omniscientjoker/obd_brz_gauge/docs/VEHICLE_CONFIG.md

# 车型配置开发指南 / Vehicle Configuration Developer Guide

## 概述 / Overview

本项目采用**数据驱动**的车型配置架构。添加新车型**只需编辑 2 个文件**，不需要修改任何解析逻辑代码。

This project uses a **data-driven** vehicle configuration architecture. Adding a new vehicle **only requires editing 2 files** — no parser logic changes needed.

```
默认行为 = OBD2 标准协议 (SAE J1979)
Default  = Standard OBD2 protocol (SAE J1979)

只有在 vehicle_custom_config.h 里声明了的车型，才会使用自定义 CAN 规则或油温公式。
Only vehicles declared in vehicle_custom_config.h use custom CAN rules or oil temp formulas.
```

---

## 文件结构 / File Structure

| 文件 / File | 作用 / Purpose |
|---|---|
| `vehicle_profiles.c` | 车型基础参数 (传动比/档位/轮胎) / Basic params (gear ratios/tire) |
| `vehicle_custom_config.h` | 自定义覆盖 (CAN规则/油温公式/协议) / Custom overrides |
| `vehicle_profiles.h` | 结构体定义 + API / Struct definitions + API |

---

## 添加新车型 / Adding a New Vehicle

### 步骤 1: 基础参数 / Step 1: Basic Parameters

在 `vehicle_profiles.c` 的 `s_profiles[]` 数组末尾添加：

```c
{
    .name = "My Car",                    // 显示名称 / Display name
    .final_drive_ratio = 3.73f,          // 主减速比 / Final drive ratio
    .tire_rolling_radius_m = 0.310f,     // 轮胎滚动半径(m) / Tire rolling radius
    .gear_count = 6,                     // 前进挡数 / Forward gears
    .gear_ratios = {0, 3.63f, 2.38f, 1.56f, 1.18f, 1.00f, 0.81f},
    .gear_tolerance = 0.15f,             // 档位识别容差 / Gear detection tolerance
    // 以下字段可省略，默认值 = 纯 OBD2 标准
    // Fields below are optional, defaults = pure OBD2 standard
},
```

**如果新车只需要标准 OBD2**，到这里就结束了！不需要步骤 2。

**If the new car only needs standard OBD2**, you're done! Skip to step 2 is not needed.

---

### 步骤 2: 自定义覆盖 (可选) / Step 2: Custom Overrides (Optional)

在 `vehicle_custom_config.h` 中添加 CAN 规则和/或油温公式，然后在 `s_vehicle_overrides[]` 表中注册。

#### 2a. CAN 广播解码规则 / CAN Broadcast Decode Rules

如果车型支持通过 CAN 总线广播帧读取数据 (比 OBD2 PID 更快)：

```c
// 定义规则表 / Define rule table
static const can_rule_t can_rules_mycar[] = {
    // CAN_ID  位偏移  位长  乘数        偏移    通道
    { 0x140,   16,    14,   1.0f,       0.0f,  CH_RPM },
    { 0x140,   48,     8,   100.0f/255, 0.0f,  CH_TPS },
    { 0x360,   16,     8,   1.0f,     -40.0f,  CH_OIL_TEMP },
    { 0x360,   24,     8,   1.0f,     -40.0f,  CH_COOLANT },
};
```

**位域说明 / Bit field explanation:**
- `bit_off`: 从 LSB 开始的位偏移。Byte0 bit0 = 0, Byte0 bit7 = 7, Byte1 bit0 = 8, ...
- `bit_len`: 位长度。14 位 = 最大 16383
- `scale/offset`: 最终值 = raw × scale + offset

**可用通道 / Available channels:**
`CH_RPM`, `CH_SPEED`, `CH_OIL_TEMP`, `CH_COOLANT`, `CH_TPS`, `CH_LOAD`, `CH_INTAKE`, `CH_BOOST`,
`CH_TPMS_FL`, `CH_TPMS_FR`, `CH_TPMS_RL`, `CH_TPMS_RR`

### 四轮胎压 CAN 规则 / TPMS CAN rules

TPMS 规则的最终值单位必须是 `bar`。四个轮位可以来自同一帧或不同帧；解码器会保留已收到的轮位，直到它们超时失效。

```c
// 以下 CAN ID、字节位置与公式仅是结构示例，不能直接用于任何福特车辆。
static const can_rule_t can_rules_ford_tpms[] = {
    { 0x000, 0, 8, 0.01f, 0.0f, CH_TPMS_FL },
    { 0x000, 8, 8, 0.01f, 0.0f, CH_TPMS_FR },
    { 0x000, 16, 8, 0.01f, 0.0f, CH_TPMS_RL },
    { 0x000, 24, 8, 0.01f, 0.0f, CH_TPMS_RR },
};
```

在把 Ford 规则加入车型表前，必须通过实车 CAN 日志确认 CAN ID、轮位和换算公式。不要用猜测的 ID 启用 CAN 监听。

#### 2b. 油温公式 / Oil Temperature Formula

```c
// 标准 PID 01 5C / Standard PID
static const oil_formula_t oil_std = {
    OIL_STD_PID, {0x5C}, 1, 0, 1, 1.0f, -40.0f, 0
};

// UDS Mode 22 (单字节) / UDS single byte
static const oil_formula_t oil_uds_1byte = {
    OIL_UDS_22, {0x11,0x1F}, 2, 0, 1, 1.0f, -50.0f, 0
};

// UDS Mode 22 (双字节大端) / UDS double byte big-endian
static const oil_formula_t oil_uds_2byte = {
    OIL_UDS_22, {0x13,0x10}, 2, 0, 2, 0.01f, -40.0f, 0
};
```

**公式类型 / Formula types:**

| 类型 / Type | 说明 / Description | 命令格式 / Command |
|---|---|---|
| `OIL_STD_PID` | 标准 Mode 01 | `01 XX\r` |
| `OIL_UDS_22` | UDS Mode 22 | `22 XX XX\r` |
| `OIL_SPECIAL` | 特殊解析 (需额外代码) | 自定义 / Custom |

#### 2c. Ford BCM Mode 22 胎压候选 / Ford BCM Mode 22 TPMS candidate

当前工程的 `Mondeo 2.0T TPMS (candidate)` 配置先采用公开 Fusion Hybrid 资料作为待验证方案：请求头为 `ATSH726`，每次发送一个 `22 DID`，压力原始值为响应中的两个大端字节，公式为：

```text
pressure_bar = raw_u16 × 0.05 × 0.0689475729
```

轮位与 DID 映射为：`FL=2813`、`FR=2814`、`RL=2816`、`RR=2815`。例如 `62 28 13 02 80` 中 `raw=0x0280=640`，结果约为 `2.21 bar`。该映射和公式来自北美/欧洲 Fusion 资料，尚未证明适用于中国版 2014 Mondeo；实车验证时应记录 FORScan BCMii 的 DID、响应字节和机械表压力，再替换 `tpms_fusion_candidate[]`。

#### 2d. 注册覆盖 / Register Override

在 `s_vehicle_overrides[]` 数组中添加：

```c
{
    .match_name      = "My Car",              // 必须与 vehicle_profiles.c 中的 name 完全匹配
    .can_rules       = can_rules_mycar,       // CAN 规则 (NULL = 不用 CAN)
    .can_rule_count  = 4,
    .oil_primary     = &oil_uds_1byte,        // 油温主公式 (NULL = 标准 01 5C)
    .oil_secondary   = &oil_std,              // 备用公式 (主公式连续失败后回退)
    .forced_protocol = 6,                     // ELM327 协议 (0 = 自动探测)
    .functional_addr = false,                 // true = ATSH7DF (BMW 等)
    .obd_timeout     = 0x0F,                  // ATST 超时 (0 = 默认 0x19)
    .has_boost       = false,                 // 涡轮车 = true
    .poll_gap_ms     = 1,                     // 轮询间隔 ms (0 = 默认 30ms)
},
```

---

## 完整示例 / Complete Example

添加一辆 Mazda MX-5 ND (已有配置，作为参考)：

```c
// vehicle_profiles.c — 基础参数
{
    .name = "MX-5 ND",
    .final_drive_ratio = 2.866f,
    .tire_rolling_radius_m = 0.300f,
    .gear_count = 6,
    .gear_ratios = {0, 5.087f, 2.991f, 2.035f, 1.594f, 1.286f, 1.000f},
    .gear_tolerance = 0.15f,
},

// vehicle_custom_config.h — 自定义覆盖
static const oil_formula_t oil_mazda_1310 = {
    OIL_UDS_22, {0x13,0x10}, 2, 0, 2, 0.01f, -40.0f, 0
};
static const oil_formula_t oil_mazda_111f = {
    OIL_UDS_22, {0x11,0x1F}, 2, 0, 1, 1.0f, -50.0f, 0
};

// 在 s_vehicle_overrides[] 中:
{
    .match_name  = "MX-5 ND",
    .oil_primary = &oil_mazda_1310,
    .oil_secondary = &oil_mazda_111f,
    .obd_timeout = 0x0A,
    .poll_gap_ms = 1,
},
```

---

## 运行时查找逻辑 / Runtime Lookup

```
vehicle_profile_get_override()
    ├── 找到 override → 使用自定义 CAN 规则 / 油温公式
    └── 返回 NULL    → 纯 OBD2 标准协议 (01 0C/0D/05/5C/0F/04/11/42)
```

---

## CAN 规则解析器 API / CAN Rule Parser API

```c
// 通用位域提取 / Generic bit extraction
bool can_extract_bits_le(const uint8_t data[8],
                         uint8_t bit_off, uint8_t bit_len,
                         uint32_t *out);

// 遍历规则表, 匹配 CAN ID, 写入 channels[] / Apply rules to channels
void can_apply_rules(const can_rule_t *rules, uint8_t count,
                     uint16_t can_id, const uint8_t data[8],
                     float channels[CH_COUNT]);

// 构建油温查询命令 / Build oil temp query command
const char *oil_formula_build_cmd(const oil_formula_t *f,
                                  char *buf, size_t buflen);

// 解析油温响应 / Parse oil temp response
int16_t oil_formula_parse_resp(const oil_formula_t *f,
                               const uint32_t *resp_data,
                               uint8_t resp_len);
```

---

## 注意事项 / Notes

1. **name 必须完全匹配** — `vehicle_profiles.c` 和 `vehicle_custom_config.h` 中的 `match_name` 必须字符串完全一致。
2. **OIL_SPECIAL 类型** — 目前用于 Toyota Mode 21 及其他少量遗留特殊解析，这类逻辑较复杂，仍需 `elm327_ble_client.c` 中的专用代码处理。未来可逐步迁移。
3. **CAN 规则中的位偏移** — 采用 SAE J1939 风格的位编号：Byte0 的 LSB = bit 0，Byte1 的 LSB = bit 8。
4. **双字节公式** — `resp_bytes=2` 时按大端序组合：`value = data[byte] * 256 + data[byte+1]`。
5. **回退机制** — `oil_primary` 连续失败 5 次后自动切换到 `oil_secondary`。

---

## 迁移状态 / Migration Status

当前 `vehicle_custom_config.h` 已包含所有车型的覆盖配置数据表。`elm327_ble_client.c` 中的旧 switch/case 代码仍在运行，后续将逐步迁移到通用解析器。新旧代码通过 `vehicle_profile_get_override()` 桥接。

The `vehicle_custom_config.h` already contains override data for all vehicles. The legacy switch/case in `elm327_ble_client.c` is still active and will be migrated to the generic parsers incrementally. The bridge is `vehicle_profile_get_override()`.
