omniscientjoker/obd_brz_gauge/hardware/electronics/power_pd_3x5v_r3/huaqiu/01_PCB/VIPPO_HOLES.csv

Via_ID | Gerber_X_mm | Gerber_Y_mm | CPL_X_mm | CPL_Y_mm | Drill_mm | Net | Pads_to_review
0e456552-56f2-44fa-b054-f9a385a9bfb4 | 99.200000 | -110.920000 | 40.200000 | 16.580000 | 0.3 | /GND | UPD.11; UPD.paste
114b2d22-c867-4a10-897a-41550a063cea | 120.720000 | -106.100000 | 61.720000 | 21.400000 | 0.3 | /GND | U4.9; U4.paste
163f1c95-62bf-4fa8-81e0-24cd7ac145cc | 76.620000 | -105.400000 | 17.620000 | 22.100000 | 0.3 | /GND | U2.9; U2.paste
1710671c-4a24-4615-903f-2607074c7a94 | 76.620000 | -106.100000 | 17.620000 | 21.400000 | 0.3 | /GND | U2.9; U2.paste
1b0cda9b-186d-41db-aa2c-3c16d014d6e4 | 99.100000 | -112.820000 | 40.100000 | 14.680000 | 0.3 | /GND | UPD.11; UPD.paste
2441409e-41e9-4236-9071-cb9c7f7919b5 | 109.455000 | -85.720000 | 50.455000 | 41.780000 | 0.3 | /PRE_CENTRE | COUT3A.1
2ded97ac-5890-47ff-a0bc-a73e4bc1ce08 | 123.100000 | -119.410000 | 64.100000 | 8.090000 | 0.3 | /UV_IN | RUVINL.1
3136d08a-dee5-408d-994e-a182a233d700 | 120.220000 | -103.900000 | 61.220000 | 23.600000 | 0.3 | /GND | U4.9; U4.paste
337a6ea5-dd0f-4ca0-b42b-aeff975e14ff | 97.450000 | -105.500000 | 38.450000 | 22.000000 | 0.3 | /GND | U3.9; U3.paste
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
