omniscientjoker/obd_brz_gauge/hardware/electronics/power_pd_3x5v_r4/huaqiu/01_PCB/VIPPO_HOLES.csv

# No VIPPO required for R4: SMD pad/via intersections = 0.
Via_ID | Gerber_X_mm | Gerber_Y_mm | CPL_X_mm | CPL_Y_mm | Drill_mm | Net | Pads_to_review
