omniscientjoker/obd_brz_gauge/hardware/3dModel/base_detail.png

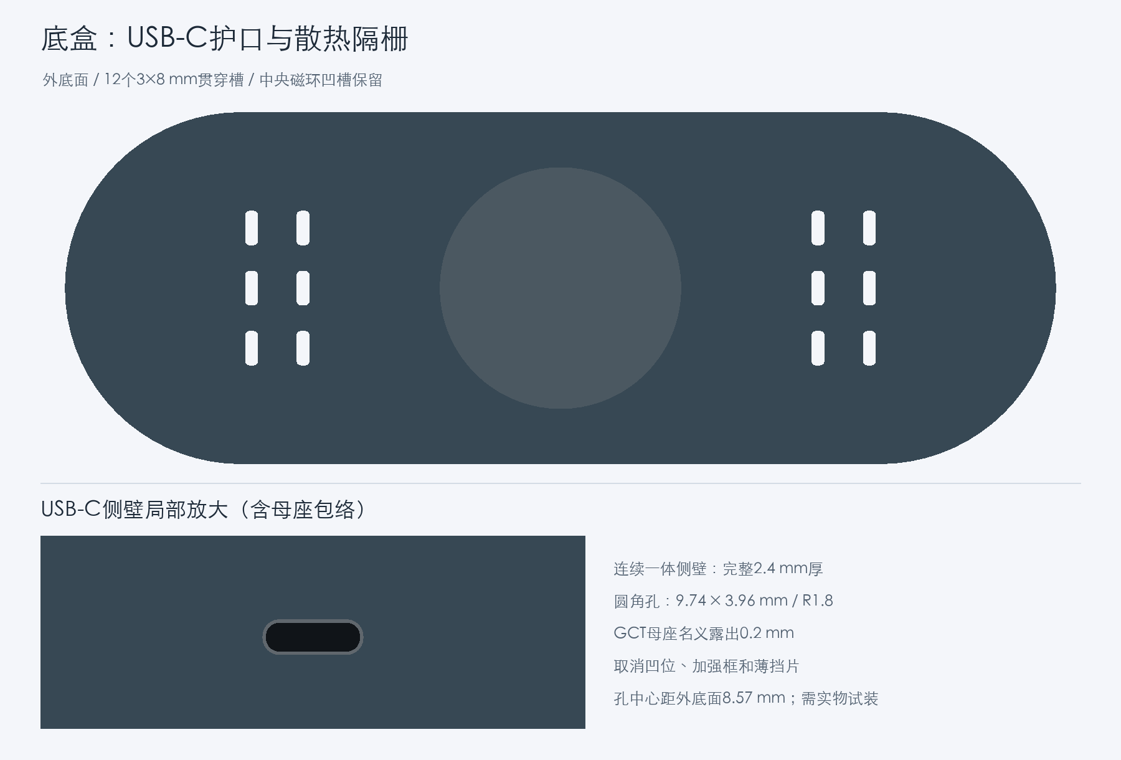
hardware/3dModel/base_detail.png
