omniscientjoker/obd_brz_gauge/hardware/3dModel/carrier_detail.png

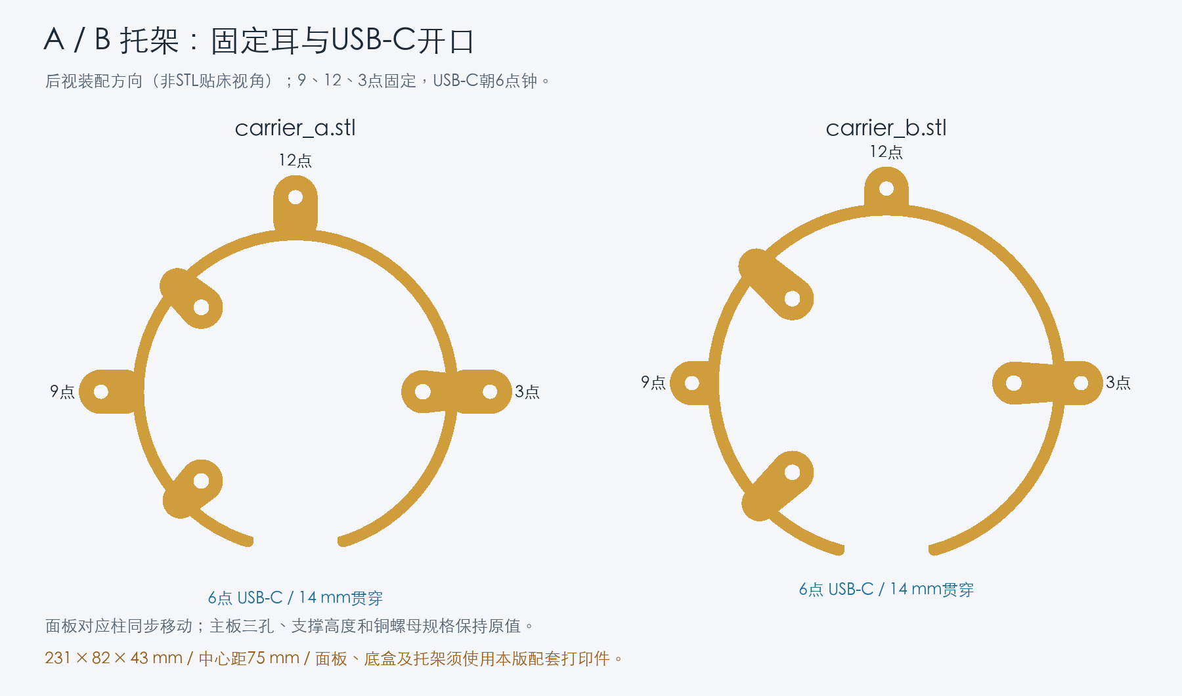
hardware/3dModel/carrier_detail.png
