omniscientjoker/obd_brz_gauge/hardware/3dModel/preview.png

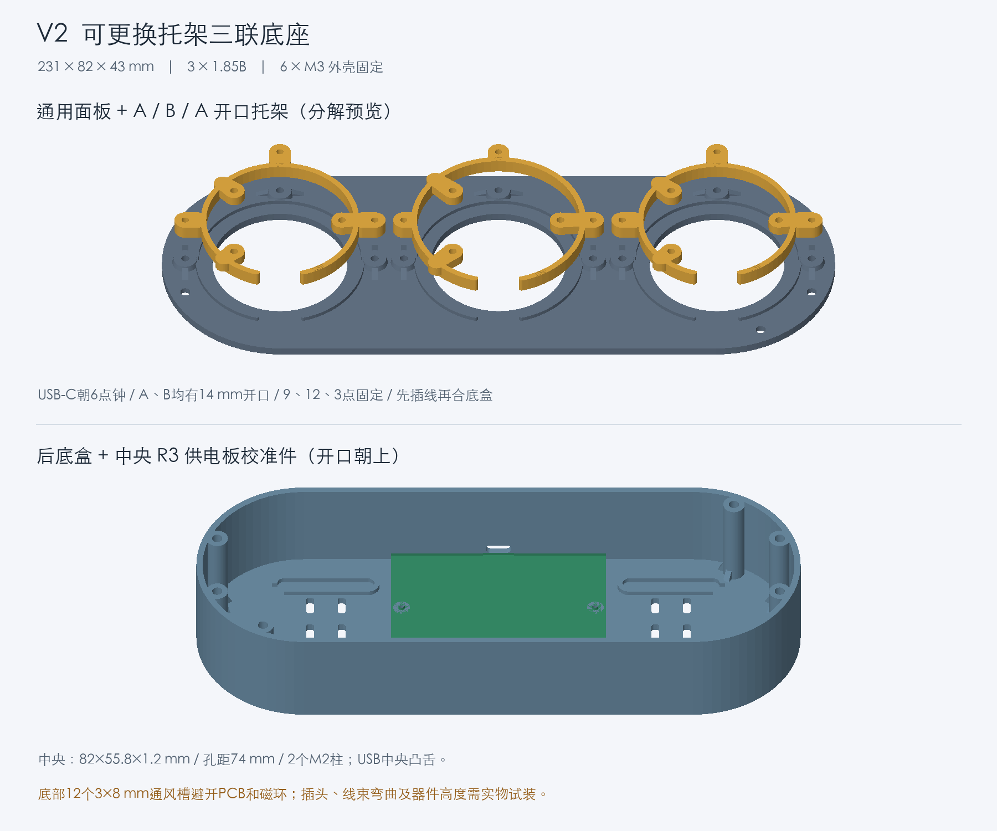
hardware/3dModel/preview.png
