omniscientjoker/obd_brz_gauge/hardware/electronics/placement.png

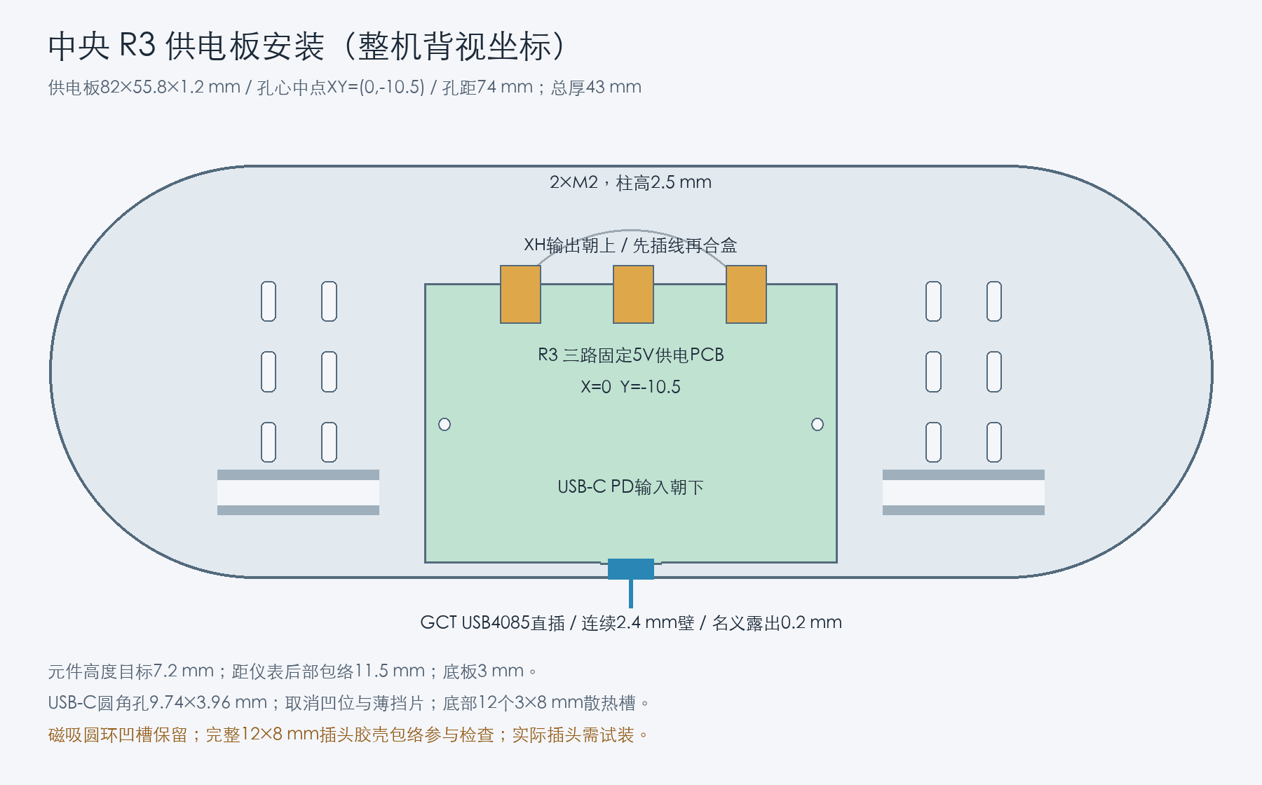
hardware/electronics/placement.png
