omniscientjoker/obd_brz_gauge/hardware/electronics/power_pd_3x5v_r4/huaqiu/HUAQIU_ORDER_REMARKS.txt

项目：三联仪表三路5V电源板，交付R4-HUAQIU-20261026-R1，电气R4-ERC-20261026。
PCB：4层FR-4，建议Tg≥150°C，82×55.8mm，成品厚1.2mm，内外层目标35µm/1oz，沉金，绿油双面白字。
盘中孔：R4无SMD焊盘内过孔，不需要VIPPO树脂塞孔；`01_PCB/VIPPO_HOLES.csv`为空表。请按Gerber/CAM确认普通过孔、阻焊桥和钢网开口。
装配：每板双面SMT82件（Top31/Bottom51），另有4件THT后焊，总86件、31种制造商MPN。J1=GCT USB4085-GF-A；J2/J3/J4=JST S2B-XH-A(LF)(SN)。
输入：固定15V PD；三路约5V，每路1.5A设计负载。先做首板带载、纹波、保护和封闭底盒温升验收。
