omniscientjoker/obd_brz_gauge/outputs/huaqiu_pcba_20261026_r1/huaqiu_official_bom_template.xls

序号 | 产品分类 | 品牌 | 型号* | 规格参数描述* | 封装* | 位号* | 单机用量* | 备注
1 | 贴片电容 | FH | 0402B103K250NT | 25V 10nF | 402 | C3,C4,C5,C6 | 4
2 | 贴片电容 | Samsung | CL05B104K05NNNC | 16V 100nF | 402 | C1,C2, | 2
3 | 肖特基二极管 | MDD | 1N5819 |  | SOD-323 | D1,D2 | 2
4 | IC | ROHM | BR24L08FV-WE2 |  |  | U3 | 1
5 | IC | ROHM | BR34E02FVT-3E2 |  |  | U2, U3 | 2
6 | 贴片电阻 | UniOhm | 0402WGF330JTCE | 33Ω | 402 | R4 | 1
7 | 贴片电阻 | Uniohm | 0402WGF1001TCE | 1KΩ | 402 | R1,R2,R3,R4 | 4
8 | 贴片电阻 | UniOhm | 0603WAJ0105T5E | 1MΩ | 603 | R5 | 1
9 | 贴片电阻 | Walsin | WR06X225JTL | 2.2MΩ | 603 | R37 | 1
10 | 贴片电阻 | RALEC | RTT03102JTP | 1KΩ | 603 | R46 | 1
11 | 二极管 | MCC | 1N4148W-TP |  | SOD123 | D3 | 1
