omniscientjoker/obd_brz_gauge/outputs/r4-bom-format-20261027/BOM_HUAQIU_SMT.xlsx

序号 | 产品分类 | 品牌 | 型号* | 规格参数描述* | 封装* | 位号* | 单机用量* | 备注
1 | 保险丝 | Bourns | SF-1206F300-2 | 3.00A, 63Vdc, 50A interruption at63V, fast-acting; cold R typ0.02325ohm; I2t0.501A2s | 1206 fast-acting SMD fuse | F1 | 1 | SMT; TOP=1; Exact recommended land pattern already present as GaugePower:SF_1206F_Recommended; do not use generic 1206 resistor land.
2 | TVS | Vishay General Semiconductor | SMAJ16A-E3/61 | Unidirectional TVS, 16V VRWM, 17.8..19.7V VBR, 26V clamp at15.4A, 400W 10/1000us | DO-214AC (SMA) | DTVS | 1 | SMT; TOP=1; Cathode band must connect VRAW (pad1), anode GND(pad2); polarity controlled by assembly drawing. Source datasheet retried independently.
3 | 电阻 | Vishay | TNPW0402100KBEED | 100kohm ±0.1%, ±25ppm/K thin-film, 75V operating rating | 0402 (1005 metric) | RUVINH | 1 | SMT; BOTTOM=1; 1.00±0.05 x0.50±0.05 x0.35±0.05mm; ED paper tape10k reel; manufacturer catalog range ends100k for0402.
4 | 电阻 | Vishay | TNPW040210K0BEED | 10kohm ±0.1%, ±25ppm/K thin-film | 0402 (1005 metric) | ROVINL,RUVINL | 2 | SMT; BOTTOM=2; 1.00±0.05 x0.50±0.05 x0.35±0.05mm; ED paper tape10k reel.
5 | 电阻 | Bourns | CRT0402-BY-1333GLF | 133kohm ±0.1%, ±25ppm/C thin-film precision; E96 standard value | 0402 (1005 metric) | ROVINH | 1 | SMT; BOTTOM=1; Catalog0402 B/Y range10..255k, 25V working, 1/16W. G=10k paper tape. Replaces135k in source board after electrical review: input OVP approximately17.16V. 1.00±0.10 x0.50±0.05 x0.30±0.05mm.
6 | 电阻 | Vishay | TNPW060356K0FEEA | 56kohm ±1%, ±25ppm/K thin-film | 0603 (1608 metric) | RSET | 1 | SMT; TOP=1; E24;1.55±0.05 x0.85±0.10 x0.45±0.10mm; EA5k reel.
7 | 电阻 | Vishay | TNPW06038K25FEEA | 8.25kohm ±1%, ±25ppm/K thin-film; exact E96 value | 0603 (1608 metric) | RILIMIN | 1 | SMT; BOTTOM=1; Do not substitute8.2k without electrical approval.
8 | 电阻 | Vishay | TNPW0603100KBEEA | 100kohm ±0.1%, ±25ppm/K thin-film | 0603 (1608 metric) | RPGH | 1 | SMT; BOTTOM=1; EA5k reel; precision divider value.
9 | 电阻 | Vishay | TNPW0603100KFEEA | 100kohm ±1%, ±25ppm/K thin-film pull-up | 0603 (1608 metric) | RPGPU | 1 | SMT; BOTTOM=1; Source board value has no tolerance; selected1% grade.
10 | 电阻 | Vishay | TNPW060310K0BEEA | 10kohm ±0.1%, ±25ppm/K thin-film precision divider | 0603 (1608 metric) | RFL2,RFL3,RFL4,ROVL2,ROVL3,ROVL4,RPGL,RUVL2,RUVL3,RUVL4 | 10 | SMT; BOTTOM=10; EA5k reel.
11 | 电阻 | Vishay | TNPW060352K3BEEA | 52.3kohm ±0.1%, ±25ppm/K thin-film; E96 value | 0603 (1608 metric) | RFH2,RFH3,RFH4 | 3 | SMT; BOTTOM=3; Buck feedback upper divider, exact value required.
12 | 电阻 | Vishay | TNPW060384K5FEEA | 84.5kohm ±1%, ±25ppm/K thin-film; E96 value | 0603 (1608 metric) | RLIM2,RLIM3,RLIM4 | 3 | SMT; BOTTOM=3; Electrical-reviewed replacement for57.6k, paired withXAL5050-682MEC. Do not revert to old43k BOM.
13 | 电阻 | Vishay | TNPW060324K0FEEA | 24kohm ±1%, ±25ppm/K thin-film compensation resistor | 0603 (1608 metric) | RC2,RC3,RC4 | 3 | SMT; BOTTOM=3; Source value has no tolerance; chosen1% exceeds former5% note.
14 | 电阻 | Vishay | TNPW060328K0BEEA | 28kohm ±0.1%, ±25ppm/K thin-film; E96 value | 0603 (1608 metric) | RUVH2,RUVH3,RUVH4 | 3 | SMT; BOTTOM=3; Output eFuse UVLO upper divider.
15 | 电阻 | Vishay | TNPW060334K0BEEA | 34kohm ±0.1%, ±25ppm/K thin-film; E96 value | 0603 (1608 metric) | ROVH2,ROVH3,ROVH4 | 3 | SMT; BOTTOM=3; Output eFuse OVP upper divider.
16 | 电阻 | Vishay | TNPW06031K65FEEA | 1.65kohm ±1%, ±25ppm/K thin-film; E96 value | 0603 (1608 metric) | RILM2,RILM3,RILM4 | 3 | SMT; BOTTOM=3; Exact output eFuse current-limit value; do not use old conflictingLCSC code.
17 | 电容 | Murata | GRM188R61H105KAALD | 1uF±10%,50Vdc,X5R,-55..85C,1.6±0.1x0.8±0.1x0.8±0.1mm | 0603 (1608 metric) | CPD,CSYS | 2 | SMT; TOP=2; OfficialPIM confirms exact packagedMPN. X5R is85C max; DC bias reduces effective capacitance; qualification is prototype-only pending15V bias/load/temperature verification.
18 | 电容 | Murata | GRM188R61H105KAALD | 1uF±10%,50Vdc,X5R,-55..85C,1.6±0.1x0.8±0.1x0.8±0.1mm | 0603 (1608 metric) | CUSB2,CUSB3,CUSB4 | 3 | SMT; BOTTOM=3; Upgrades old25V1uF to50V common procurement item without reducing rating. X5R85Cmax; validate5V effective capacitance.
19 | 电容 | Murata | GRM188R71H104KA93D | 100nF±10%,50Vdc,X7R,-55..125C,1.6±0.1x0.8±0.1x0.8±0.1mm | 0603 (1608 metric) | CB2,CB3,CB4,CDIN | 4 | SMT; TOP=3, BOTTOM=1; Exact packagedMPN and dimensions independently obtained from officialPIM; current PIM record has no direct PDF asset link, retain rawAPI evidence.
20 | 电容 | Murata | GRM31CR61H106KA12L | 10uF±10%,50Vdc,X5R,-55..85C,3.2±0.2x1.6±0.2x1.6±0.2mm | 1206 (3216 metric) | CIN2A,CIN2B,CIN3A,CIN3B,CIN4A,CIN4B | 6 | SMT; TOP=6; Replaces unspecified/unverified1206X7R entry with realmanufacturer model.85Cmax; DC bias at15V must be checked;82uF35Vpolymer retained on input. Do not substitute imaginaryGRM31CR71H106KA12L.
21 | 电容 | Murata | GRM31CR61E226KE15L | 22uF±10%,25Vdc,X5R,-55..85C,3.2±0.2x1.6±0.2x1.6±0.2mm | 1206 (3216 metric) | COUT2A,COUT2B,COUT3A,COUT3B,COUT4A,COUT4B | 6 | SMT; BOTTOM=6; OfficialPIM confirms exact real25V1206model. Replaces non-existentGRM31CR7YA226KE15L.25V survives input-OVP tolerance;85Cmax. Back side1.8mmmax invalidates former1mmclearance. Effective5V capacitance and transient stability require firstboard test. CurrentPIMrecord has no directPDFasset link; retainAPIevidence.
22 | 电容 | Murata | GRM1885C1H272JA01D | 2.7nF±5%,50Vdc,C0G,-55..125C,1.6±0.1x0.8±0.1x0.8±0.1mm | 0603 (1608 metric) | CC2,CC3,CC4 | 3 | SMT; BOTTOM=3; Compensation capacitor;C0Gselected for voltage/temperature stability. Real packagedMPN verified byPIM.
23 | 电容 | Murata | GRM1885C1H822JA01D | 8.2nF±5%,50Vdc,C0G,-55..125C,1.6±0.1x0.8±0.1x0.8±0.1mm | 0603 (1608 metric) | CD2,CD3,CD4 | 3 | SMT; BOTTOM=3; OutputeFuse dV/dt capacitor; real packagedMPN verified byPIM.
24 | 聚合物电容 | Panasonic | 35SVPK82M | 82uF±20%,35Vpolymer,ESR25mohm,allowable ripple3.06A at100kHz up to105C | SMD OS-CON E7, diameter8.0mm, height6.9mm | CBULK1,CBULK2,CBULK3 | 3 | SMT; TOP=3; Panasonic manufacturer (notNichicon). E7dimensionsD8.0±0.5,L6.9+0.1/-0.4,W/H8.3±0.2,C9.0±0.2,P3.2ref. Cathode band mustmatchnegativepad2; compatibleCP_Elec_8x6.9. Maxcomponentheight7.0mm.
25 | 聚合物电容 | Panasonic | 25SVPF100M | 100uF±20%,25Vpolymer,ESR24mohm,allowable ripple3.2A at100kHz up to105C | SMD OS-CON E7, diameter8.0mm, height6.9mm | CE2,CE3,CE4 | 3 | SMT; TOP=3; Panasonic manufacturer (notNichicon). E7D8.0±0.5,L6.9+0.1/-0.4,W/H8.3±0.2,C9.0±0.2,P3.2ref. Negativebandtopad2;compatibleCP_Elec_8x6.9.
26 | 电感 | Coilcraft | XAL5050-682MEC | 6.8uH±20%;Isat6A at30%Ldrop;Irms4.7A@20Crise/6.4A@40Crise;DCR26.75mohmtyp/29.45max | XAL5050,5.28x5.48mm,H5.1mmmax | L2,L3,L4 | 3 | SMT; TOP=3; Useofficial1.18x4.70mmpads atX±1.655mm,centers3.31mm. Body5.28±0.2x5.48±0.2. Shortleadbar shouldfaceSW(highdv/dt)side;non-polar. Mechanicalsource:https://www.coilcraft.com/getattachment/6feccfd5-e7e4-46e3-aa0b-2222b11f7450/xal5000d.gif?lang=en-US. Keepnew84.5kRLIMpairing.
27 | 集成电路 | WCH | CH224A | USB PD sink voltage request controller; 56k configuration requests fixed 15V | ESSOP-10-EP, pitch 1.00mm | UPD | 1 | SMT; TOP=1; Official EP0 maps to local PCB pad11, GND; use ESSOP10, not QFN CH224K. EP local land2.1x3.3mm; supplier package/CAM confirmation required.
28 | 集成电路 | Texas Instruments | TPS26630RGER | 4.5..60V input eFuse, adjustable overvoltage and current protection | RGE VQFN-24 4x4mm, EP2.7x2.7mm | UIN | 1 | SMT; TOP=1; Retain exact TPS26630; MODE open latch-off. NC19..24 intentionally open; EP25 GND.
29 | 集成电路 | Richtek | RT7272BGSP | 36V 3A synchronous buck; fixed feedback network approx4.984V; RLIM84.5k | SOP-8 exposed pad, GSP Option2 EP2.4x3.4mm | U2,U3,U4 | 3 | SMT; TOP=3; Use B GSP PSOP8 option2; EP9 GND. No pin-compatible substitution assumed.
30 | 集成电路 | Texas Instruments | TPS259470LRPWR | 2.7..23V output eFuse with reverse-current blocking; typ2.028A limit at1.65k | RPW0010A WQFN-10, 2x2mm pitch0.4mm | UP2,UP3,UP4 | 3 | SMT; TOP=3; L variant latches after thermal fault; do not replace with A auto-retry. AUXOFF3 and ITIMER10 intentionally open.
