omniscientjoker/obd_brz_gauge/outputs/three_gauge_v2_parts_20261026/三联仪表V2_完整配件采购表.xlsx

Sheet: 配件采购
三联仪表配件采购表
数量基准：一套三联表，1主表＋2从表，6点合盒。底座R3-SHELL-POST-20261026，电源板R3-ERC-20261026。
主板固定的9颗M2螺丝及主板侧螺母需先确认实物；其余螺丝长度按不加垫片计算。
采购选择、已备数量和采购状态可修改。已备默认0不代表已核对库存；建议备货含备件。可选、内含及自制线束用料默认不采购。
铜螺母：螺纹×长度×外径；螺丝：螺纹×杆长。尺寸单位mm。内部5V只接主板USB-C，不能接3.7V电池口。
编号 | 类别 | 配件名称 | 规格／型号 | 单套用量 | 单位 | 建议备货 | 采购选择 | 已备数量 | 待购数量 | 采购状态 | 用途／确认事项
F01 | 紧固件 | M2热熔铜螺母 | M2 × 长3 × 外径Ø3 mm | 11 | 颗 | 15 | 采购 | 0 | 15 | 未下单 | 面板9颗＋电源板2颗。打印底孔Ø2.7、深3.3；先用相同打印材料试配。
F02 | 紧固件 | M3热熔铜螺母 | M3 × 长6 × 外径Ø4.2 mm | 6 | 颗 | 8 | 采购 | 0 | 8 | 未下单 | 底盒6根合盒柱。底孔Ø3.9、深7；柱径Ø8.2。螺母与柱顶齐平。
F03 | 紧固件 | 托架固定螺丝 | M2×8 mm，机牙，盘头或圆柱头 | 9 | 颗 | 12 | 采购 | 0 | 12 | 未下单 | 每个托架3颗。穿过5 mm厚安装耳后旋入面板铜螺母约3 mm；按不加垫片计算。
F04 | 紧固件 | 电源板固定螺丝 | M2×4 mm，机牙，盘头 | 2 | 颗 | 4 | 采购 | 0 | 4 | 未下单 | PCB厚1.2 mm，名义旋入2.8 mm。按不加垫片计算；锁紧时确认不顶底。
F05 | 紧固件 | 合盒固定螺丝 | M3×6 mm，低圆头，头径≤6 mm | 6 | 颗 | 8 | 采购 | 0 | 8 | 未下单 | 面板头槽Ø6.2、深0.8。选非锥形沉头；螺钉头不保证完全齐平。
F06 | 待确认 | 主板固定螺丝 | M2机牙；长度待确认 | 9 | 颗 |  | 待确认 | 0 | 待确认 | 待确认 | 托架支撑厚3.6 mm、孔Ø2.6。先核对主板螺纹柱及有效深度，再定杆长；不能直接认定M2×6或M2×8。
F07 | 条件配件 | 主板侧普通螺母 | M2，厚度及安装空间待确认 | 9 | 颗 |  | 待确认 | 0 | 待确认 | 待确认 | 仅主板为普通通孔且采用穿板螺丝时考虑。已有螺纹柱则不用；装入空间未验证。
E01 | 主件 | 屏幕主板组合模组 | ESP32-S3＋1.85寸屏幕，A/B对应版本 | 3 | 套 | 3 | 采购 | 0 | 3 | 未下单 | 一主两从，按现有模组数量填写已备。外径Ø48.08对应A托架；Ø55对应B托架。
E02 | 主件 | 中央三路5V电源板成品 | R3-ERC-20261026，82×55.8×1.2 mm | 1 | 块 | 1 | 采购 | 0 | 1 | 未下单 | 要求完成双面SMT及4个通孔连接器后焊。包含CH224A、三路RT7272B、保护和滤波元件，详见电源板物料。
W01 | 连接线 | 内部供电成品线束 | JST XH 2.50 mm 2P → 低矮弯头USB-C公头 | 3 | 条 | 3 | 采购 | 0 | 3 | 未下单 | 真铜24AWG，单条含线尾目标≤150 mm，先试长。XH 1脚＋5V、2脚GND；USB-C应有正确源端CC，Rp 22kΩ声明1.5A。
W02 | 连接线 | 外部供电线 | USB-C ↔ USB-C，额定≥3A | 1 | 条 | 1 | 采购 | 0 | 1 | 未下单 | 保留CC及D+/D−。长度按车内走线选择；已校核胶壳宽≤12、高≤8 mm，外部直插路径25 mm。
E03 | 电源 | PD车充／电源适配器 | 明确支持USB PD固定15V⎓3A PDO | 1 | 个 | 1 | 待确认 | 0 | 待确认 | 待确认 | 现有Anker 35W/40W车充需核对该端口铭牌档位。板上已带PD诱骗，无需外接诱骗模块。
D01 | 线束自制 | XH线壳 | JST XHP-2，2P、2.50 mm | 3 | 个 | 5 | 不采购 | 0 | 0 | 不适用 | 仅自制W01时采购，和成品线二选一。不要以PH2.0或2.54 mm仿品替代。
D02 | 线束自制 | XH压接端子 | JST SXH-001T-P0.6 | 6 | 个 | 10 | 不采购 | 0 | 0 | 不适用 | 每条红黑线各1个。适配AWG28～22；压接必须匹配线径和绝缘外径。
D03 | 线束自制 | 红色正极电线 | 24AWG，多股真铜 | 0.45 | 米 | 1.00 | 不采购 | 0.00 | 0.00 | 不适用 | 3条线单根导体累计最多约0.45 m，不含损耗。原厂XH目录3A条件为22AWG，不能套用到任意24AWG成品线。
D04 | 线束自制 | 黑色地线 | 24AWG，多股真铜 | 0.45 | 米 | 1.00 | 不采购 | 0.00 | 0.00 | 不适用 | 长度同红线。避免铜包铝；使用22AWG时需同步确认端子、线槽和弯曲空间。
D05 | 线束自制 | USB-C公头线尾 | 低矮弯头，固定5V源端，正确CC配置 | 3 | 个 | 3 | 不采购 | 0 | 0 | 不适用 | 仅自制W01时采购。核对两种插入方向均可供电；不能仅凭两根红黑线判定兼容。
P01 | PCBA内含 | 输入USB-C母座 | GCT USB4085-GF-A | 1 | 个 | 1 | 不采购 | 0 | 0 | 随PCBA | E02成品板必须含此通孔件。16个接点＋4个壳体焊脚全部后焊；不另买面板式母座或延长模块。
P02 | PCBA内含 | 三路输出板端插座 | JST S2B-XH-A(LF)(SN)，卧式2P、2.50 mm | 3 | 个 | 3 | 不采购 | 0 | 0 | 随PCBA | J2/J3/J4，包含在E02制造订单内。线端配XHP-2；与D01线壳是不同零件。
A01 | 装配辅料 | 屏幕缓冲软垫 | 硅胶／软泡棉，厚0.5 mm | 3 | 组 | 4 | 采购 | 0 | 4 | 未下单 | 按A/B玻璃边缘裁切，避开Ø46.4 mm显示孔。可采购约150×150×0.5 mm片材1片，裁切数量按实物排版。
A02 | 可选辅料 | 磁吸定位环／引磁环 | 外径Ø56 mm，厚0.4 mm | 1 | 个 | 1 | 不采购 | 0 | 0 | 不适用 | 对应底盒Ø56.3、深0.45 mm凹槽。内径和吸附能力按所购圆环及车载支架确认。
A03 | 可选辅料 | 磁环固定背胶 | 薄耐温背胶，与圆环配套裁切 | 1 | 份 | 1 | 不采购 | 0 | 0 | 不适用 | 与A02同时选。0.4 mm圆环在0.45 mm槽内仅余0.05 mm；需齐平时胶厚不能超过剩余尺寸。
A04 | 建议辅料 | 线束小扎带 | 建议宽≤2 mm、长约80 mm | 6 | 根 | 10 | 不采购 | 0 | 0 | 不适用 | 数量为装配建议，非模型固定用量。不能勒压FPC、玻璃或PCB器件。
A05 | 建议辅料 | 耐温绝缘胶带 | 聚酰亚胺等绝缘胶带，建议宽10 mm | 1 | 卷 | 1 | 不采购 | 0 | 0 | 不适用 | 用于线束及局部绝缘，已有可复用；不能遮住通风槽。
A06 | 建议辅料 | 绝缘热缩管 | 建议内径2～3 mm，按实际接头选择 | 0.30 | 米 | 1.00 | 不采购 | 0.00 | 0.00 | 不适用 | 仅有焊接线接头时需要；数量为备料建议。成品绝缘线束可不购买。
O01 | 可选功能 | MicroSD卡 | 建议16～32GB，格式与固件要求一致 | 1 | 张 | 1 | 不采购 | 0 | 0 | 不适用 | 用于主表启动动画及告警媒体；已有卡可复用。此容量为采购建议，不是模型尺寸要求。
O02 | 可选功能 | 主表喇叭及配套线 | 8Ω、2W、2030规格，主板原厂配套插头 | 1 | 套 | 1 | 不采购 | 0 | 0 | 不适用 | 优先复用随板喇叭。具体线端型号需核对主板；当前底盒未设计独立喇叭安装座。
O03 | 数据连接 | OBD蓝牙适配器 | Vgate vLinker FD+ | 1 | 个 | 1 | 不采购 | 1 | 0 | 已有 | 复用现有适配器，接车辆OBD口；不安装在底盒内。
O04 | 可选安装 | 车载磁吸支架 | 与Ø56 mm圆环兼容，承重及耐温待核对 | 1 | 个 | 1 | 不采购 | 0 | 0 | 不适用 | 车型和安装位置尚未确定。三联表重量、振动和安装面的粘接需实物验证。
T01 | 装配工具 | 热熔螺母安装工具 | 温控电烙铁＋适配M2/M3的热熔头 | 1 | 套 | 1 | 不采购 | 0 | 0 | 不适用 | 装配工具，非装入件。已有工具可复用；M2/M3铜螺母先用试块试装。
T02 | 装配工具 | 螺丝批套装 | 与实际所购M2/M3螺丝头型匹配 | 1 | 套 | 1 | 不采购 | 0 | 0 | 不适用 | 内六角或十字由螺丝头型决定，不混用批头；已有可复用。
T03 | 装配工具 | 游标卡尺 | 建议分辨率0.01 mm | 1 | 把 | 1 | 不采购 | 0 | 0 | 不适用 | 检查打印孔、模组高度、插头和主板侧螺纹柱；已有可复用。
T04 | 装配工具 | 万用表 | 直流电压、通断测量 | 1 | 台 | 1 | 不采购 | 0 | 0 | 不适用 | 通电接主板前核对三路输出5V及线束极性；已有可复用。
T05 | 自制工具 | 端子压接钳 | 适配SXH-001T-P0.6及所选线径 | 1 | 把 | 1 | 不采购 | 0 | 0 | 不适用 | 仅自制线束时需要。通用杜邦端子钳不一定适配此端子。
T06 | 后焊工具 | 焊接耗材 | 电子焊锡、助焊剂等 | 1 | 套 | 1 | 不采购 | 0 | 0 | 不适用 | 仅自行后焊连接器或线束时需要；购买完整PCBA和成品线时可省。
T07 | 可选工具 | USB PD测试仪 | 支持读取15V PDO并测量≥3A | 1 | 台 | 1 | 不采购 | 0 | 0 | 不适用 | 用于确认车充档位及协商结果；已有可复用，不能替代完整电子负载测试。

Sheet: 电源板物料
电源板制造物料（单板）
R3-ERC-20261026，31种MPN、86件：82件SMT＋4件通孔连接器。另需4层82×55.8×1.2 mm裸PCB一块；相同MPN已合并。
本页是E02成品电源板的组成明细。采购成品PCBA时由工厂配料，不与配件采购表重复购买。
按厂家完整MPN和当前封装采购；3路连续1.5A为设计目标，PD协商、带载、纹波、保护及温升仍需首板验证。
部分X5R电容最高85°C；外壳、线束和器件高度仍需实物试装。原始制造用量不含工厂上机损耗。
序号 | 物料类别 | 制造商 | 完整MPN | 电气规格 | 封装／外形 | 位号 | 单板用量 | 焊接方式 | 安装面及数量 | 关键装配要求 | 厂家数据手册
1 | 保险丝 | Bourns | SF-1206F300-2 | 3.00A, 63Vdc, 50A interruption at63V, fast-acting; cold R typ0.02325ohm; I2t0.501A2s | 1206 fast-acting SMD fuse | F1 | 1 | SMT | 正面1 / 背面0 | 快断3A，采用专用推荐焊盘，不能以普通1206电阻焊盘替代。 | https://www.bourns.com/docs/product-datasheets/sf1206f.pdf
2 | TVS | Vishay General Semiconductor | SMAJ16A-E3/61 | Unidirectional TVS, 16V VRWM, 17.8..19.7V VBR, 26V clamp at15.4A, 400W 10/1000us | DO-214AC (SMA) | DTVS | 1 | SMT | 正面1 / 背面0 | 单向TVS；阴极色带接VRAW的1脚，阳极接GND的2脚。 | https://www.vishay.com/docs/88390/smaj50a.pdf
3 | 电阻 | Vishay | TNPW0402100KBEED | 100kohm +/-0.1%, +/-25ppm/K thin-film, 75V operating rating | 0402 (1005 metric) | RUVINH | 1 | SMT | 正面0 / 背面1 | 按完整MPN采购，保持阻值和精度；0.1%不可降为1%。 | https://www.vishay.com/docs/28758/tnpw_e3.pdf
4 | 电阻 | Vishay | TNPW040210K0BEED | 10kohm +/-0.1%, +/-25ppm/K thin-film | 0402 (1005 metric) | ROVINL、RUVINL | 2 | SMT | 正面0 / 背面2 | 按完整MPN采购，保持阻值和精度；0.1%不可降为1%。 | https://www.vishay.com/docs/28758/tnpw_e3.pdf
5 | 电阻 | Bourns | CRT0402-BY-1333GLF | 133kohm +/-0.1%, +/-25ppm/C thin-film precision; E96 standard value | 0402 (1005 metric) | ROVINH | 1 | SMT | 正面0 / 背面1 | 133kΩ、0.1%，输入过压分压；不得回退旧135kΩ。 | https://www.bourns.com/docs/product-datasheets/crt.pdf
6 | 电阻 | Vishay | TNPW060356K0FEEA | 56kohm +/-1%, +/-25ppm/K thin-film | 0603 (1608 metric) | RSET | 1 | SMT | 正面1 / 背面0 | 按完整MPN采购，保持阻值和精度；0.1%不可降为1%。 | https://www.vishay.com/docs/28758/tnpw_e3.pdf
7 | 电阻 | Vishay | TNPW06038K25FEEA | 8.25kohm +/-1%, +/-25ppm/K thin-film; exact E96 value | 0603 (1608 metric) | RILIMIN | 1 | SMT | 正面0 / 背面1 | 8.25kΩ、1%；不要直接替换为8.2kΩ。 | https://www.vishay.com/docs/28758/tnpw_e3.pdf
8 | 电阻 | Vishay | TNPW0603100KBEEA | 100kohm +/-0.1%, +/-25ppm/K thin-film | 0603 (1608 metric) | RPGH | 1 | SMT | 正面0 / 背面1 | 按完整MPN采购，保持阻值和精度；0.1%不可降为1%。 | https://www.vishay.com/docs/28758/tnpw_e3.pdf
9 | 电阻 | Vishay | TNPW0603100KFEEA | 100kohm +/-1%, +/-25ppm/K thin-film pull-up | 0603 (1608 metric) | RPGPU | 1 | SMT | 正面0 / 背面1 | 按完整MPN采购，保持阻值和精度；0.1%不可降为1%。 | https://www.vishay.com/docs/28758/tnpw_e3.pdf
10 | 电阻 | Vishay | TNPW060310K0BEEA | 10kohm +/-0.1%, +/-25ppm/K thin-film precision divider | 0603 (1608 metric) | RFL2、RFL3、RFL4、ROVL2、ROVL3、ROVL4、RPGL、RUVL2、RUVL3、RUVL4 | 10 | SMT | 正面0 / 背面10 | 按完整MPN采购，保持阻值和精度；0.1%不可降为1%。 | https://www.vishay.com/docs/28758/tnpw_e3.pdf
11 | 电阻 | Vishay | TNPW060352K3BEEA | 52.3kohm +/-0.1%, +/-25ppm/K thin-film; E96 value | 0603 (1608 metric) | RFH2、RFH3、RFH4 | 3 | SMT | 正面0 / 背面3 | 按完整MPN采购，保持阻值和精度；0.1%不可降为1%。 | https://www.vishay.com/docs/28758/tnpw_e3.pdf
12 | 电阻 | Vishay | TNPW060384K5FEEA | 84.5kohm +/-1%, +/-25ppm/K thin-film; E96 value | 0603 (1608 metric) | RLIM2、RLIM3、RLIM4 | 3 | SMT | 正面0 / 背面3 | 84.5kΩ、1%，与当前6.8µH电感配套，勿用旧限流值。 | https://www.vishay.com/docs/28758/tnpw_e3.pdf
13 | 电阻 | Vishay | TNPW060324K0FEEA | 24kohm +/-1%, +/-25ppm/K thin-film compensation resistor | 0603 (1608 metric) | RC2、RC3、RC4 | 3 | SMT | 正面0 / 背面3 | 按完整MPN采购，保持阻值和精度；0.1%不可降为1%。 | https://www.vishay.com/docs/28758/tnpw_e3.pdf
14 | 电阻 | Vishay | TNPW060328K0BEEA | 28kohm +/-0.1%, +/-25ppm/K thin-film; E96 value | 0603 (1608 metric) | RUVH2、RUVH3、RUVH4 | 3 | SMT | 正面0 / 背面3 | 按完整MPN采购，保持阻值和精度；0.1%不可降为1%。 | https://www.vishay.com/docs/28758/tnpw_e3.pdf
15 | 电阻 | Vishay | TNPW060334K0BEEA | 34kohm +/-0.1%, +/-25ppm/K thin-film; E96 value | 0603 (1608 metric) | ROVH2、ROVH3、ROVH4 | 3 | SMT | 正面0 / 背面3 | 按完整MPN采购，保持阻值和精度；0.1%不可降为1%。 | https://www.vishay.com/docs/28758/tnpw_e3.pdf
16 | 电阻 | Vishay | TNPW06031K65FEEA | 1.65kohm +/-1%, +/-25ppm/K thin-film; E96 value | 0603 (1608 metric) | RILM2、RILM3、RILM4 | 3 | SMT | 正面0 / 背面3 | 1.65kΩ、1%；决定输出eFuse限流。 | https://www.vishay.com/docs/28758/tnpw_e3.pdf
17 | 电容 | Murata | GRM188R61H105KAALD | 1uF+/-10%,50Vdc,X5R,-55..85C,1.6+/-0.1x0.8+/-0.1x0.8+/-0.1mm | 0603 (1608 metric) | CPD、CSYS、CUSB2、CUSB3、CUSB4 | 5 | SMT | 正面2 / 背面3 | X5R最高85°C；同一MPN合并正反面共5颗，确认带偏压有效容量。 | https://pim.murata.com/asset/pim4/ceramicCapacitorSMD/GRM188R61H105KAAL-01-EN_PDF_CERAMICCAPACITORSMD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
18 | 电容 | Murata | GRM188R71H104KA93D | 100nF+/-10%,50Vdc,X7R,-55..125C,1.6+/-0.1x0.8+/-0.1x0.8+/-0.1mm | 0603 (1608 metric) | CB2、CB3、CB4、CDIN | 4 | SMT | 正面3 / 背面1 | 按完整MPN、介质和封装采购，位置及面别按装配资料。 | https://pim.murata.com/en-global/pim/details/?partNum=GRM188R71H104KA93%23
19 | 电容 | Murata | GRM31CR61H106KA12L | 10uF+/-10%,50Vdc,X5R,-55..85C,3.2+/-0.2x1.6+/-0.2x1.6+/-0.2mm | 1206 (3216 metric) | CIN2A、CIN2B、CIN3A、CIN3B、CIN4A、CIN4B | 6 | SMT | 正面6 / 背面0 | X5R最高85°C；15V偏压下有效容量须首板验证，不替换为未核实的X7R料号。 | https://pim.murata.com/asset/pim4/ceramicCapacitorSMD/GRM31CR61H106KA12-01-EN_PDF_CERAMICCAPACITORSMD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
20 | 电容 | Murata | GRM31CR61E226KE15L | 22uF+/-10%,25Vdc,X5R,-55..85C,3.2+/-0.2x1.6+/-0.2x1.6+/-0.2mm | 1206 (3216 metric) | COUT2A、COUT2B、COUT3A、COUT3B、COUT4A、COUT4B | 6 | SMT | 正面0 / 背面6 | X5R最高85°C；背面器件最大高约1.8 mm，确认5V有效容量与阶跃响应。 | https://pim.murata.com/en-global/pim/details/?partNum=GRM31CR61E226KE15%23
21 | 电容 | Murata | GRM1885C1H272JA01D | 2.7nF+/-5%,50Vdc,C0G,-55..125C,1.6+/-0.1x0.8+/-0.1x0.8+/-0.1mm | 0603 (1608 metric) | CC2、CC3、CC4 | 3 | SMT | 正面0 / 背面3 | 按完整MPN、介质和封装采购，位置及面别按装配资料。 | https://pim.murata.com/asset/pim4/ceramicCapacitorSMD/GRM1885C1H272JA01-01A-EN_PDF_CERAMICCAPACITORSMD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
22 | 电容 | Murata | GRM1885C1H822JA01D | 8.2nF+/-5%,50Vdc,C0G,-55..125C,1.6+/-0.1x0.8+/-0.1x0.8+/-0.1mm | 0603 (1608 metric) | CD2、CD3、CD4 | 3 | SMT | 正面0 / 背面3 | 按完整MPN、介质和封装采购，位置及面别按装配资料。 | https://pim.murata.com/asset/pim4/ceramicCapacitorSMD/GRM1885C1H822JA01-01A-EN_PDF_CERAMICCAPACITORSMD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
23 | 聚合物电容 | Panasonic | 35SVPK82M | 82uF+/-20%,35Vpolymer,ESR25mohm,allowable ripple3.06A at100kHz up to105C | SMD OS-CON E7, diameter8.0mm, height6.9mm | CBULK1、CBULK2、CBULK3 | 3 | SMT | 正面3 / 背面0 | 输入聚合物电容；Ø8、标称高6.9 mm，最大约7.0 mm。负极色带接2脚。 | https://industrial.panasonic.com/cdbs/www-data/pdf/AAB8000/AAB8000C226.pdf
24 | 聚合物电容 | Panasonic | 25SVPF100M | 100uF+/-20%,25Vpolymer,ESR24mohm,allowable ripple3.2A at100kHz up to105C | SMD OS-CON E7, diameter8.0mm, height6.9mm | CE2、CE3、CE4 | 3 | SMT | 正面3 / 背面0 | 输出聚合物电容；Ø8、标称高6.9 mm。负极色带接2脚。 | https://industrial.panasonic.com/cdbs/www-data/pdf/AAB8000/AAB8000C177.pdf
25 | 电感 | Coilcraft | XAL5050-682MEC | 6.8uH+/-20%;Isat6A at30%Ldrop;Irms4.7A@20Crise/6.4A@40Crise;DCR26.75mohmtyp/29.45max | XAL5050,5.28x5.48mm,H5.1mmmax | L2、L3、L4 | 3 | SMT | 正面3 / 背面0 | 6.8µH，最大高5.1 mm，须用当前专用焊盘；与84.5kΩ限流电阻配套。 | https://www.coilcraft.com/getmedia/49bc46c8-4b2c-45b9-9b6c-2eaa235ea698/xal50xx.pdf
26 | 集成电路 | WCH | CH224A | USB PD sink voltage request controller; 56k configuration requests fixed 15V | ESSOP-10-EP, pitch 1.00mm | UPD | 1 | SMT | 正面1 / 背面0 | ESSOP10带裸露焊盘，固定请求15V；不是QFN封装的CH224K。 | https://www.wch-ic.com/download/file?id=302
27 | 集成电路 | Texas Instruments | TPS26630RGER | 4.5..60V input eFuse, adjustable overvoltage and current protection | RGE VQFN-24 4x4mm, EP2.7x2.7mm | UIN | 1 | SMT | 正面1 / 背面0 | 输入eFuse，MODE悬空采用锁断；保留准确后缀与封装。 | https://www.ti.com/lit/ds/symlink/tps2663.pdf
28 | 集成电路 | Richtek | RT7272BGSP | 36V 3A synchronous buck; fixed feedback network approx4.984V; RLIM84.5k | SOP-8 exposed pad, GSP Option2 EP2.4x3.4mm | U2、U3、U4 | 3 | SMT | 正面3 / 背面0 | 三路独立降压；GSP Option2裸露焊盘，输出约4.984V。 | https://www.richtek.com/assets/product_file/RT7272B/RT7272B_DS-11.pdf
29 | 集成电路 | Texas Instruments | TPS259470LRPWR | 2.7..23V output eFuse with reverse-current blocking; typ2.028A limit at1.65k | RPW0010A WQFN-10, 2x2mm pitch0.4mm | UP2、UP3、UP4 | 3 | SMT | 正面3 / 背面0 | L锁断版本，带反向阻断；不可直接换A自动重试版本。 | https://www.ti.com/lit/ds/symlink/tps25947.pdf
30 | 连接器 | GCT | USB4085-GF-A | USB 2.0 Type-C receptacle; 5A collective VBUS / 48V; design uses 15V/3A; THT contacts and four shell anchors | USB-C 16-contact, all THT, PCB top mount | J1 | 1 | THT | 正面1 / 背面0 | 通孔后焊：16接点＋4壳体脚全部焊接；与底盒USB圆角孔配套。 | https://gct.co/files/drawings/usb4085.pdf
31 | 连接器 | JST | S2B-XH-A(LF)(SN) | 2-position side-entry XH header; 3A with specified AWG22 contact/cable system | JST XH 2P horizontal, pitch 2.50mm, THT | J2、J3、J4 | 3 | THT | 正面3 / 背面0 | 3个卧式XH 2P，双面回流后焊接；配XHP-2。目录3A要求匹配22AWG线束。 | https://www.jst.com/wp-content/uploads/2021/01/eXH-new.pdf
