omniscientjoker/obd_brz_gauge/hardware/electronics/power_pd_3x5v_r3/huaqiu/03_THT/BOM_HUAQIU_THT.csv

序号 | 产品分类 | 品牌 | 型号* | 规格参数描述* | 封装* | 位号* | 单机用量* | 备注
1 | 连接器 | GCT | USB4085-GF-A | USB 2.0 Type-C receptacle; 5A collective VBUS / 48V; design uses 15V/3A; THT contacts and four shell anchors | USB-C 16-contact, all THT, PCB top mount | J1 | 1 | THT; TOP=1; GCT drawing revision B 28/02/23. Post-solder all contacts and four SH anchors after both SMT reflows. Inspect 0.85 mm pitch contacts; do not substitute shorter-body HRO footprint.
2 | 连接器 | JST | S2B-XH-A(LF)(SN) | 2-position side-entry XH header; 3A with specified AWG22 contact/cable system | JST XH 2P horizontal, pitch 2.50mm, THT | J2,J3,J4 | 3 | THT; TOP=3; Factory hand/selective solder after SMT. Mating XHP-2 housing, SXH-001T-P0.6 contacts; use manufacturer-approved crimped 22AWG harness. Do not substitute PH2.0 or 2.54mm clone.
