omniscientjoker/obd_brz_gauge/hardware/electronics/power_pd_3x5v_r4/production/reference/power_pd_3x5v_r3.xh-bom.csv

Refs | Value | Footprint | Qty | DNP
CB2 | 100nF 50V | Capacitor_SMD:C_0603_1608Metric | 1
CB3 | 100nF 50V | Capacitor_SMD:C_0603_1608Metric | 1
CB4 | 100nF 50V | Capacitor_SMD:C_0603_1608Metric | 1
CBULK1 | 82uF 35V POLYMER | Capacitor_SMD:CP_Elec_8x6.9 | 1
CBULK2 | 82uF 35V POLYMER | Capacitor_SMD:CP_Elec_8x6.9 | 1
CBULK3 | 82uF 35V POLYMER | Capacitor_SMD:CP_Elec_8x6.9 | 1
CC2 | 2.7nF C0G 50V | Capacitor_SMD:C_0603_1608Metric | 1
CC3 | 2.7nF C0G 50V | Capacitor_SMD:C_0603_1608Metric | 1
CC4 | 2.7nF C0G 50V | Capacitor_SMD:C_0603_1608Metric | 1
CD2 | 8.2nF C0G 50V | Capacitor_SMD:C_0603_1608Metric | 1
CD3 | 8.2nF C0G 50V | Capacitor_SMD:C_0603_1608Metric | 1
CD4 | 8.2nF C0G 50V | Capacitor_SMD:C_0603_1608Metric | 1
CDIN? | 100nF 50V | Capacitor_SMD:C_0603_1608Metric | 1
CE2 | 100uF 25V POLYMER | Capacitor_SMD:CP_Elec_8x6.9 | 1
CE3 | 100uF 25V POLYMER | Capacitor_SMD:CP_Elec_8x6.9 | 1
CE4 | 100uF 25V POLYMER | Capacitor_SMD:CP_Elec_8x6.9 | 1
CIN2A? | 10uF 50V X5R | Capacitor_SMD:C_1206_3216Metric | 1
CIN2B? | 10uF 50V X5R | Capacitor_SMD:C_1206_3216Metric | 1
CIN3A? | 10uF 50V X5R | Capacitor_SMD:C_1206_3216Metric | 1
CIN3B? | 10uF 50V X5R | Capacitor_SMD:C_1206_3216Metric | 1
CIN4A? | 10uF 50V X5R | Capacitor_SMD:C_1206_3216Metric | 1
CIN4B? | 10uF 50V X5R | Capacitor_SMD:C_1206_3216Metric | 1
COUT2A? | 22uF 25V X5R | Capacitor_SMD:C_1206_3216Metric | 1
COUT2B? | 22uF 25V X5R | Capacitor_SMD:C_1206_3216Metric | 1
COUT3A? | 22uF 25V X5R | Capacitor_SMD:C_1206_3216Metric | 1
COUT3B? | 22uF 25V X5R | Capacitor_SMD:C_1206_3216Metric | 1
COUT4A? | 22uF 25V X5R | Capacitor_SMD:C_1206_3216Metric | 1
COUT4B? | 22uF 25V X5R | Capacitor_SMD:C_1206_3216Metric | 1
CPD? | 1uF 50V X5R | Capacitor_SMD:C_0603_1608Metric | 1
CSYS? | 1uF 50V X5R | Capacitor_SMD:C_0603_1608Metric | 1
CUSB2 | 1uF 50V X5R | Capacitor_SMD:C_0603_1608Metric | 1
CUSB3 | 1uF 50V X5R | Capacitor_SMD:C_0603_1608Metric | 1
CUSB4 | 1uF 50V X5R | Capacitor_SMD:C_0603_1608Metric | 1
DTVS? | SMAJ16A | Diode_SMD:D_SMA | 1
F1 | 3A 63VDC FAST | GaugePower:SF_1206F_Recommended | 1
J1 | USB-C PD 15V/3A | Connector_USB:USB_C_Receptacle_GCT_USB4085 | 1
J2 | XH2.50-2P 5V OUTPUT | GaugePower:JST_XH_S2B-XH-A_1x02_P2.50mm_Horizontal_Assembly | 1
J3 | XH2.50-2P 5V OUTPUT | GaugePower:JST_XH_S2B-XH-A_1x02_P2.50mm_Horizontal_Assembly | 1
J4 | XH2.50-2P 5V OUTPUT | GaugePower:JST_XH_S2B-XH-A_1x02_P2.50mm_Horizontal_Assembly | 1
L2 | 6.8uH / 6A Isat | Inductor_SMD:L_Coilcraft_XAL5050-XXX | 1
L3 | 6.8uH / 6A Isat | Inductor_SMD:L_Coilcraft_XAL5050-XXX | 1
L4 | 6.8uH / 6A Isat | Inductor_SMD:L_Coilcraft_XAL5050-XXX | 1
RC2 | 24k | Resistor_SMD:R_0603_1608Metric | 1
RC3 | 24k | Resistor_SMD:R_0603_1608Metric | 1
RC4 | 24k | Resistor_SMD:R_0603_1608Metric | 1
RFH2 | 52.3k 0.1% | Resistor_SMD:R_0603_1608Metric | 1
RFH3 | 52.3k 0.1% | Resistor_SMD:R_0603_1608Metric | 1
RFH4 | 52.3k 0.1% | Resistor_SMD:R_0603_1608Metric | 1
RFL2 | 10k 0.1% | Resistor_SMD:R_0603_1608Metric | 1
RFL3 | 10k 0.1% | Resistor_SMD:R_0603_1608Metric | 1
RFL4 | 10k 0.1% | Resistor_SMD:R_0603_1608Metric | 1
RILIMIN? | 8.25k 1% | Resistor_SMD:R_0603_1608Metric | 1
RILM2 | 1.65k 1% | Resistor_SMD:R_0603_1608Metric | 1
RILM3 | 1.65k 1% | Resistor_SMD:R_0603_1608Metric | 1
RILM4 | 1.65k 1% | Resistor_SMD:R_0603_1608Metric | 1
RLIM2 | 84.5k 1% | Resistor_SMD:R_0603_1608Metric | 1
RLIM3 | 84.5k 1% | Resistor_SMD:R_0603_1608Metric | 1
RLIM4 | 84.5k 1% | Resistor_SMD:R_0603_1608Metric | 1
ROVH2 | 34k 0.1% | Resistor_SMD:R_0603_1608Metric | 1
ROVH3 | 34k 0.1% | Resistor_SMD:R_0603_1608Metric | 1
ROVH4 | 34k 0.1% | Resistor_SMD:R_0603_1608Metric | 1
ROVINH? | 133k 0.1% | Resistor_SMD:R_0402_1005Metric | 1
ROVINL? | 10k 0.1% | Resistor_SMD:R_0402_1005Metric | 1
ROVL2 | 10k 0.1% | Resistor_SMD:R_0603_1608Metric | 1
ROVL3 | 10k 0.1% | Resistor_SMD:R_0603_1608Metric | 1
ROVL4 | 10k 0.1% | Resistor_SMD:R_0603_1608Metric | 1
RPGH? | 100k 0.1% | Resistor_SMD:R_0603_1608Metric | 1
RPGL? | 10k 0.1% | Resistor_SMD:R_0603_1608Metric | 1
RPGPU? | 100k | Resistor_SMD:R_0603_1608Metric | 1
RSET? | 56k 1% | Resistor_SMD:R_0603_1608Metric | 1
RUVH2 | 28k 0.1% | Resistor_SMD:R_0603_1608Metric | 1
RUVH3 | 28k 0.1% | Resistor_SMD:R_0603_1608Metric | 1
RUVH4 | 28k 0.1% | Resistor_SMD:R_0603_1608Metric | 1
RUVINH? | 100k 0.1% | Resistor_SMD:R_0402_1005Metric | 1
RUVINL? | 10k 0.1% | Resistor_SMD:R_0402_1005Metric | 1
RUVL2 | 10k 0.1% | Resistor_SMD:R_0603_1608Metric | 1
RUVL3 | 10k 0.1% | Resistor_SMD:R_0603_1608Metric | 1
RUVL4 | 10k 0.1% | Resistor_SMD:R_0603_1608Metric | 1
U2 | RT7272BGSP | GaugePower:RT7272BGSP_PSOP8_Option2 | 1
U3 | RT7272BGSP | GaugePower:RT7272BGSP_PSOP8_Option2 | 1
U4 | RT7272BGSP | GaugePower:RT7272BGSP_PSOP8_Option2 | 1
UIN? | TPS26630RGER | GaugePower:Texas_RGE0024H_VQFN-24-1EP_4x4mm_P0.5mm_EP2.7x2.7mm_Assembly | 1
UP2 | TPS259470LRPWR | GaugePower:TI_RPW0010A | 1
UP3 | TPS259470LRPWR | GaugePower:TI_RPW0010A | 1
UP4 | TPS259470LRPWR | GaugePower:TI_RPW0010A | 1
UPD? | CH224A | Package_SO:SSOP-10-1EP_3.9x4.9mm_P1mm_EP2.1x3.3mm | 1
