omniscientjoker/obd_brz_gauge/outputs/huaqiu_pcba_20261026_r1/bom_top.png

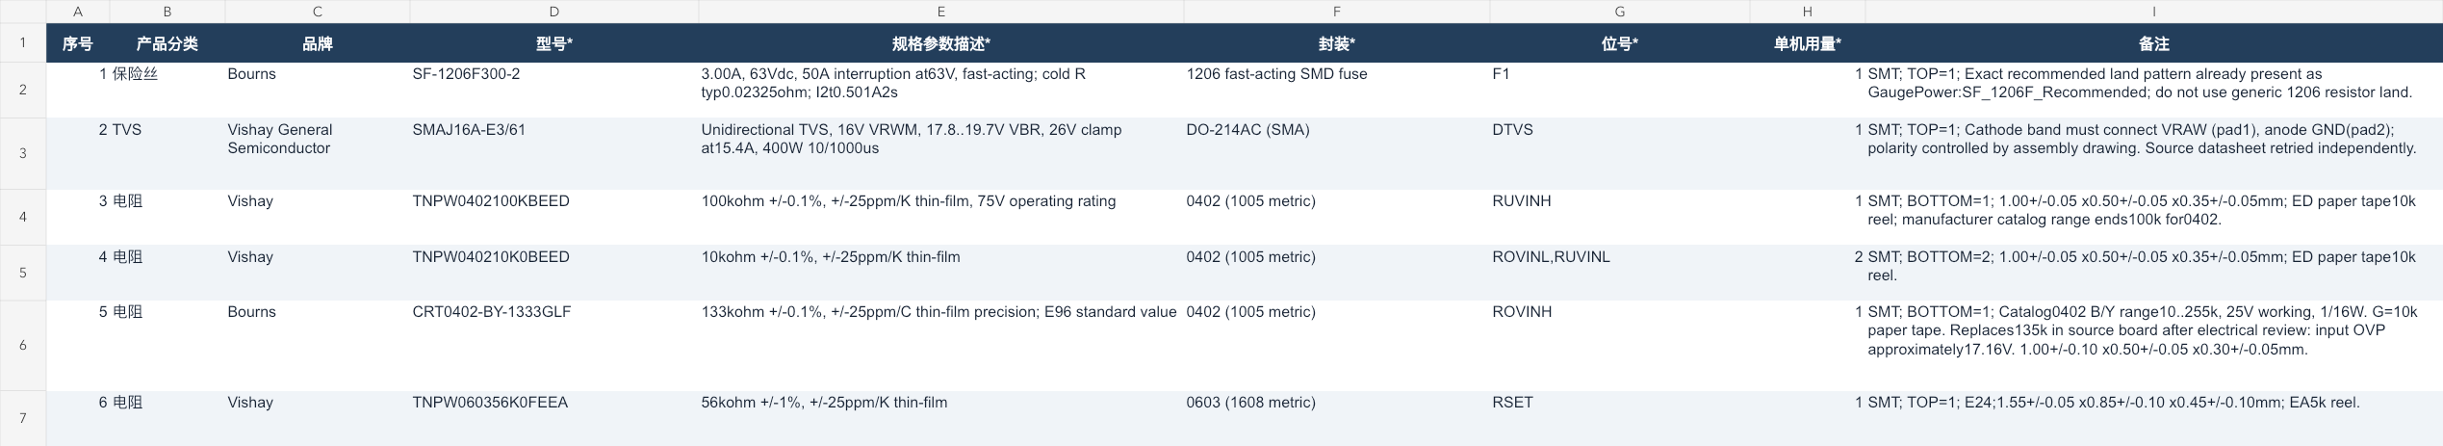
outputs/huaqiu_pcba_20261026_r1/bom_top.png
