omniscientjoker/obd_brz_gauge/hardware/3dModel/stl/power_board_mockup.stl

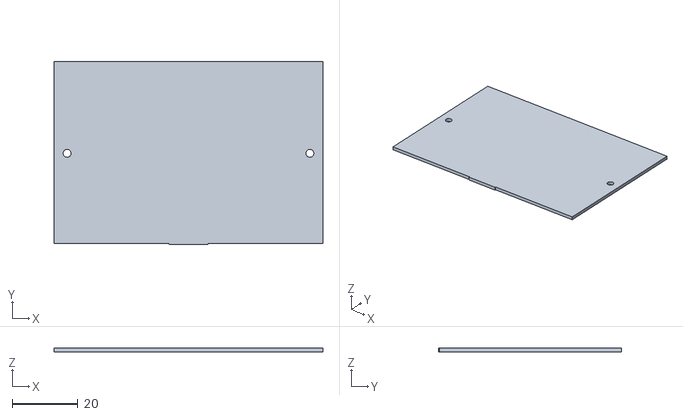
[picture p7: CAD file, 2026-10-30]
hardware/3dModel/stl/power_board_mockup.stl
82.0 x 55.8 x 1.20
