omniscientjoker/obd_brz_gauge/hardware/electronics/power_board_outline.dxf

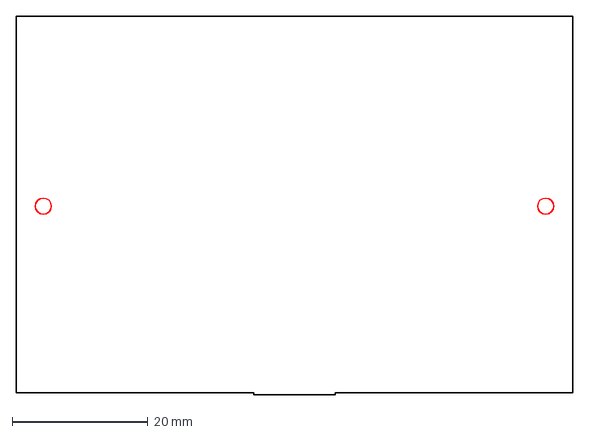
[picture p8: CAD file, 2026-10-30]
hardware/electronics/power_board_outline.dxf
82.0 x 55.8 mm
