omniscientjoker/obd_brz_gauge/hardware/3dModel/stl/base.stl

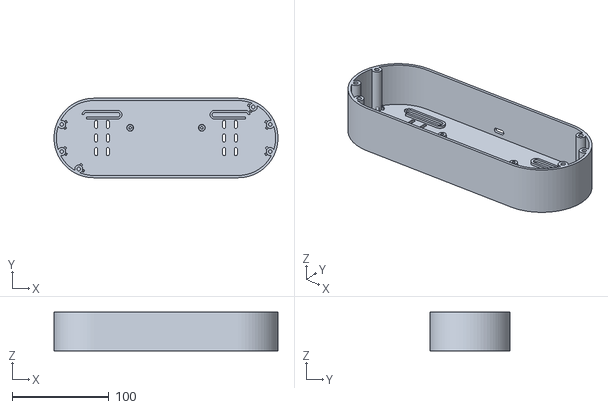
[picture p9: CAD file, 2026-10-30]
hardware/3dModel/stl/base.stl
231.0 x 82.0 x 40.0
