omniscientjoker/obd_brz_gauge/hardware/3dModel/stl/fit_template.stl

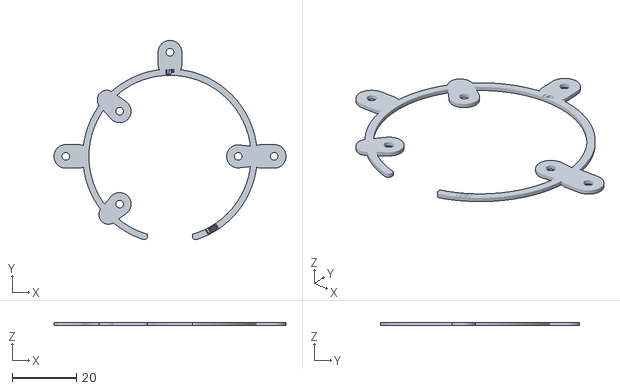
[picture p10: CAD file, 2026-10-30]
hardware/3dModel/stl/fit_template.stl
72.4 x 62.2 x 1.00
