omniscientjoker/obd_brz_gauge/hardware/v2/stl/carrier_right.stl

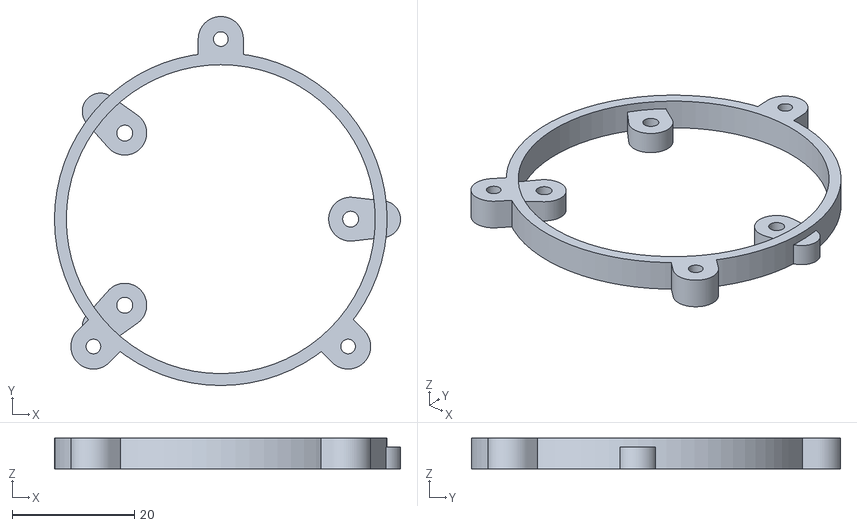
[picture p11: CAD file, 2026-10-18]
hardware/v2/stl/carrier_right.stl
56.7 x 60.5 x 5.00
