omniscientjoker/obd_brz_gauge/hardware/3dModel/stl/carrier_a.stl

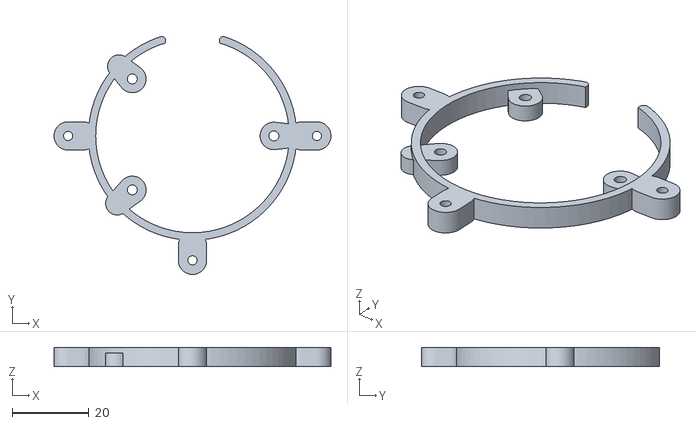
[picture p13: CAD file, 2026-10-30]
hardware/3dModel/stl/carrier_a.stl
72.4 x 62.2 x 5.00
