omniscientjoker/obd_brz_gauge/hardware/3dModel/stl/carrier_b.stl

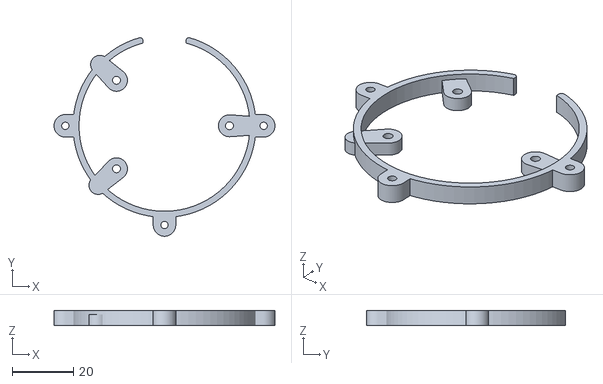
[picture p14: CAD file, 2026-10-30]
hardware/3dModel/stl/carrier_b.stl
72.4 x 65.1 x 5.00
