omniscientjoker/obd_brz_gauge/hardware/3dModel/stl/panel.stl

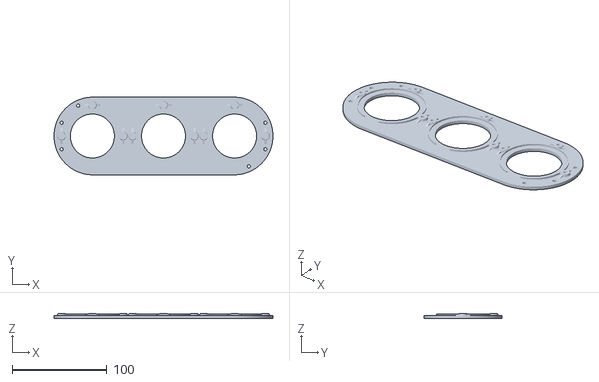
[picture p15: CAD file, 2026-10-30]
hardware/3dModel/stl/panel.stl
231.0 x 82.0 x 5.00
