omniscientjoker/obd_brz_gauge/hardware/v2/stl/fit_template.stl

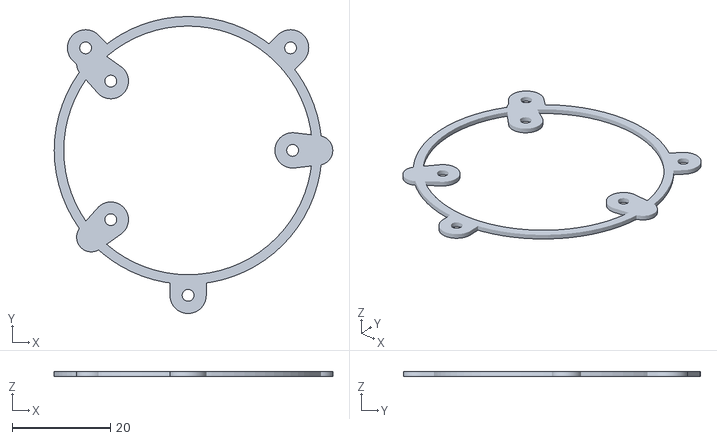
[picture p16: CAD file, 2026-10-18, an earlier design]
hardware/v2/stl/fit_template.stl
56.7 x 60.5 x 1.00
