omniscientjoker/obd_brz_gauge/hardware/v2/three_gauge_v2/stl/panel.stl

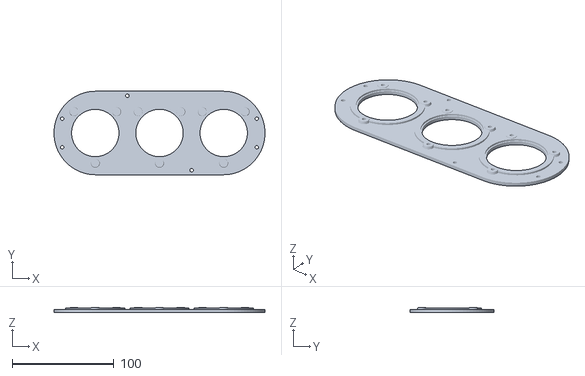
[picture p17: CAD file, 2026-10-18, an earlier design]
hardware/v2/three_gauge_v2/stl/panel.stl
207.0 x 82.0 x 5.00
