omniscientjoker/obd_brz_gauge/hardware/v2/stl/base.stl

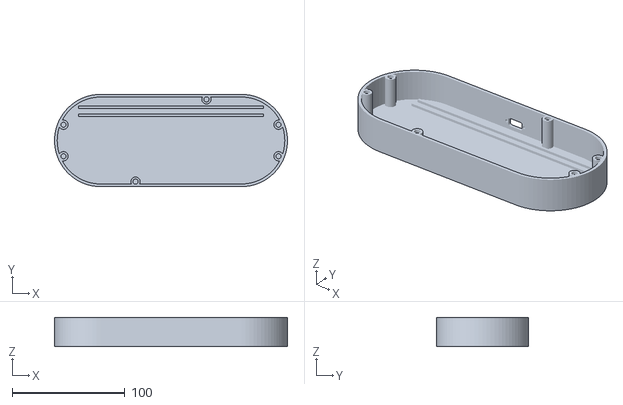
[picture p18: CAD file, 2026-10-18, an earlier design]
hardware/v2/stl/base.stl
207.0 x 82.0 x 26.0
