omniscientjoker/obd_brz_gauge/hardware/3dModel/power_board_mockup.scad

// Print only for checking the rigid PCB outline and screw positions.
// This plastic mockup is not an electronic PCB.
include <parts.scad>
aux_pcb_shape();
