omniscientjoker/obd_brz_gauge/hardware/3dModel/carrier_a.scad

// A-profile carrier. The same part is used at left, centre and right.
include <parts.scad>
carrier_print();
