omniscientjoker/obd_brz_gauge/hardware/3dModel/fit_template_b.scad

// 1 mm B-profile calibration plate. Keep the rear-view orientation.
include <parts.scad>
carrier_shape_b(thickness=1.0, template=true);
