omniscientjoker/obd_brz_gauge/hardware/3dModel/panel.scad

// Print one. Front face lies on Z=0; carrier interface faces upwards.
include <parts.scad>
universal_panel();
