omniscientjoker/obd_brz_gauge/hardware/v2/base.scad

// Print one. Open side faces up. Support the shallow external magnet pocket.
include <parts.scad>
base_print();
