omniscientjoker/obd_brz_gauge/hardware/v2/carrier_left.scad

// Left slave carrier. Configure board_holes_by_module[0] in params.scad.
include <parts.scad>
carrier_print(0);
