omniscientjoker/obd_brz_gauge/hardware/v2/carrier_right.scad

// Right slave carrier. Configure board_holes_by_module[2] in params.scad.
include <parts.scad>
carrier_print(2);
