omniscientjoker/obd_brz_gauge/hardware/v2/three_gauge_v2/carrier_centre.scad

// Centre master carrier. Configure board_holes_by_module[1] in params.scad.
include <parts.scad>
carrier_print(1);
