omniscientjoker/obd_brz_gauge/(list of files, cad)

Other CAD files:
hardware/v2/three_gauge_v2/stl/carrier_left.stl
hardware/v2/three_gauge_v2/stl/base.stl
hardware/v2/stl/panel.stl
hardware/v2/three_gauge_v2/stl/fit_template.stl
hardware/v2/params.scad
hardware/3dModel/assembly_b.scad
hardware/3dModel/carrier_b.scad
hardware/v2/assembly.scad
hardware/v2/parts.scad
hardware/v2/three_gauge_v2/parts.scad
hardware/v2/three_gauge_v2/params.scad
