omniscientjoker/obd_brz_gauge/hardware/electronics/power_pd_3x5v_r3/production/assembly/PIN1_POLARITY.csv

Ref | Side | Pad | Net | X_mm | Y_mm | Meaning
CB2 | Top | 1 | /BOOT2 | 9.145000 | 23.300000 | pin 1
CB3 | Top | 1 | /BOOT3 | 31.545000 | 23.300000 | pin 1
CB4 | Top | 1 | /BOOT4 | 53.945000 | 23.300000 | pin 1
CBULK1 | Top | 1 | /VPROT | 8.800000 | 4.425000 | positive
CBULK2 | Top | 1 | /VPROT | 22.800000 | 4.425000 | positive
CBULK3 | Top | 1 | /VPROT | 73.200000 | 4.425000 | positive
CC2 | Bottom | 1 | /COMP_RC2 | 18.740000 | 22.105000 | pin 1
CC3 | Bottom | 1 | /COMP_RC3 | 41.140000 | 22.105000 | pin 1
CC4 | Bottom | 1 | /COMP_RC4 | 63.540000 | 22.105000 | pin 1
CD2 | Bottom | 1 | /DVDT_LEFT | 25.675000 | 39.680000 | pin 1
CD3 | Bottom | 1 | /DVDT_CENTRE | 48.075000 | 39.680000 | pin 1
CD4 | Bottom | 1 | /DVDT_RIGHT | 70.475000 | 39.680000 | pin 1
CDIN | Bottom | 1 | /DVDT_IN | 57.175000 | 14.480000 | pin 1
CE2 | Top | 1 | /PRE_LEFT | 10.925000 | 38.000000 | positive
CE3 | Top | 1 | /PRE_CENTRE | 33.325000 | 38.000000 | positive
CE4 | Top | 1 | /PRE_RIGHT | 54.325000 | 38.000000 | positive
CIN2A | Top | 1 | /VPROT | 25.805000 | 21.760000 | pin 1
CIN2B | Top | 1 | /VPROT | 25.805000 | 17.280000 | pin 1
CIN3A | Top | 1 | /VPROT | 48.205000 | 21.760000 | pin 1
CIN3B | Top | 1 | /VPROT | 48.205000 | 17.280000 | pin 1
CIN4A | Top | 1 | /VPROT | 70.605000 | 21.760000 | pin 1
CIN4B | Top | 1 | /VPROT | 70.605000 | 17.280000 | pin 1
COUT2A | Bottom | 1 | /PRE_LEFT | 28.055000 | 41.780000 | pin 1
COUT2B | Bottom | 1 | /PRE_LEFT | 28.055000 | 36.740000 | pin 1
COUT3A | Bottom | 1 | /PRE_CENTRE | 50.455000 | 41.780000 | pin 1
COUT3B | Bottom | 1 | /PRE_CENTRE | 50.455000 | 36.740000 | pin 1
COUT4A | Bottom | 1 | /PRE_RIGHT | 72.855000 | 41.780000 | pin 1
COUT4B | Bottom | 1 | /PRE_RIGHT | 72.855000 | 36.740000 | pin 1
CPD | Top | 1 | /VRAW | 33.440000 | 15.525000 | pin 1
CSYS | Top | 1 | /VRAW | 54.080000 | 15.525000 | pin 1
CUSB2 | Bottom | 1 | /USB5V_LEFT | 22.455000 | 46.120000 | pin 1
CUSB3 | Bottom | 1 | /USB5V_CENTRE | 44.855000 | 46.120000 | pin 1
CUSB4 | Bottom | 1 | /USB5V_RIGHT | 67.255000 | 46.120000 | pin 1
DTVS | Top | 1 | /VRAW | 54.960000 | 3.000000 | cathode
F1 | Top | 1 | /VBUS_USB | 51.080000 | 1.275000 | pin 1
J1 | Top | A1 | /GND | 38.025000 | 5.410000 | USB A1/GND
J2 | Top | 1 | /USB5V_LEFT | 20.350000 | 49.900000 | +5V output
J3 | Top | 1 | /USB5V_CENTRE | 42.750000 | 49.900000 | +5V output
J4 | Top | 1 | /USB5V_RIGHT | 65.150000 | 49.900000 | +5V output
L2 | Top | 1 | /SW2 | 25.065000 | 29.040000 | SW/marked lead
L3 | Top | 1 | /SW3 | 47.465000 | 29.040000 | SW/marked lead
L4 | Top | 1 | /SW4 | 69.865000 | 35.900000 | SW/marked lead
RC2 | Bottom | 1 | /COMP2 | 21.820000 | 22.055000 | pin 1
RC3 | Bottom | 1 | /COMP3 | 44.220000 | 22.055000 | pin 1
RC4 | Bottom | 1 | /COMP4 | 66.620000 | 22.055000 | pin 1
RFH2 | Bottom | 1 | /PRE_LEFT | 16.625000 | 17.980000 | pin 1
RFH3 | Bottom | 1 | /PRE_CENTRE | 39.025000 | 17.980000 | pin 1
RFH4 | Bottom | 1 | /PRE_RIGHT | 61.425000 | 17.980000 | pin 1
RFL2 | Bottom | 1 | /FB2 | 12.285000 | 17.980000 | pin 1
RFL3 | Bottom | 1 | /FB3 | 34.685000 | 17.980000 | pin 1
RFL4 | Bottom | 1 | /FB4 | 57.085000 | 17.980000 | pin 1
RILIMIN | Bottom | 1 | /ILIM_IN | 56.400000 | 9.875000 | pin 1
RILM2 | Bottom | 1 | /ILM_LEFT | 32.120000 | 43.055000 | pin 1
RILM3 | Bottom | 1 | /ILM_CENTRE | 54.520000 | 43.055000 | pin 1
RILM4 | Bottom | 1 | /ILM_RIGHT | 76.920000 | 43.055000 | pin 1
RLIM2 | Bottom | 1 | /RLIM2 | 22.100000 | 17.155000 | pin 1
RLIM3 | Bottom | 1 | /RLIM3 | 44.500000 | 17.155000 | pin 1
RLIM4 | Bottom | 1 | /RLIM4 | 66.900000 | 17.155000 | pin 1
ROVH2 | Bottom | 1 | /PRE_LEFT | 17.620000 | 42.495000 | pin 1
ROVH3 | Bottom | 1 | /PRE_CENTRE | 40.020000 | 42.495000 | pin 1
ROVH4 | Bottom | 1 | /PRE_RIGHT | 62.420000 | 42.495000 | pin 1
ROVINH | Bottom | 1 | /VRAW | 67.600000 | 11.590000 | pin 1
ROVINL | Bottom | 1 | /OV_IN | 67.600000 | 8.090000 | pin 1
ROVL2 | Bottom | 1 | /OV_LEFT | 20.840000 | 42.495000 | pin 1
ROVL3 | Bottom | 1 | /OV_CENTRE | 43.240000 | 42.495000 | pin 1
ROVL4 | Bottom | 1 | /OV_RIGHT | 65.640000 | 42.495000 | pin 1
RPGH | Bottom | 1 | /VPROT | 52.900000 | 7.075000 | pin 1
RPGL | Bottom | 1 | /PGTH | 52.900000 | 3.575000 | pin 1
RPGPU | Bottom | 1 | /VPROT | 56.400000 | 5.675000 | pin 1
RSET | Top | 1 | /CFG1 | 45.480000 | 15.475000 | pin 1
RUVH2 | Bottom | 1 | /PRE_LEFT | 11.180000 | 42.495000 | pin 1
RUVH3 | Bottom | 1 | /PRE_CENTRE | 33.580000 | 42.495000 | pin 1
RUVH4 | Bottom | 1 | /PRE_RIGHT | 55.980000 | 42.495000 | pin 1
RUVINH | Bottom | 1 | /VRAW | 64.100000 | 11.590000 | pin 1
RUVINL | Bottom | 1 | /UV_IN | 64.100000 | 8.090000 | pin 1
RUVL2 | Bottom | 1 | /UV_LEFT | 14.400000 | 42.495000 | pin 1
RUVL3 | Bottom | 1 | /UV_CENTRE | 36.800000 | 42.495000 | pin 1
RUVL4 | Bottom | 1 | /UV_RIGHT | 59.200000 | 42.495000 | pin 1
U2 | Top | 1 | /SW2 | 14.170000 | 24.505000 | pin 1
U3 | Top | 1 | /SW3 | 36.570000 | 24.505000 | pin 1
U4 | Top | 1 | /SW4 | 58.970000 | 24.505000 | pin 1
UIN | Top | 1 | /VRAW | 57.517500 | 10.550000 | pin 1
UP2 | Top | 1 | /UV_LEFT | 24.700000 | 44.020000 | pin 1
UP3 | Top | 1 | /UV_CENTRE | 47.100000 | 44.020000 | pin 1
UP4 | Top | 1 | /UV_RIGHT | 69.500000 | 44.020000 | pin 1
UPD | Top | 1 | /VRAW | 36.962500 | 17.880000 | pin 1
