omniscientjoker/obd_brz_gauge/outputs/huaqiu_pcba_20261026_r1/guide-3.png

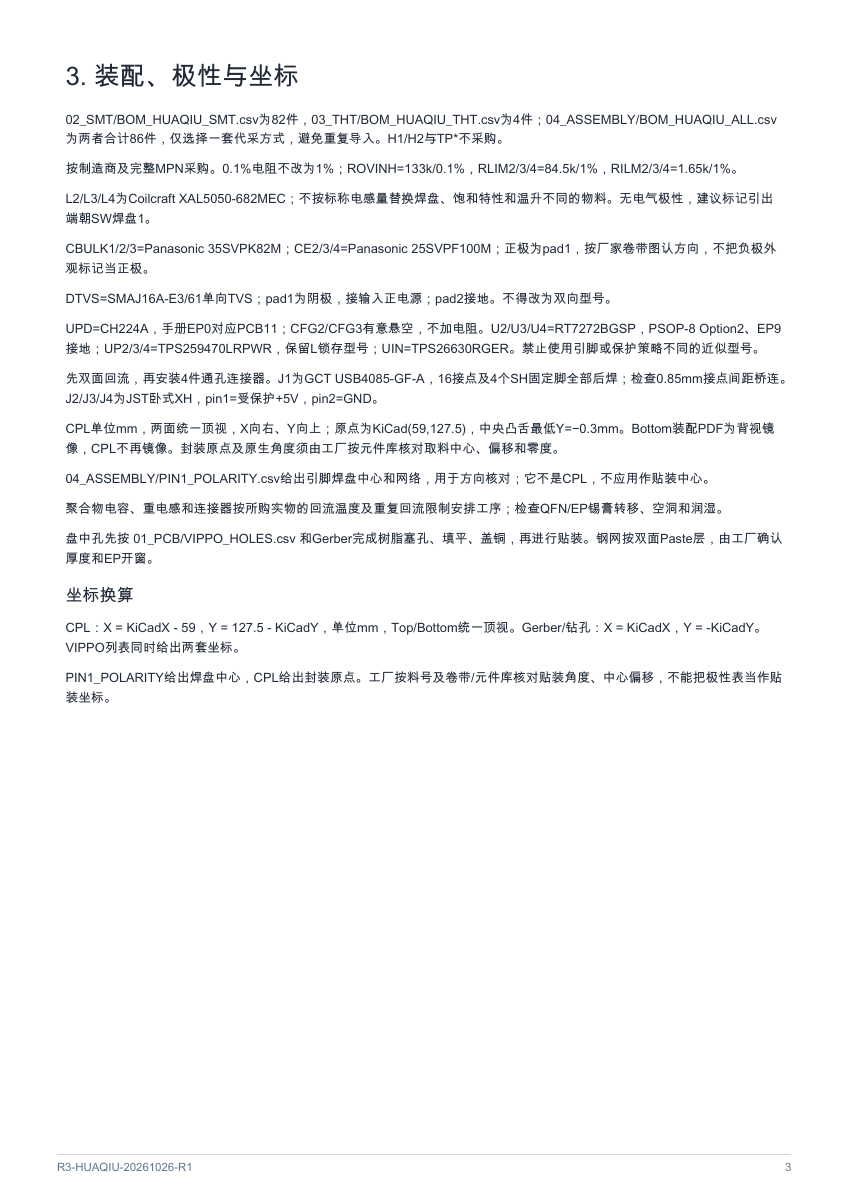
outputs/huaqiu_pcba_20261026_r1/guide-3.png
