omniscientjoker/obd_brz_gauge/outputs/huaqiu_pcba_20261026_r1/guide-4.png

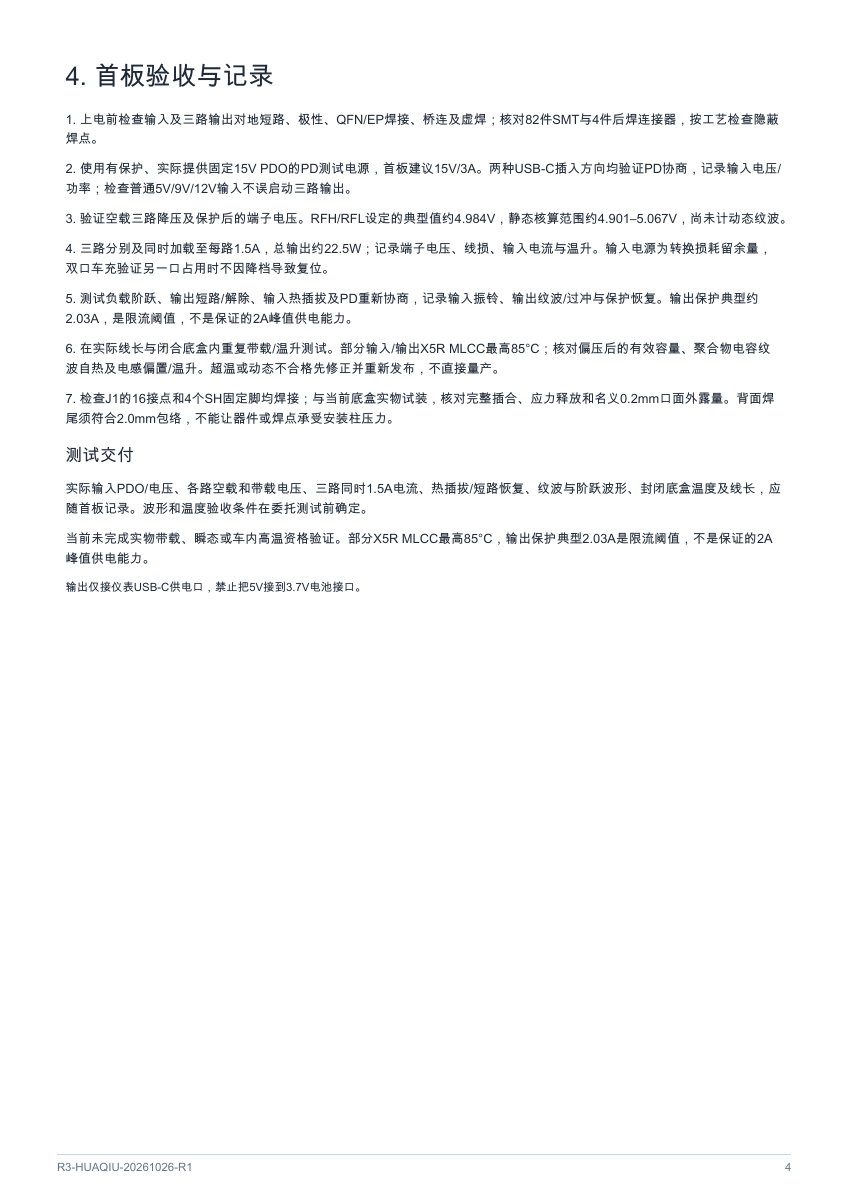
outputs/huaqiu_pcba_20261026_r1/guide-4.png
