omniscientjoker/obd_brz_gauge/hardware/electronics/power_pd_3x5v_r3/huaqiu/04_ASSEMBLY/ASSEMBLY_TOP_BOTTOM.pdf

# PD 3x5V / R3 USB-FLUSH-20261026 / TOP

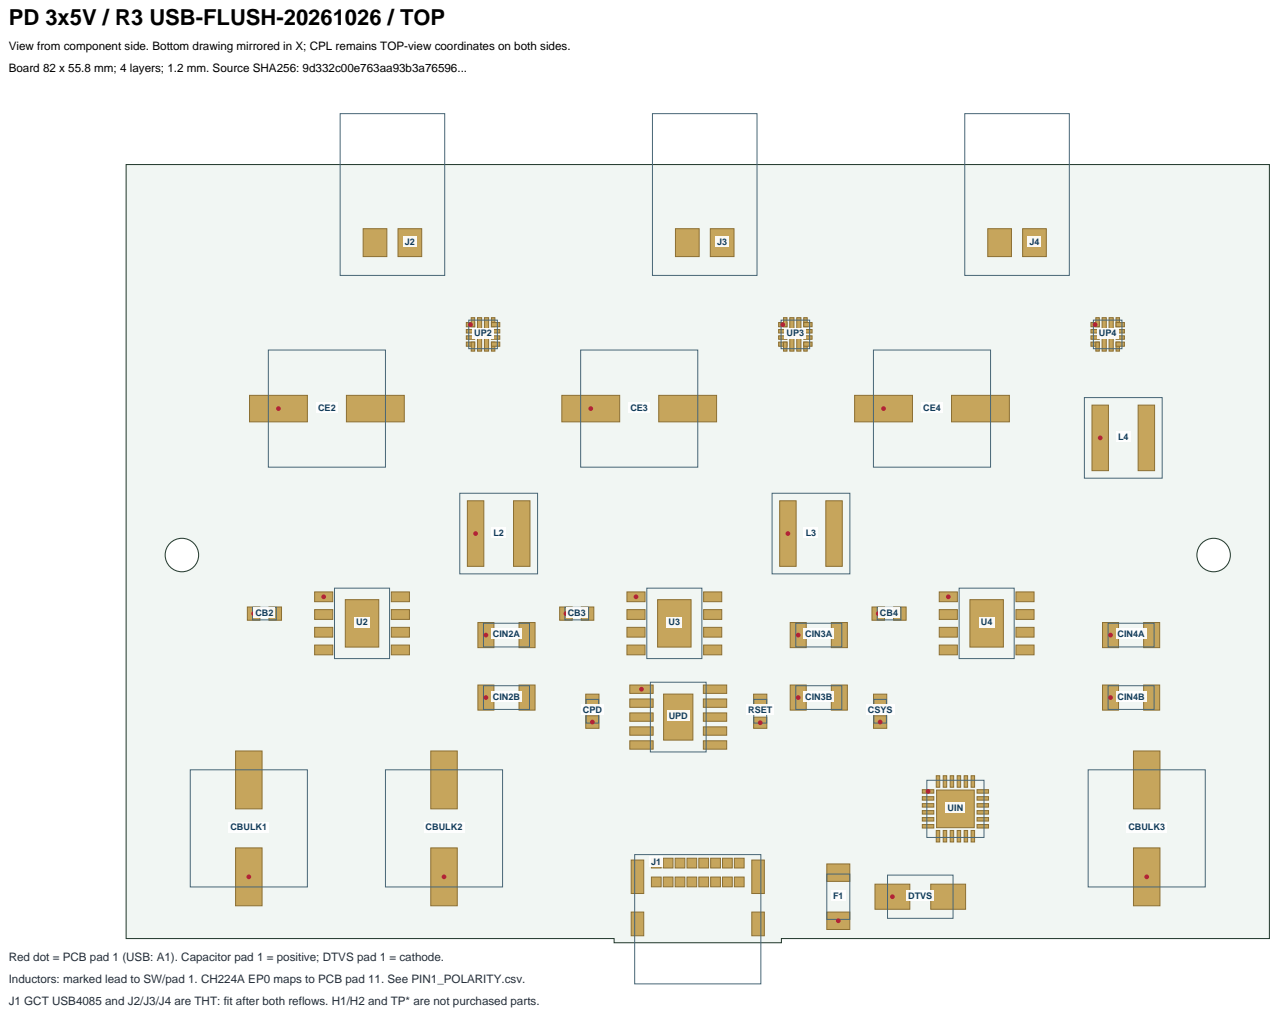
[picture p23: page 1]

View from component side. Bottom drawing mirrored in X; CPL remains TOP-view coordinates on both sides.
Board 82 x 55.8 mm; 4 layers; 1.2 mm. Source SHA256: 9d332c00e763aa93b3a76596...

Red dot = PCB pad 1 (USB: A1). Capacitor pad 1 = positive; DTVS pad 1 = cathode.
Inductors: marked lead to SW/pad 1. CH224A EP0 maps to PCB pad 11. See PIN1_POLARITY.csv.
J1 GCT USB4085 and J2/J3/J4 are THT: fit after both reflows. H1/H2 and TP* are not purchased parts.

# PD 3x5V / R3 USB-FLUSH-20261026 / BOTTOM

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

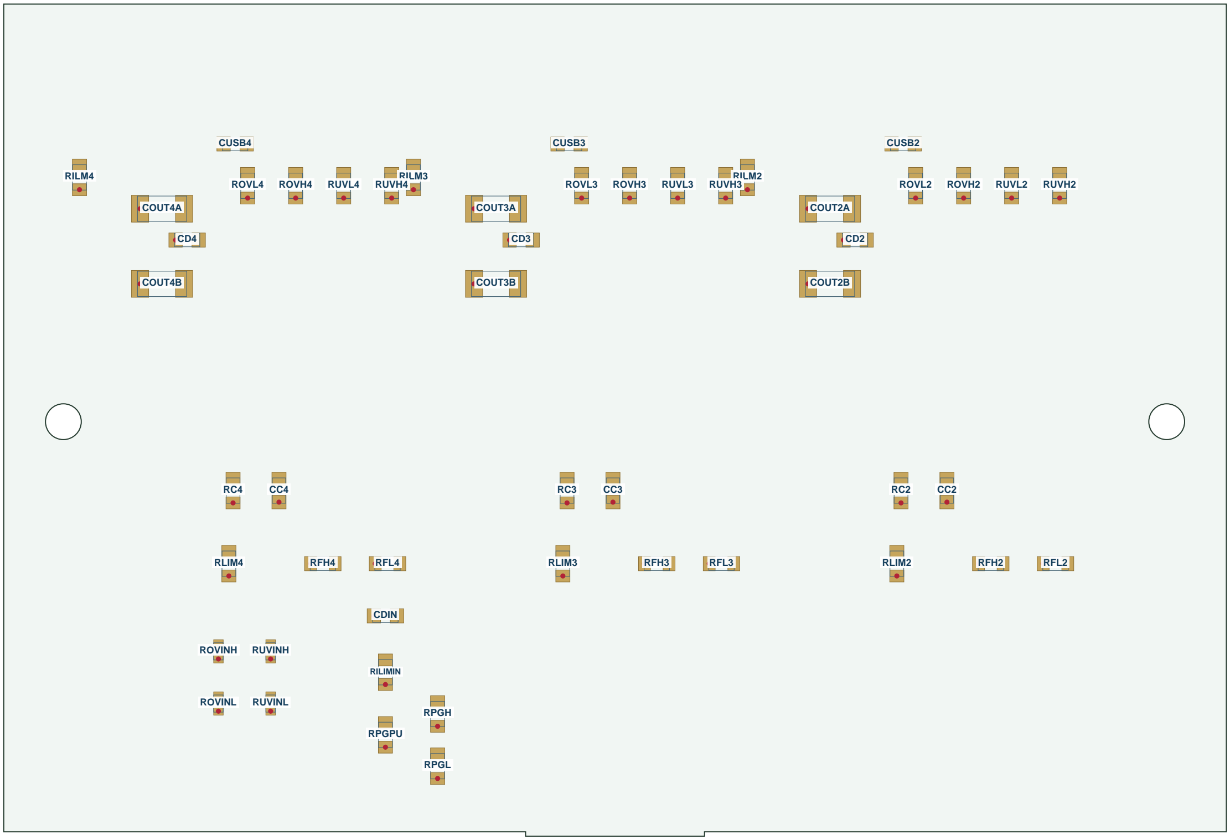
[picture p24: figure]
ROVH4; RUVH2; RFH4; COUT2B; RUVL2; RUVINL; RLIM3; RILM4; RILM2; RPGL; ROVH3; RPGH; RFL3; COUT3A; CUSB3; COUT4A; RUVL3; CUSB4; RFL2; RPGPU; COUT2A; CUSB2; RFH2; RUVINH; RUVL4; COUT3B; RILM3; ROVL3; RUVH3; CDIN; RFL4; RUVH4; ROVL2; RILIMIN; ROVL4; RLIM4; RFH3; COUT4B; ROVINL; ROVINH; ROVH2; RLIM2

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
