omniscientjoker/obd_brz_gauge/hardware/electronics/power_pd_3x5v_r4/huaqiu/04_ASSEMBLY/SCHEMATIC.pdf

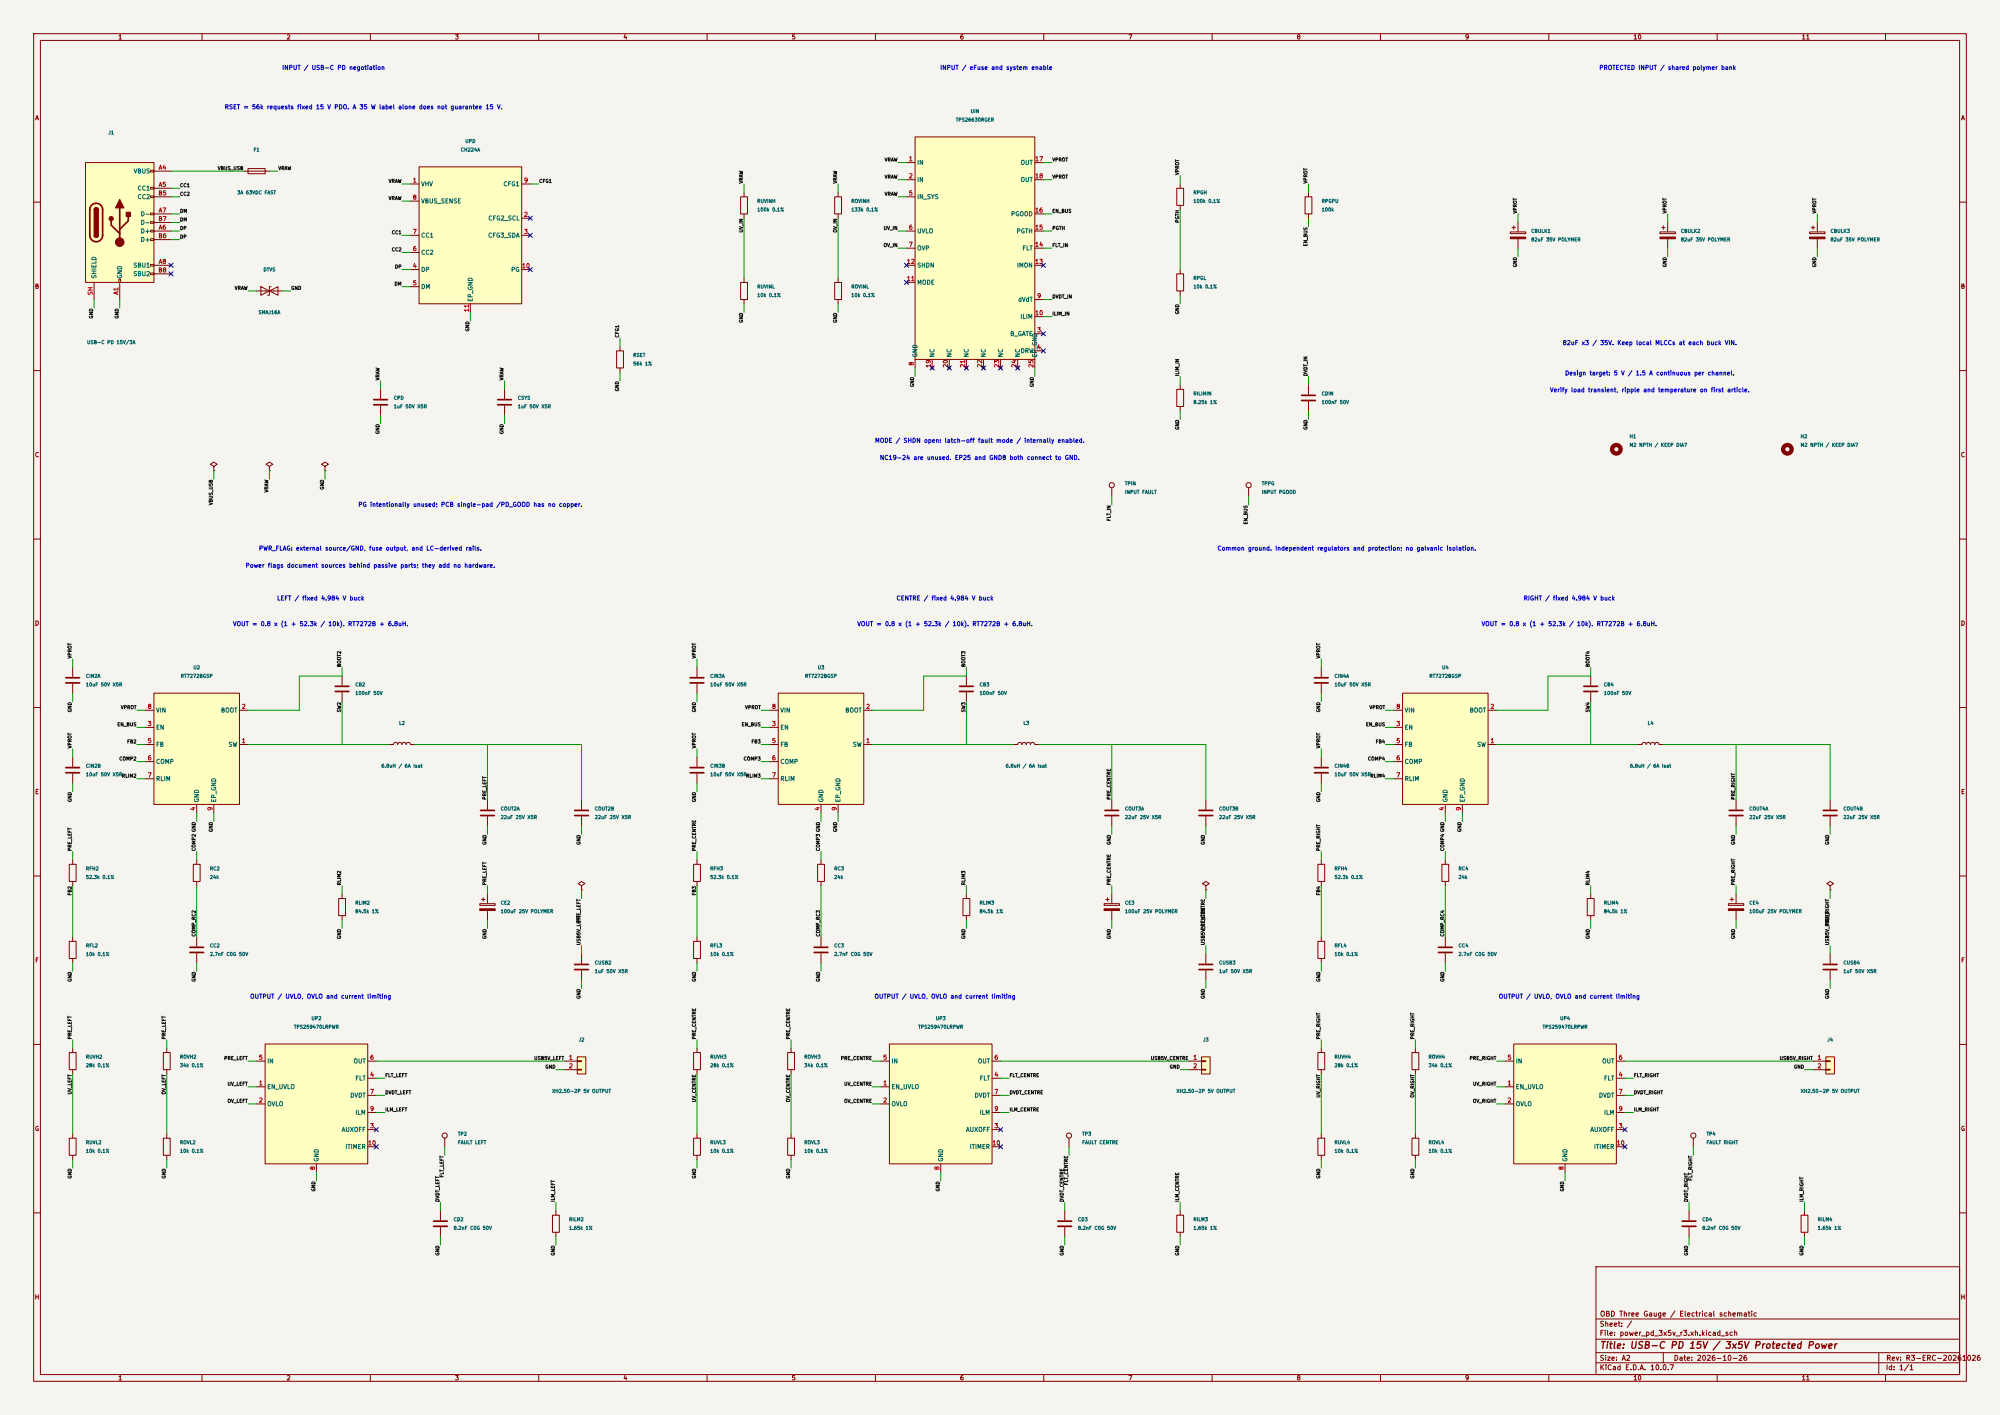
[picture p25: page 1]

INPUT / USB-C PD negotiation

INPUT / eFuse and system enable
VRAW GND

PROTECTED INPUT / shared polymer bank

RSET = 56k requests fixed 15 V PDO. A 35 W label alone does not guarantee 15 V.
J1 USB-C PD 15V/3A

82uF x3 / 35V. Keep local MLCCs at each buck VIN. Design target: 5 V / 1.5 A continuous per channel. Verify load transient, ripple and temperature on first article. VOUT = 0.8 x (1 + 52.3k / 10k). RT7272B + 6.8uH.

Common ground. Independent regulators and protection; no galvanic isolation. NC19-24 are unused. EP25 and GND8 both connect to GND. CENTRE / fixed 4.984 V buck

OUTPUT / UVLO, OVLO and current limiting

OBD Three Gauge / Electrical schematic
Sheet: /
File: power_pd_3x5v_r3.xh.kicad_sch
Title: USB-C PD 15V / 3x5V Protected Power
KiCad E.D.A. 10.0.7
