omniscientjoker/obd_brz_gauge/hardware/electronics/power_pd_3x5v_r4.kicad_pcb

## KiCad design hardware/electronics/power_pd_3x5v_r4.kicad_pcb (2026-10-30)

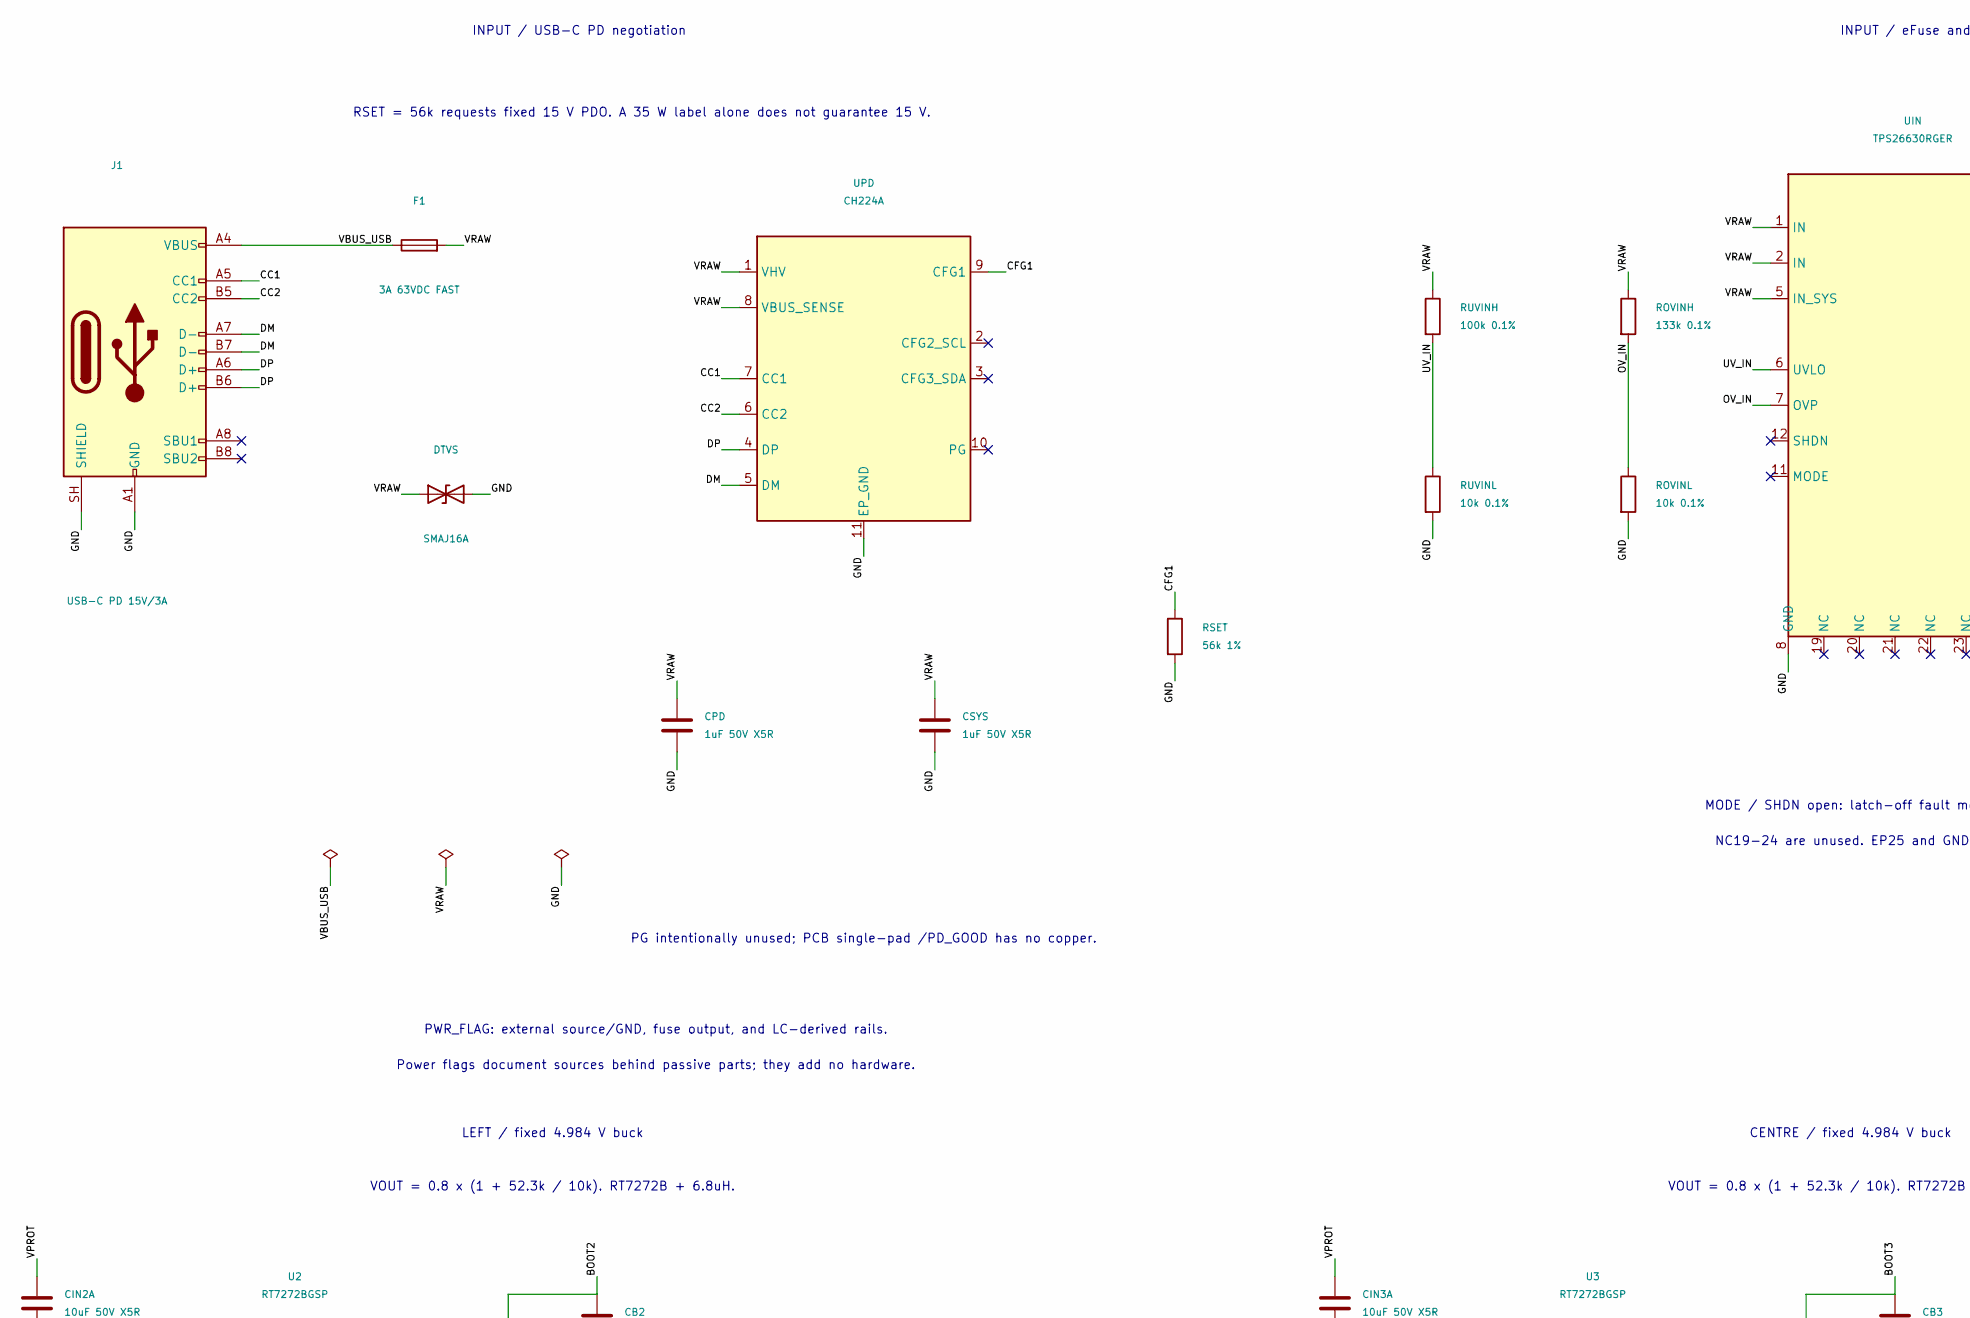
[picture p26: schematic power_pd_3x5v_r3.xh.kicad_sch, USB-C PD 15V / 3x5V Protected Power, part in row 1, column 1]

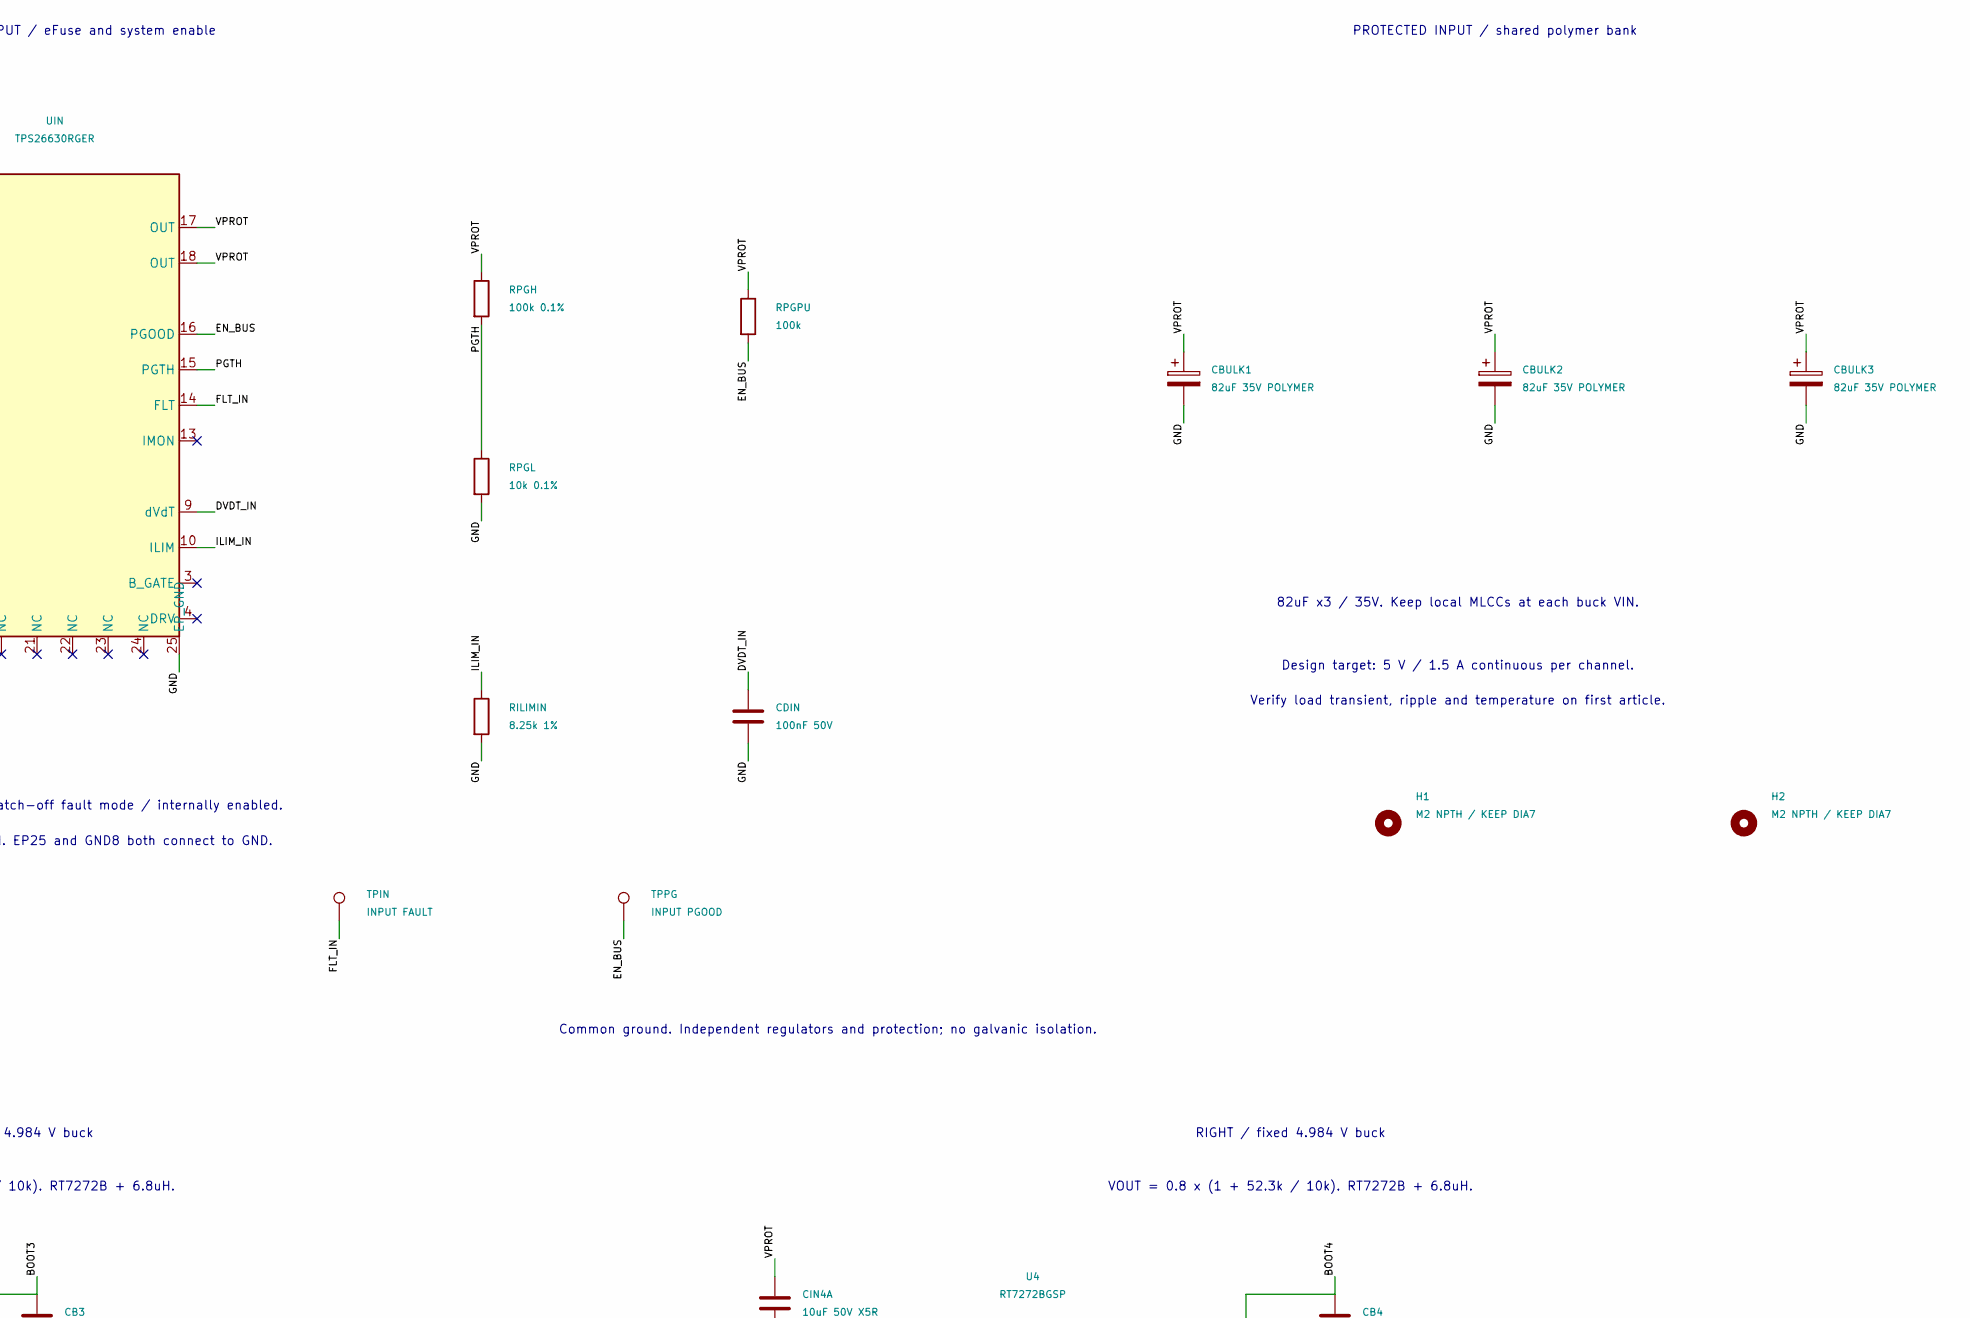
[picture p27: schematic power_pd_3x5v_r3.xh.kicad_sch, USB-C PD 15V / 3x5V Protected Power, part in row 1, column 2]

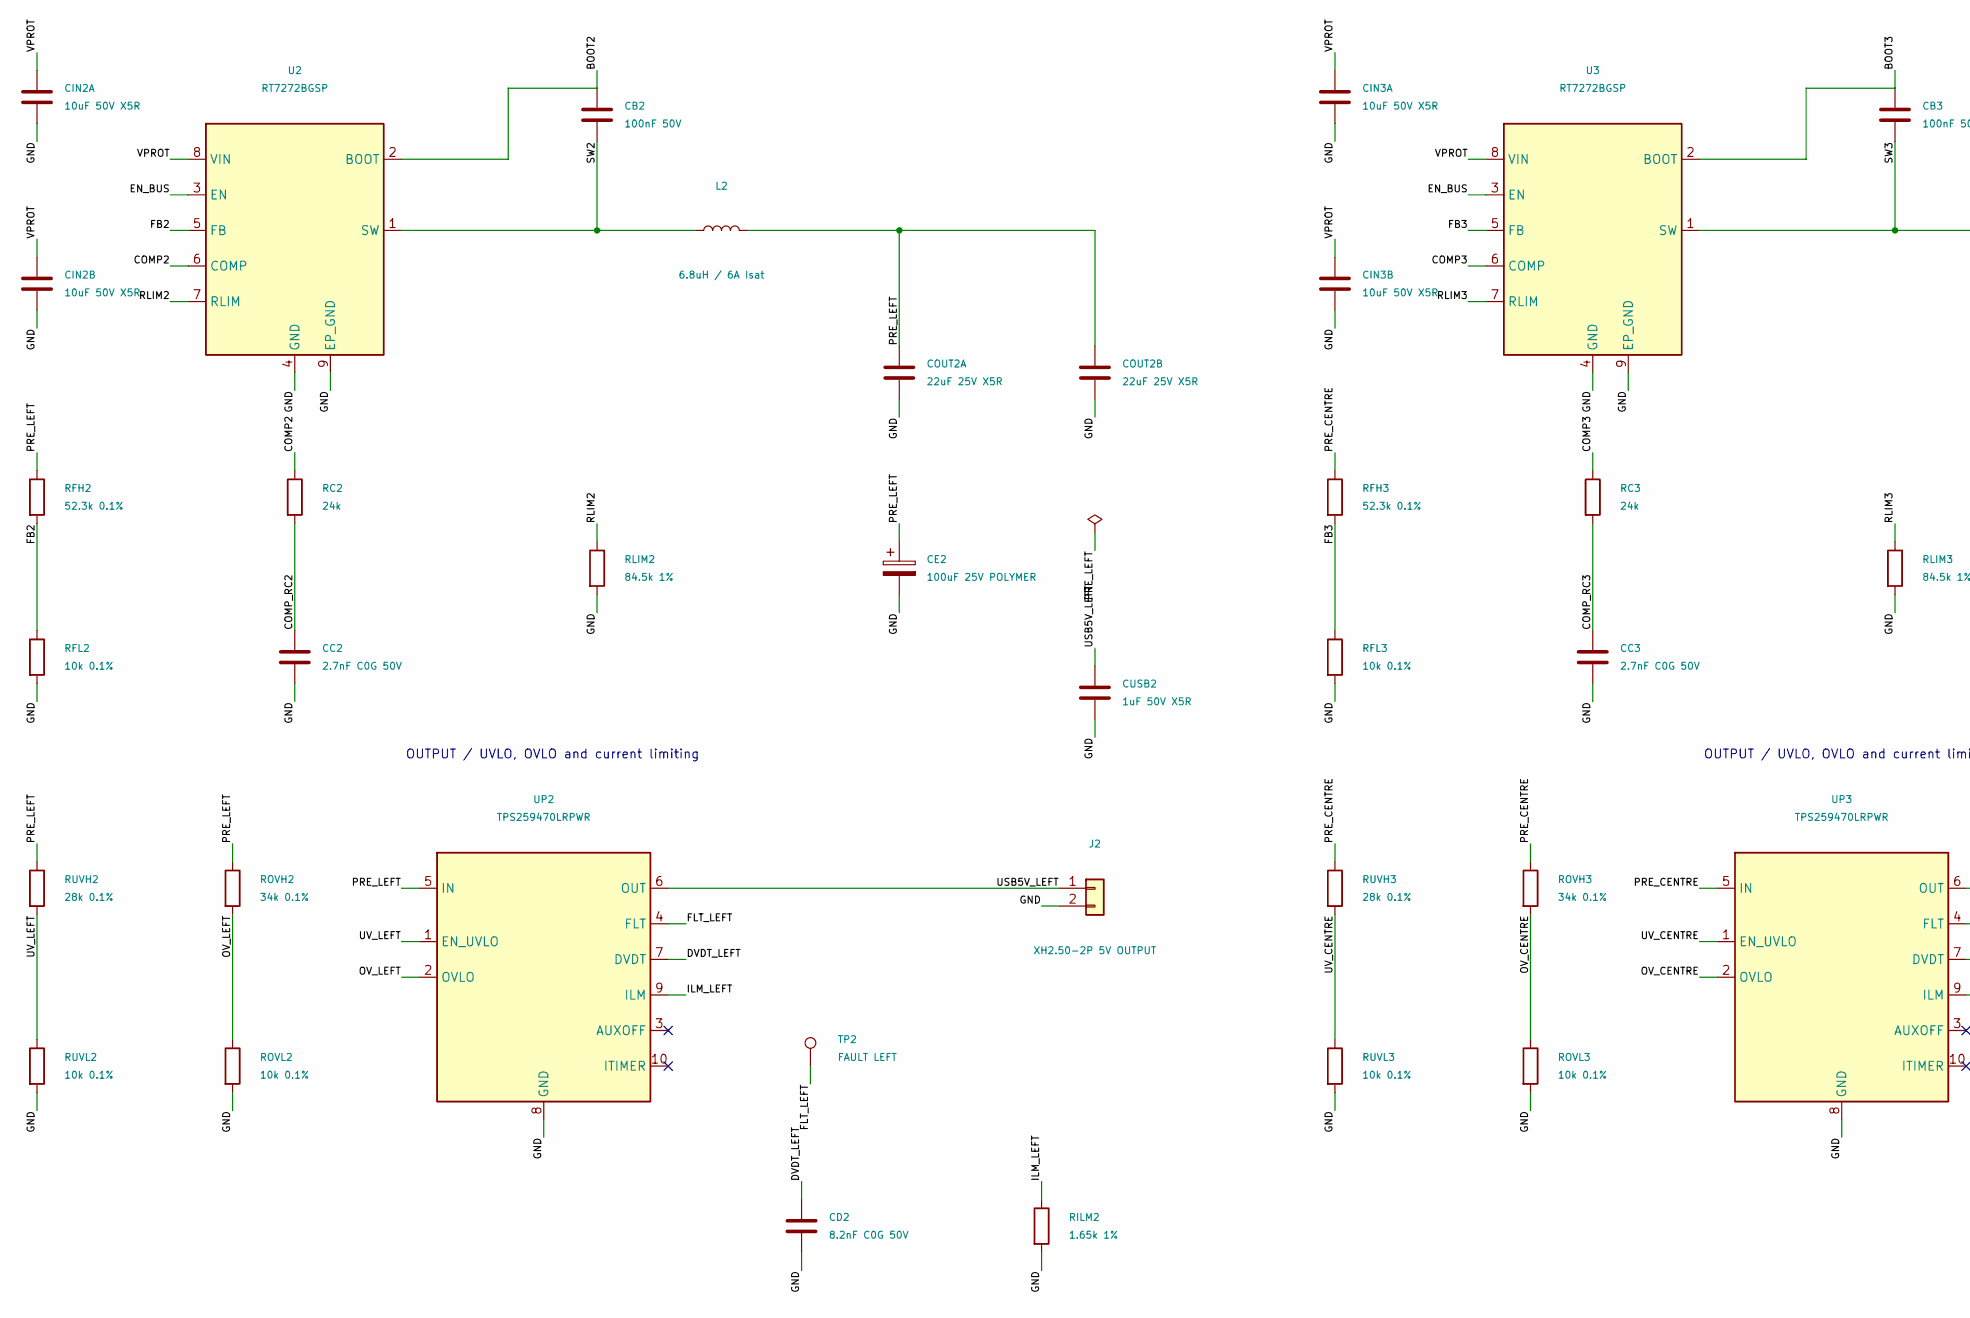
[picture p28: schematic power_pd_3x5v_r3.xh.kicad_sch, USB-C PD 15V / 3x5V Protected Power, part in row 2, column 1]

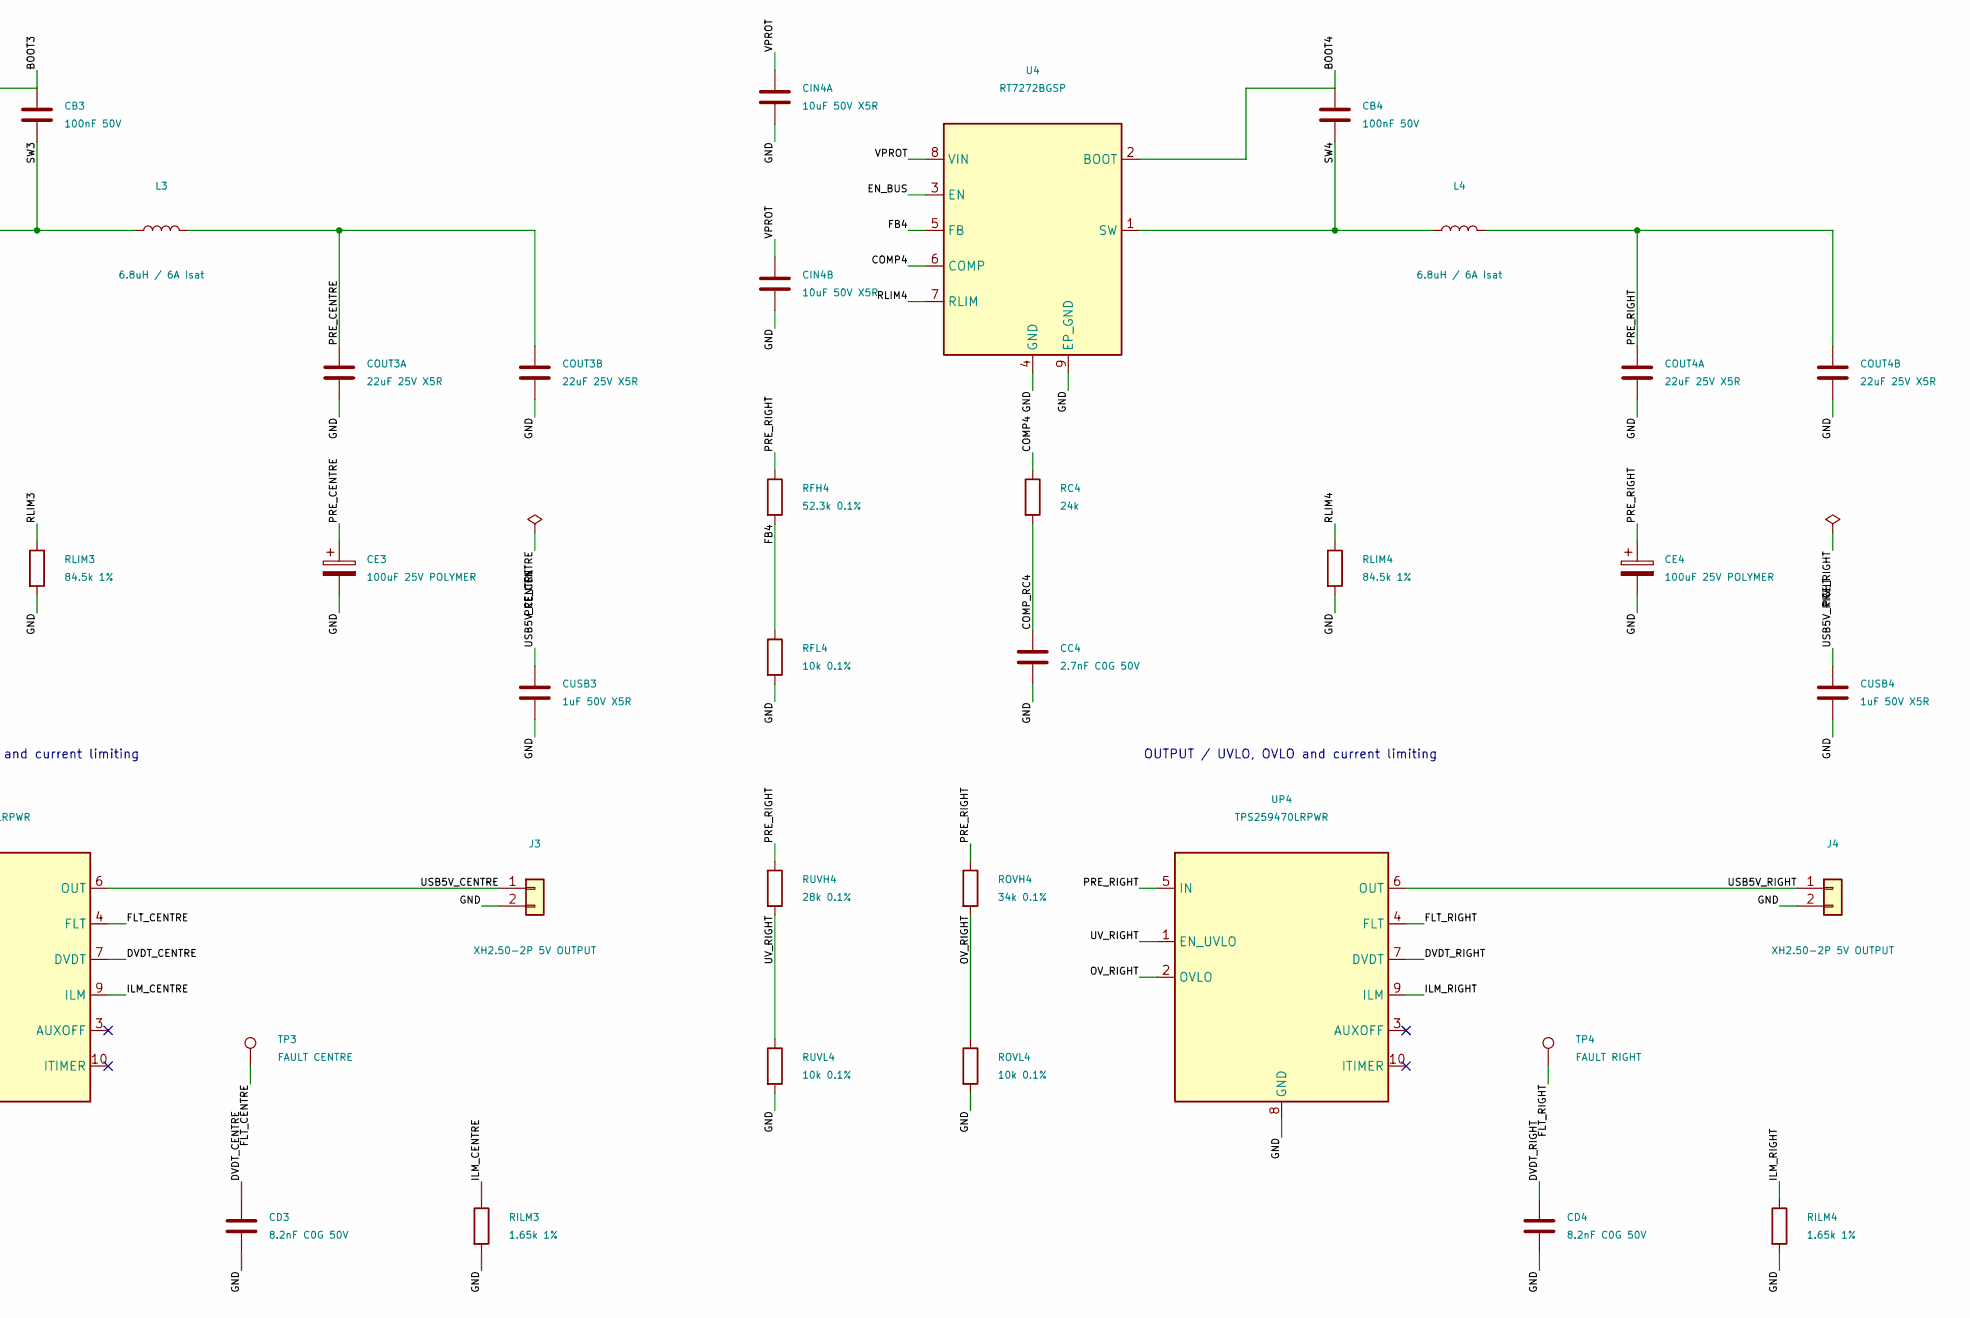
[picture p29: schematic power_pd_3x5v_r3.xh.kicad_sch, USB-C PD 15V / 3x5V Protected Power, part in row 2, column 2]

Parts:
CB2, CB3, CB4: 100nF 50V; C_0603_1608Metric; MPN GRM188R71H104KA93D
CBULK1, CBULK2, CBULK3: 82uF 35V POLYMER; CP_Elec_8x6.9; MPN 35SVPK82M
CC2, CC3, CC4: 2.7nF C0G 50V; C_0603_1608Metric; MPN GRM1885C1H272JA01D
CD2, CD3, CD4: 8.2nF C0G 50V; C_0603_1608Metric; MPN GRM1885C1H822JA01D
CDIN: 100nF 50V; C_0603_1608Metric; MPN GRM188R71H104KA93D
CE2, CE3, CE4: 100uF 25V POLYMER; CP_Elec_8x6.9; MPN 25SVPF100M
CIN2A, CIN2B, CIN3A, CIN3B, CIN4A, CIN4B: 10uF 50V X5R; C_1206_3216Metric; MPN GRM31CR61H106KA12L
COUT2A, COUT2B, COUT3A, COUT3B, COUT4A, COUT4B: 22uF 25V X5R; C_1206_3216Metric; MPN GRM31CR61E226KE15L
CPD: 1uF 50V X5R; C_0603_1608Metric; MPN GRM188R61H105KAALD
CSYS: 1uF 50V X5R; C_0603_1608Metric; MPN GRM188R61H105KAALD
CUSB2, CUSB3, CUSB4: 1uF 50V X5R; C_0603_1608Metric; MPN GRM188R61H105KAALD
DTVS: SMAJ16A; D_SMA; MPN SMAJ16A-E3/61
F1: 3A 63VDC FAST; SF_1206F_Recommended; MPN SF-1206F300-2
H1, H2: M2 NPTH / KEEP DIA7; M2_NPTH_2.4mm
J1: USB-C PD 15V/3A; USB_C_Receptacle_GCT_USB4085; MPN USB4085-GF-A
J2, J3, J4: XH2.50-2P 5V OUTPUT; JST_XH_S2B-XH-A_1x02_P2.50mm_Horizontal_Assembly; MPN S2B-XH-A(LF)(SN)
L2, L3, L4: 6.8uH / 6A Isat; L_Coilcraft_XAL5050-XXX; MPN XAL5050-682MEC
RC2, RC3, RC4: 24k; R_0603_1608Metric; MPN TNPW060324K0FEEA
RFH2, RFH3, RFH4: 52.3k 0.1%; R_0603_1608Metric; MPN TNPW060352K3BEEA
RFL2, RFL3, RFL4: 10k 0.1%; R_0603_1608Metric; MPN TNPW060310K0BEEA
RILIMIN: 8.25k 1%; R_0603_1608Metric; MPN TNPW06038K25FEEA
RILM2, RILM3, RILM4: 1.65k 1%; R_0603_1608Metric; MPN TNPW06031K65FEEA
RLIM2, RLIM3, RLIM4: 84.5k 1%; R_0603_1608Metric; MPN TNPW060384K5FEEA
ROVH2, ROVH3, ROVH4: 34k 0.1%; R_0603_1608Metric; MPN TNPW060334K0BEEA
ROVINH: 133k 0.1%; R_0402_1005Metric; MPN CRT0402-BY-1333GLF
ROVINL: 10k 0.1%; R_0402_1005Metric; MPN TNPW040210K0BEED
ROVL2, ROVL3, ROVL4: 10k 0.1%; R_0603_1608Metric; MPN TNPW060310K0BEEA
RPGH: 100k 0.1%; R_0603_1608Metric; MPN TNPW0603100KBEEA
RPGL: 10k 0.1%; R_0603_1608Metric; MPN TNPW060310K0BEEA
RPGPU: 100k; R_0603_1608Metric; MPN TNPW0603100KFEEA
RSET: 56k 1%; R_0603_1608Metric; MPN TNPW060356K0FEEA
RUVH2, RUVH3, RUVH4: 28k 0.1%; R_0603_1608Metric; MPN TNPW060328K0BEEA
RUVINH: 100k 0.1%; R_0402_1005Metric; MPN TNPW0402100KBEED
RUVINL: 10k 0.1%; R_0402_1005Metric; MPN TNPW040210K0BEED
RUVL2, RUVL3, RUVL4: 10k 0.1%; R_0603_1608Metric; MPN TNPW060310K0BEEA
TP2: FAULT LEFT; TestPoint_Pad_D1.0mm
TP3: FAULT CENTRE; TestPoint_Pad_D1.0mm
TP4: FAULT RIGHT; TestPoint_Pad_D1.0mm
TPIN: INPUT FAULT; TestPoint_Pad_D1.0mm
TPPG: INPUT PGOOD; TestPoint_Pad_D1.0mm
U2, U3, U4: RT7272BGSP; RT7272BGSP_PSOP8_Option2; MPN RT7272BGSP
UIN: TPS26630RGER; Texas_RGE0024H_VQFN-24-1EP_4x4mm_P0.5mm_EP2.7x2.7mm_Assembly; MPN TPS26630RGER
UP2, UP3, UP4: TPS259470LRPWR; TI_RPW0010A; MPN TPS259470LRPWR
UPD: CH224A; SSOP-10-1EP_3.9x4.9mm_P1mm_EP2.1x3.3mm; MPN CH224A

Connections:
/BOOT2: CB2.1, U2.2 (BOOT)
/BOOT3: CB3.1, U3.2 (BOOT)
/BOOT4: CB4.1, U4.2 (BOOT)
/CC1: J1.A5 (CC1), UPD.7 (CC1)
/CC2: J1.B5 (CC2), UPD.6 (CC2)
/CFG1: RSET.1, UPD.9 (CFG1)
/COMP2: RC2.1, U2.6 (COMP)
/COMP3: RC3.1, U3.6 (COMP)
/COMP4: RC4.1, U4.6 (COMP)
/COMP_RC2: CC2.1, RC2.2
/COMP_RC3: CC3.1, RC3.2
/COMP_RC4: CC4.1, RC4.2
/DM: J1.A7 (D-), J1.B7 (D-), UPD.5 (DM)
/DP: J1.A6 (D+), J1.B6 (D+), UPD.4 (DP)
/DVDT_CENTRE: CD3.1, UP3.7 (DVDT)
/DVDT_IN: CDIN.1, UIN.9 (dVdT)
/DVDT_LEFT: CD2.1, UP2.7 (DVDT)
/DVDT_RIGHT: CD4.1, UP4.7 (DVDT)
/EN_BUS: RPGPU.2, TPPG.1, U2.3 (EN), U3.3 (EN), U4.3 (EN), UIN.16 (PGOOD)
/FB2: RFH2.2, RFL2.1, U2.5 (FB)
/FB3: RFH3.2, RFL3.1, U3.5 (FB)
/FB4: RFH4.2, RFL4.1, U4.5 (FB)
/FLT_CENTRE: TP3.1, UP3.4 (FLT)
/FLT_IN: TPIN.1, UIN.14 (FLT)
/FLT_LEFT: TP2.1, UP2.4 (FLT)
/FLT_RIGHT: TP4.1, UP4.4 (FLT)
/GND: CBULK1.2, CBULK2.2, CBULK3.2, CC2.2, CC3.2, CC4.2, CD2.2, CD3.2, CD4.2, CDIN.2, CE2.2, CE3.2, CE4.2, CIN2A.2, CIN2B.2, CIN3A.2, CIN3B.2, CIN4A.2, CIN4B.2, COUT2A.2, COUT2B.2, COUT3A.2, COUT3B.2, COUT4A.2, COUT4B.2, CPD.2, CSYS.2, CUSB2.2, CUSB3.2, CUSB4.2, DTVS.2 (A2), J1.A1 (GND), J1.A12 (GND), J1.B1 (GND), J1.B12 (GND), J1.SH (SHIELD), J2.2, J3.2, J4.2, RFL2.2, RFL3.2, RFL4.2, RILIMIN.2, RILM2.2, RILM3.2, RILM4.2, RLIM2.2, RLIM3.2, RLIM4.2, ROVINL.2, ROVL2.2, ROVL3.2, ROVL4.2, RPGL.2, RSET.2, RUVINL.2, RUVL2.2, RUVL3.2, RUVL4.2, U2.4 (GND), U2.9 (EP_GND), U3.4 (GND), U3.9 (EP_GND), U4.4 (GND), U4.9 (EP_GND), UIN.8 (GND), UIN.25 (EP_GND), UP2.8 (GND), UP3.8 (GND), UP4.8 (GND), UPD.11 (EP_GND)
/ILIM_IN: RILIMIN.1, UIN.10 (ILIM)
/ILM_CENTRE: RILM3.1, UP3.9 (ILM)
/ILM_LEFT: RILM2.1, UP2.9 (ILM)
/ILM_RIGHT: RILM4.1, UP4.9 (ILM)
/OV_CENTRE: ROVH3.2, ROVL3.1, UP3.2 (OVLO)
/OV_IN: ROVINH.2, ROVINL.1, UIN.7 (OVP)
/OV_LEFT: ROVH2.2, ROVL2.1, UP2.2 (OVLO)
/OV_RIGHT: ROVH4.2, ROVL4.1, UP4.2 (OVLO)
/PD_GOOD: UPD.10 (PG)
/PGTH: RPGH.2, RPGL.1, UIN.15 (PGTH)
/PRE_CENTRE: CE3.1, COUT3A.1, COUT3B.1, L3.2, RFH3.1, ROVH3.1, RUVH3.1, UP3.5 (IN)
/PRE_LEFT: CE2.1, COUT2A.1, COUT2B.1, L2.2, RFH2.1, ROVH2.1, RUVH2.1, UP2.5 (IN)
/PRE_RIGHT: CE4.1, COUT4A.1, COUT4B.1, L4.2, RFH4.1, ROVH4.1, RUVH4.1, UP4.5 (IN)
/RLIM2: RLIM2.1, U2.7 (RLIM)
/RLIM3: RLIM3.1, U3.7 (RLIM)
/RLIM4: RLIM4.1, U4.7 (RLIM)
/SW2: CB2.2, L2.1, U2.1 (SW)
/SW3: CB3.2, L3.1, U3.1 (SW)
/SW4: CB4.2, L4.1, U4.1 (SW)
/USB5V_CENTRE: CUSB3.1, J3.1, UP3.6 (OUT)
/USB5V_LEFT: CUSB2.1, J2.1, UP2.6 (OUT)
/USB5V_RIGHT: CUSB4.1, J4.1, UP4.6 (OUT)
/UV_CENTRE: RUVH3.2, RUVL3.1, UP3.1 (EN_UVLO)
/UV_IN: RUVINH.2, RUVINL.1, UIN.6 (UVLO)
/UV_LEFT: RUVH2.2, RUVL2.1, UP2.1 (EN_UVLO)
/UV_RIGHT: RUVH4.2, RUVL4.1, UP4.1 (EN_UVLO)
/VBUS_USB: F1.1, J1.A4 (VBUS), J1.A9 (VBUS), J1.B4 (VBUS), J1.B9 (VBUS)
/VPROT: CBULK1.1, CBULK2.1, CBULK3.1, CIN2A.1, CIN2B.1, CIN3A.1, CIN3B.1, CIN4A.1, CIN4B.1, RPGH.1, RPGPU.1, U2.8 (VIN), U3.8 (VIN), U4.8 (VIN), UIN.17 (OUT), UIN.18 (OUT)
/VRAW: CPD.1, CSYS.1, DTVS.1 (A1), F1.2, ROVINH.1, RUVINH.1, UIN.1 (IN), UIN.2 (IN), UIN.5 (IN_SYS), UPD.1 (VHV), UPD.8 (VBUS_SENSE)

Notes on the sheet:
PG intentionally unused; PCB single-pad /PD_GOOD has no copper.
INPUT / USB-C PD negotiation
INPUT / eFuse and system enable
PROTECTED INPUT / shared polymer bank
RSET = 56k requests fixed 15 V PDO. A 35 W label alone does not guarantee 15 V.
MODE / SHDN open: latch-off fault mode / internally enabled.
NC19-24 are unused. EP25 and GND8 both connect to GND.
82uF x3 / 35V. Keep local MLCCs at each buck VIN.
Design target: 5 V / 1.5 A continuous per channel.
Verify load transient, ripple and temperature on first article.
PWR_FLAG: external source/GND, fuse output, and LC-derived rails.
Power flags document sources behind passive parts; they add no hardware.
Common ground. Independent regulators and protection; no galvanic isolation.
LEFT / fixed 4.984 V buck
VOUT = 0.8 x (1 + 52.3k / 10k). RT7272B + 6.8uH.
OUTPUT / UVLO, OVLO and current limiting
CENTRE / fixed 4.984 V buck
RIGHT / fixed 4.984 V buck

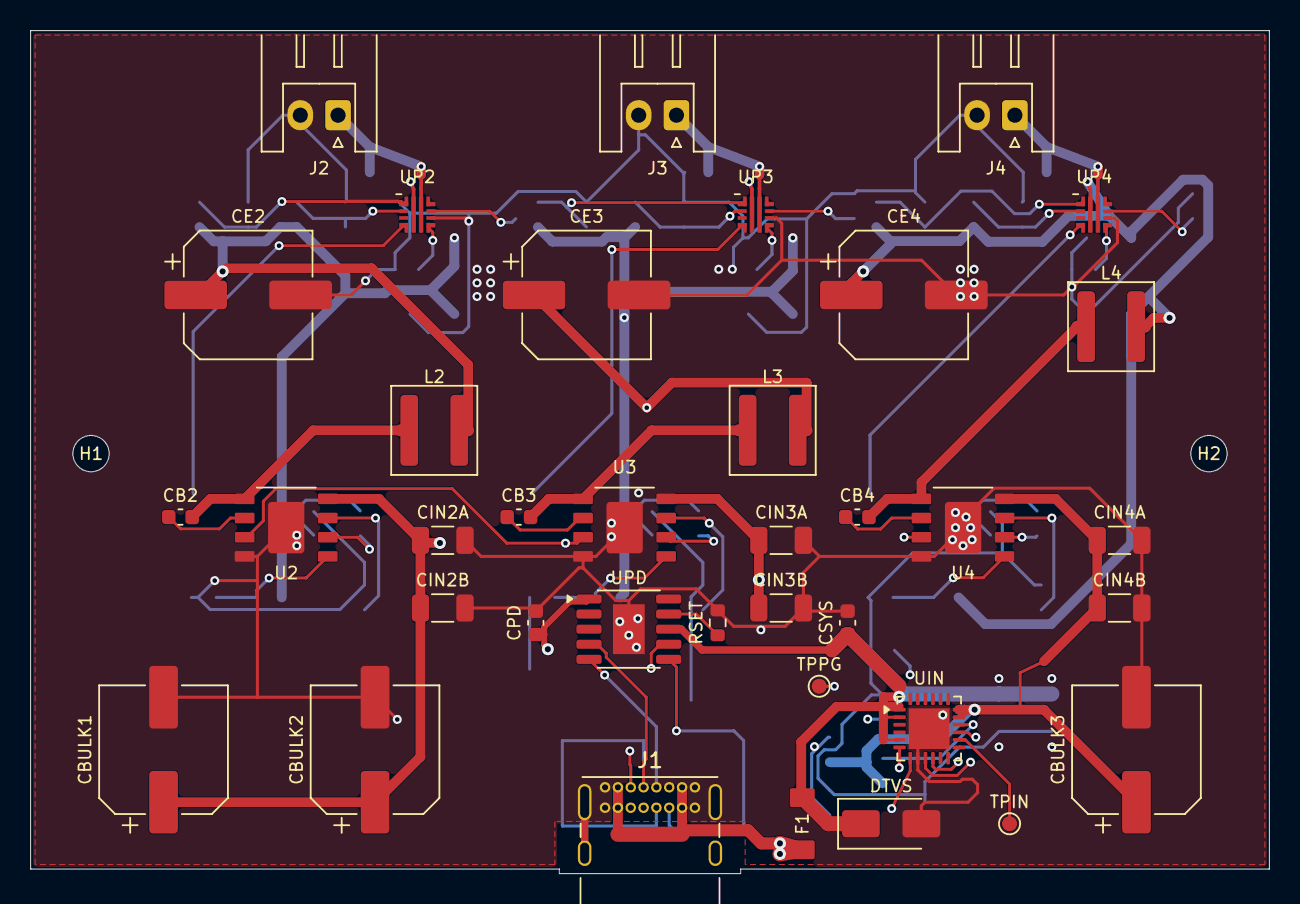
[picture p30: board power_pd_3x5v_r4.kicad_pcb from above]

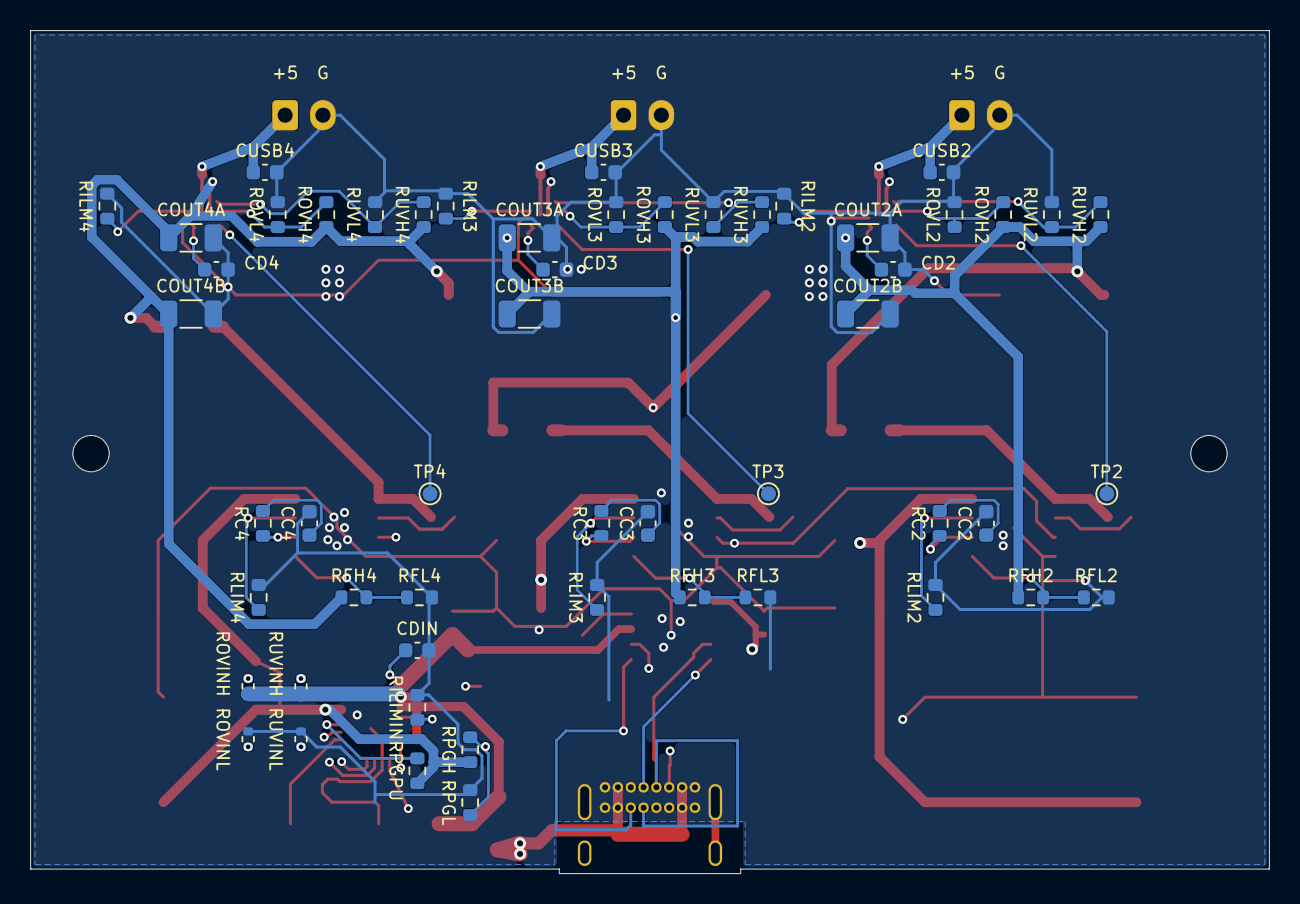
[picture p31: board power_pd_3x5v_r4.kicad_pcb from below]

Board: 4 copper layers, 82.0 x 55.8 mm, 93 parts (54 on the bottom side), 55 nets.
