omniscientjoker/obd_brz_gauge/main/app_main.c

/*
 * SPDX-FileCopyrightText: 2023-2024 Espressif Systems (Shanghai) CO LTD
 *
 * SPDX-License-Identifier: CC0-1.0
 */
// Original author: Ray.Zhai
// Date: 2025-09-14
// Adapted for Waveshare ESP32-S3-Touch-LCD-1.85 by adaptation

#include <stdio.h>
#include <inttypes.h>

#include "freertos/FreeRTOS.h"
#include "freertos/task.h"
#include "driver/gpio.h"
#include "esp_timer.h"
#include "esp_err.h"
#include "esp_log.h"
#include "esp_task_wdt.h"
#include "esp_ota_ops.h"

#include "lvgl.h"

/* Waveshare BSP drivers */
#include "bsp_obd_dsp/i2c_driver/I2C_Driver.h"
#include "bsp_obd_dsp/esp_battery.h"
#if CONFIG_OBD_HW_VERSION_V1_WAVESHARE
#include "bsp_obd_dsp/exio/TCA9554PWR.h"
#endif
#include "bsp_obd_dsp/lcd_driver/ST77916.h"       // internally includes CST816.h & TCA9554PWR.h

/* Application layer */
#include "bsp_obd_dsp/bsp_board.h"
#include "bsp_obd_dsp/elm327_ble_client.h"
#include "bsp_obd_dsp/espnow_link.h"
#include "bsp_obd_dsp/racechrono_ble_diy.h"
#include "app_obd_dsp/boot_media_mount.h"
#include "app_media/sd_media_manager.h"
#include "app_media/media_alert.h"
#include "app_media/usb_sd_storage.h"
#include "app_media/es8311_audio.h"
#include "app_media/wav_player.h"
#include "bsp_obd_dsp/rs485_brake_temp.h"
#if CONFIG_OBD_HW_VERSION_V1_WAVESHARE
#include "bsp_obd_dsp/ads1115_oil_pressure.h"
#endif
#include "app_obd_dsp/obd_data_cache.h"
#include "app_obd_dsp/vehicle_profiles.h"
#include "export_path/ui_ext.h"
#include "export_path/ui_helpers.h"
#include "export_path/ui_usb_storage.h"
#include "app_obd_dsp/app_event.h"
#include "theme_engine/theme_interface.h"
#if CONFIG_GAUGE_FIRMWARE_MASTER
#include "master/gauge_uart_tx.h"
#endif

// ===== Triple-gauge roles =====
// Normally select master/slave via "Settings page -> swipe down to the MULTI-GAUGE page" (stored in NVS device_role, effective after reboot); one firmware is enough.
// The macro below is only a debug forced override: uncommenting it ignores the setting and forces this board to slave. Keep it commented out normally.
// #define ESPNOW_FORCE_SLAVE

#if CONFIG_GAUGE_FIRMWARE_MASTER

static const char *TAG = "obd_dsp";

static void start_media_services(void)
{
    nvs_user_cfg_t cfg = {0};
    nvs_cfg_get_snapshot(&cfg);
    esp_err_t audio_init_err = es8311_audio_init();
    if (audio_init_err == ESP_OK) {
        esp_err_t volume_err = es8311_audio_set_volume(cfg.audio_volume);
        ESP_LOGI(TAG, "Audio volume: %u%% (%s)", cfg.audio_volume,
                 esp_err_to_name(volume_err));
        esp_err_t wav_init_err = wav_player_init();
        if (wav_init_err != ESP_OK) {
            ESP_LOGW(TAG, "WAV player unavailable (%s)", esp_err_to_name(wav_init_err));
        }
    } else {
        ESP_LOGW(TAG, "ES8311 audio unavailable (%s)", esp_err_to_name(audio_init_err));
    }

    esp_err_t sd_init_err = sd_media_init();
    if (sd_init_err != ESP_OK) {
        ESP_LOGW(TAG, "SD media service unavailable (%s)", esp_err_to_name(sd_init_err));
    }

    esp_err_t alert_init_err = media_alert_init();
    if (alert_init_err != ESP_OK) {
        ESP_LOGW(TAG, "Media alert service unavailable (%s)",
                 esp_err_to_name(alert_init_err));
    }
}

static void mark_app_valid_task(void *arg)
{
    (void)arg;

    vTaskDelay(pdMS_TO_TICKS(20000));

    esp_err_t err = esp_ota_mark_app_valid_cancel_rollback();
    if (err == ESP_OK) {
        ESP_LOGI(TAG, "Current firmware marked valid");
    } else if (err != ESP_ERR_OTA_ROLLBACK_INVALID_STATE) {
        ESP_LOGW(TAG, "Failed to mark firmware valid: %s", esp_err_to_name(err));
    }

    vTaskDelete(NULL);
}

extern void ui_init(void);
#if CONFIG_GAUGE_FIRMWARE_MASTER
SemaphoreHandle_t lvgl_mux = NULL; // non-static: used by BLE scan page
#endif

////////////////////////////////////////////////////////////////////////////////////////////////////////////////////////
//////////////////// LCD & LVGL configuration ///////////////////////////////////////////////////////////////////////////////////
////////////////////////////////////////////////////////////////////////////////////////////////////////////////////////

/* Resolution comes directly from the macros in ST77916.h */
#define LCD_H_RES               EXAMPLE_LCD_WIDTH       // 360
#define LCD_V_RES               EXAMPLE_LCD_HEIGHT      // 360
#define LCD_BIT_PER_PIXEL       EXAMPLE_LCD_COLOR_BITS  // 16

/* LVGL parameters */
#define LVGL_BUFF_SIZE              (LCD_H_RES * 20)
#define LVGL_TICK_PERIOD_MS         2
#define LVGL_TASK_MAX_DELAY_MS      500
#define LVGL_TASK_MIN_DELAY_MS      2
#define LVGL_TASK_STACK_SIZE        (8 * 1024)
#define LVGL_TASK_PRIORITY          4   // raised (was 2): less prone to dropping frames from preemption by BLE/OBD (priority 4) during animations

////////////////////////////////////////////////////////////////////////////////////////////////////////////////////////
//////////////////// LVGL callbacks /////////////////////////////////////////////////////////////////////////////////////
////////////////////////////////////////////////////////////////////////////////////////////////////////////////////////

/* Notify LVGL on DMA transfer complete */
static bool notify_lvgl_flush_ready(esp_lcd_panel_io_handle_t panel_io,
                                     esp_lcd_panel_io_event_data_t *edata,
                                     void *user_ctx)
{
    lv_disp_drv_t *disp_driver = (lv_disp_drv_t *)user_ctx;
    lv_disp_flush_ready(disp_driver);
    return false;
}

/* LVGL flush callback */
static void lvgl_flush_cb(lv_disp_drv_t *drv, const lv_area_t *area, lv_color_t *color_map)
{
    esp_lcd_panel_handle_t panel = (esp_lcd_panel_handle_t)drv->user_data;
    esp_lcd_panel_draw_bitmap(panel, area->x1, area->y1,
                              area->x2 + 1, area->y2 + 1, color_map);
}

/* Coordinate alignment (even boundaries) */
static void lvgl_rounder_cb(lv_disp_drv_t *disp_drv, lv_area_t *area)
{
    area->x1 = (area->x1 >> 1) << 1;
    area->y1 = (area->y1 >> 1) << 1;
    area->x2 = ((area->x2 >> 1) << 1) + 1;
    area->y2 = ((area->y2 >> 1) << 1) + 1;
}

////////////////////////////////////////////////////////////////////////////////////////////////////////////////////////
//////////////////// Touch input callbacks //////////////////////////////////////////////////////////////////////////////////////
////////////////////////////////////////////////////////////////////////////////////////////////////////////////////////

/* Touch read callback (polling mode) */
static void lvgl_touch_cb(lv_indev_drv_t *drv, lv_indev_data_t *data)
{
    esp_lcd_touch_handle_t touch = (esp_lcd_touch_handle_t)drv->user_data;
    assert(touch);

    uint16_t tp_x, tp_y;
    uint8_t tp_cnt = 0;

    esp_lcd_touch_read_data(touch);

    bool pressed = esp_lcd_touch_get_coordinates(touch, &tp_x, &tp_y, NULL, &tp_cnt, 1);
    if (pressed && tp_cnt > 0) {
        data->point.x = tp_x;
        data->point.y = tp_y;
        data->state = LV_INDEV_STATE_PRESSED;
    } else {
        data->state = LV_INDEV_STATE_RELEASED;
    }
}

////////////////////////////////////////////////////////////////////////////////////////////////////////////////////////
//////////////////// LVGL timers & tasks ////////////////////////////////////////////////////////////////////////////////
////////////////////////////////////////////////////////////////////////////////////////////////////////////////////////

static void increase_lvgl_tick(void *arg)
{
    lv_tick_inc(LVGL_TICK_PERIOD_MS);
}

static bool lvgl_lock(int timeout_ms)
{
    assert(lvgl_mux && "lvgl_mux not created");
    const TickType_t timeout_ticks = (timeout_ms == -1) ? portMAX_DELAY : pdMS_TO_TICKS(timeout_ms);
    return xSemaphoreTake(lvgl_mux, timeout_ticks) == pdTRUE;
}

static void lvgl_unlock(void)
{
    assert(lvgl_mux && "lvgl_mux not created");
    xSemaphoreGive(lvgl_mux);
}

static void lvgl_port_task(void *arg)
{
    uint32_t task_delay_ms = LVGL_TASK_MAX_DELAY_MS;
    while (1) {
        if (lvgl_lock(-1)) {
            task_delay_ms = lv_timer_handler();
            lvgl_unlock();
        }
        if (task_delay_ms > LVGL_TASK_MAX_DELAY_MS) {
            task_delay_ms = LVGL_TASK_MAX_DELAY_MS;
        } else if (task_delay_ms < LVGL_TASK_MIN_DELAY_MS) {
            task_delay_ms = LVGL_TASK_MIN_DELAY_MS;
        }
        vTaskDelay(pdMS_TO_TICKS(task_delay_ms));
    }
}

////////////////////////////////////////////////////////////////////////////////////////////////////////////////////////
//////////////////// Main function ////////////////////////////////////////////////////////////////////////////////////////////
////////////////////////////////////////////////////////////////////////////////////////////////////////////////////////

void app_main(void)
{
    static lv_disp_draw_buf_t disp_buf;
    static lv_disp_drv_t disp_drv;
    const bool usb_transfer_boot = usb_sd_take_boot_request();

    /* 1. NVS init (must be first) */
    nvs_storage_init();

    /* 1.5 Task watchdog: 10s timeout, idle task not subscribed (avoids false triggers when BLE blocks) */
    esp_task_wdt_config_t wdt_cfg = {
        .timeout_ms = 10000,
        .idle_core_mask = 0,  // do not monitor idle task
        .trigger_panic = true,
    };
    esp_task_wdt_reconfigure(&wdt_cfg);

    /* 1.5 Vehicle profile init (loads the saved vehicle index from NVS) */
    nvs_user_cfg_t user_cfg_snapshot = {0};
    nvs_cfg_get_snapshot(&user_cfg_snapshot);
    const nvs_user_cfg_t *user_cfg = &user_cfg_snapshot;
    vehicle_profile_set_active(user_cfg->vehicle_profile_idx);
    const nvs_stat_t *stat = nvs_stat_get();
    ESP_LOGI("NVS", "cfg: proto=%u theme=%u profile=%u(%s) odo=%" PRIu64 " trip=%" PRIu64 " max=%d avg=%d run=%" PRIu64,
             user_cfg->protocol, user_cfg->theme_cfg.theme,
             user_cfg->vehicle_profile_idx, vehicle_profile_get_active()->name,
             stat->odometer_m, stat->trip_m, stat->max_speed_kmh, stat->avg_speed_kmh, stat->run_time_s);

    /* 2. I2C bus init (used by the TCA9554 IO expander + CST816 touch on V1, CST816 touch only on V2/V3) */
    I2C_Init();
    esp_battery_start();

    /* 3. IO expander init (TCA9554PWR, I2C address 0x20) — V1 board only; V2/V3 have no expander */
#if CONFIG_OBD_HW_VERSION_V1_WAVESHARE
    EXIO_Init();
#endif

    /* 4. LCD + backlight + touch combined init
     *    LCD_Init() internally calls, in order:
     *      ST77916_Init() → reset (1.85B: GPIO3; V2/V3: direct GPIO 47) → QSPI SPI bus & ST77916 panel driver
     *      Backlight_Init() → LEDC PWM backlight (V1: GPIO 5; V2/V3: GPIO 15)
     *      Touch_Init() → CST816S on the board's shared GPIO10/11 I2C bus
     *    A missing touch controller leaves the display available in read-only mode.
     */
    LCD_SetFlushCallback(notify_lvgl_flush_ready, &disp_drv);
    LCD_Backlight = 0;  // set to 0 before LCD_Init to prevent Backlight_Init from lighting an uninitialized panel
    esp_err_t touch_init_err = LCD_Init();
    if (touch_init_err != ESP_OK) {
        ESP_LOGW(TAG, "Touch initialization failed (%s); starting without touch input",
                 esp_err_to_name(touch_init_err));
    }

    /* 5. LVGL init */
    lv_init();

    /* Allocate double buffers (DMA memory). Larger buffers -> full-screen render strips halved -> higher frame rate.
       Only affects LVGL render chunking, not the SPI single-transfer size (still chunked by max_transfer_sz), so no screen corruption.
       Falls back automatically to the original 20 lines when internal DMA RAM is insufficient, avoiding boot-time OOM. */
    size_t buf_px = LCD_H_RES * 40;
    lv_color_t *buf1 = heap_caps_malloc(buf_px * sizeof(lv_color_t), MALLOC_CAP_DMA);
    lv_color_t *buf2 = heap_caps_malloc(buf_px * sizeof(lv_color_t), MALLOC_CAP_DMA);
    if (!buf1 || !buf2) {
        heap_caps_free(buf1); heap_caps_free(buf2);
        buf_px = LVGL_BUFF_SIZE;   // fall back to 20 lines
        buf1 = heap_caps_malloc(buf_px * sizeof(lv_color_t), MALLOC_CAP_DMA);
        buf2 = heap_caps_malloc(buf_px * sizeof(lv_color_t), MALLOC_CAP_DMA);
    }
    assert(buf1 && buf2);
    lv_disp_draw_buf_init(&disp_buf, buf1, buf2, buf_px);

    /* Register display driver */
    lv_disp_drv_init(&disp_drv);
    disp_drv.hor_res = LCD_H_RES;
    disp_drv.ver_res = LCD_V_RES;
    disp_drv.flush_cb = lvgl_flush_cb;
    disp_drv.rounder_cb = lvgl_rounder_cb;
    disp_drv.draw_buf = &disp_buf;
    disp_drv.user_data = panel_handle;      // from ST77916.h extern
    lv_disp_t *disp = lv_disp_drv_register(&disp_drv);

    /* LVGL tick timer (2ms period) */
    const esp_timer_create_args_t lvgl_tick_timer_args = {
        .callback = &increase_lvgl_tick,
        .name = "lvgl_tick"
    };
    esp_timer_handle_t lvgl_tick_timer = NULL;
    ESP_ERROR_CHECK(esp_timer_create(&lvgl_tick_timer_args, &lvgl_tick_timer));
    ESP_ERROR_CHECK(esp_timer_start_periodic(lvgl_tick_timer, LVGL_TICK_PERIOD_MS * 1000));

    /* Register touch input only after the controller has responded successfully. */
    if (tp != NULL) {
        static lv_indev_drv_t indev_drv;
        lv_indev_drv_init(&indev_drv);
        indev_drv.type = LV_INDEV_TYPE_POINTER;
        indev_drv.disp = disp;
        indev_drv.read_cb = lvgl_touch_cb;
        indev_drv.user_data = tp;
        lv_indev_drv_register(&indev_drv);
    }

    /* 6. Start LVGL task */
    lvgl_mux = xSemaphoreCreateMutex();
    assert(lvgl_mux);
    static TaskHandle_t s_lvgl_task_handle = NULL;
    xTaskCreate(lvgl_port_task, "LVGL", LVGL_TASK_STACK_SIZE, NULL, LVGL_TASK_PRIORITY, &s_lvgl_task_handle);
    // exposed to ui.c for temporarily raising priority during flashing
    extern TaskHandle_t g_lvgl_task_handle;
    g_lvgl_task_handle = s_lvgl_task_handle;

    BaseType_t valid_task_started = xTaskCreate(mark_app_valid_task, "ota_valid", 4096, NULL, tskIDLE_PRIORITY + 1, NULL);
    if (valid_task_started != pdPASS) {
        ESP_LOGW(TAG, "Failed to create OTA validity task");
    }

    /* Dedicated transfer boot: no BLE, OBD, local SD mount, media playback or
     * UART services may access the card while the computer owns it. A restart
     * back to normal mode mounts SD and rebuilds the resource table once. */
    if (usb_transfer_boot) {
        Set_Backlight(user_cfg->brightness_day);
        if (lvgl_lock(-1)) {
            ui_usb_storage_show();
            lvgl_unlock();
        }
        esp_err_t usb_err = usb_sd_start();
        if (usb_err != ESP_OK) ESP_LOGE(TAG, "USB transfer unavailable: %s", esp_err_to_name(usb_err));
        return;
    }

    /* 6.5 Initialize Bluetooth stack BEFORE UI to claim internal RAM early */
    elm327_ble_ensure_stack_init();

    /* 7. Start UI. The legacy Logo page is optional; video boot can start directly. */
#if ENABLE_BOOT_LOGO_PAGE
    ESP_LOGI(TAG, "Creating and displaying logo page");
    if (lvgl_lock(-1)) {
        lv_disp_t * dispp = lv_disp_get_default();
        lv_theme_t * theme = lv_theme_default_init(dispp, lv_palette_main(LV_PALETTE_BLUE), lv_palette_main(LV_PALETTE_RED),
                                                   false, LV_FONT_DEFAULT);
        lv_disp_set_theme(dispp, theme);
        ui_helpers_init_edge_ring();
        extern void ui_ScreenPageLogo_screen_init(void);
        extern lv_obj_t * ui_ScreenPageLogo;
        ui_ScreenPageLogo_screen_init();
        lv_disp_load_scr(ui_ScreenPageLogo);
        lv_refr_now(dispp);
        lvgl_unlock();
    }
    ESP_LOGI(TAG, "Startup logo refreshed; continuing UI initialization");
    vTaskDelay(pdMS_TO_TICKS(50));
#else
    ESP_LOGI(TAG, "Legacy logo page disabled; boot animation will start directly");
#endif

    ESP_LOGI(TAG, "Starting theme load");
    // Load the theme and create the remaining UI elements.
    if (lvgl_lock(-1)) {
        ui_init();  // Now loads theme with logo already displayed
        ui_ext_init();
        lvgl_unlock();
    }
    app_event_init();

    /* 7.5 Mount bootmedia SPIFFS and start animation BEFORE role-specific init (prevents Master black screen delay) */
    boot_media_mount();
    boot_media_recover_previous_if_needed();

    /* 8. Branch by role: master (connects to ELM327 for readings + ESP-NOW broadcast) / slave (only receives and displays the master's data) */
    /* The dedicated master image owns OBD and the two UART links regardless
       of the legacy ESP-NOW device_role stored by older firmware. */
    uint8_t dev_role = ESPNOW_ROLE_MASTER;
#ifdef ESPNOW_FORCE_SLAVE
    dev_role = ESPNOW_ROLE_SLAVE;   // step 1 test: force slave
#endif

    if (dev_role == ESPNOW_ROLE_SLAVE) {
        /* ---- Slave: does not connect to ELM327; data arrives through the paired BLE path. ----
           Screen navigation (not bound to a master → BLE pairing page; bound → normal boot flow) is handled
           centrally by boot_enter_default_page() in ui.c; nothing to do here. */
        ESP_LOGI(TAG, "Device role: SLAVE (paired BLE receiver, no ELM327)");
        {
            const uint8_t *bm = espnow_link_get_bound_master_mac();
            ESP_LOGD(TAG, "Bound master MAC at boot: %02x:%02x:%02x:%02x:%02x:%02x (0=unbound)",
                     bm[0], bm[1], bm[2], bm[3], bm[4], bm[5]);
        }
        /* Slave: start BLE GATTS for pairing. */
        racechrono_ble_diy_start(user_cfg->rc_enabled);
    } else {
        ESP_LOGI(TAG, "Device role: %s (BLE/OBD, Wi-Fi deferred to OTA)",
                 dev_role == ESPNOW_ROLE_MASTER ? "MASTER" : "STANDALONE");

        /* 8.1 Start BLE OBD - auto-connect only when a MAC is already bound in NVS (exact MAC match only, no fuzzy name matching);
               legacy configs with a name but no MAC no longer auto-connect; the user must re-select on the scan page to bind the MAC.
               MASTER starts the Bluetooth stack even without a configured OBD device, so it can broadcast the SkyGauge pairing signal. */
        bool has_obd_mac = (user_cfg->ble_obd_mac[0] | user_cfg->ble_obd_mac[1] |
                            user_cfg->ble_obd_mac[2] | user_cfg->ble_obd_mac[3] |
                            user_cfg->ble_obd_mac[4] | user_cfg->ble_obd_mac[5]) != 0;
        if (has_obd_mac) {
            ESP_LOGD(TAG, "BLE target device: %s (mac=%02x:%02x:%02x:%02x:%02x:%02x, MAC-only match)",
                     user_cfg->ble_device_name,
                     user_cfg->ble_obd_mac[0], user_cfg->ble_obd_mac[1], user_cfg->ble_obd_mac[2],
                     user_cfg->ble_obd_mac[3], user_cfg->ble_obd_mac[4], user_cfg->ble_obd_mac[5]);
            elm327_ble_start_default(user_cfg->ble_device_name, user_cfg->ble_obd_mac);
        } else if (user_cfg->ble_device_name[0] != '\0') {
            ESP_LOGD(TAG, "Saved device '%s' has no bound MAC, auto-connect disabled; re-select it on BLE SCAN page to bind MAC",
                     user_cfg->ble_device_name);
            elm327_ble_ensure_stack_init();   // the stack must still be started for RaceChrono/the scan page
        } else if (dev_role == ESPNOW_ROLE_MASTER) {
            ESP_LOGD(TAG, "No saved BLE device; MASTER starts the BLE stack for pairing");
            elm327_ble_ensure_stack_init();
        } else {
            ESP_LOGD(TAG, "No saved BLE device, waiting for user selection");
        }

        /* 9. Start RS485 brake temperature acquisition (V1 board only).
           V2/V3 have no RS485 hardware; also, its UART pins (TX=13/RX=12 from
           CONFIG_OBD_RS485_*) collide with the LCD QSPI DATA2/DATA1 lines, so
           it must never run on the new boards. */
#if CONFIG_OBD_HW_VERSION_V1_WAVESHARE
        rs485_brake_temp_start();
#endif

        /* 9.5 Start oil pressure acquisition (external ADS1115 ADC — V1 board only).
           Skip the external ADS1115 ADC for profiles that read oil pressure over OBD
           (e.g. Supra A90 — DID 4436, BMW E — DID 586F), to avoid the ADC overwriting OBD data.
           V2/V3 boards have no ADS1115. */
#if CONFIG_OBD_HW_VERSION_V1_WAVESHARE
        {
            const vehicle_profile_t *vp = vehicle_profile_get_active();
            if (!(vp && vp->obd_oil_pressure_did != 0)) {
                oil_pressure_start();
            }
        }
#endif

        /* 9.8 Wi-Fi is OTA-only. Multi-gauge traffic remains on BLE. */

        /* 9.9 Start RaceChrono BLE GATTS (Master/Standalone). */
        racechrono_ble_diy_start(user_cfg->rc_enabled);

        /* 10. Mileage statistics task (only the master counts, to avoid double counting by the slave) */
        vMileageDataStatisticTask();
    }

    /* Media services run after the BLE role has been established. */
    start_media_services();

    /* The master is the only owner of OBD parsing. UART1/UART2 only publish
       the already-parsed snapshot to the two physical slave slots. */
    esp_err_t link_err = gauge_uart_tx_start();
    if (link_err != ESP_OK) ESP_LOGE(TAG, "Gauge UART link unavailable: %s", esp_err_to_name(link_err));

}
#endif
