omniscientjoker/obd_brz_gauge/main/bsp_obd_dsp/elm327_ble_client.c

#include "elm327_ble_client.h"
#include "freertos/FreeRTOS.h"
#include "freertos/task.h"
#include "freertos/queue.h"
#include "esp_bt.h"
#include "esp_bt_main.h"
#include "esp_gap_ble_api.h"
#include "esp_gattc_api.h"
#include "esp_gatt_common_api.h"
#include "esp_bt_defs.h"
#include "esp_log.h"
#include "esp_timer.h"
#include "nvs_flash.h"
#include "app_obd_dsp/obd_data_cache.h"
#include "app_obd_dsp/obd_composition.h"
#include "app_obd_dsp/obd_response_dispatch.h"
#include "app_obd_dsp/obd_request_plan.h"
#include "app_obd_dsp/obd_channel_arbiter.h"
#include "app_obd_dsp/obd_manager.h"
#include "app_obd_dsp/obd_tpms_cache.h"
#include "app_obd_dsp/obd_special_mode21.h"
#include "app_obd_dsp/obd_special_bmw.h"
#include "app_obd_dsp/vehicle_profiles.h"
#include "app_obd_dsp/vehicle_custom_config.h"
#include "racechrono_ble_diy.h"
#include "ble_adv_util.h"
#include "esp_task_wdt.h"
#include <string.h>
#include <stdlib.h>
#include <ctype.h>
#include <stdio.h>
#include "nvs_storage.h"

// UUID constants
#define UUID16_OBD_SERVICE      0xFFF0  // common ELM327 BLE adapters (FFF1 write / FFF2 notify)
#define UUID16_OBD_SERVICE_18F0  0x18F0  // IOS-Vlink / Vlink (2AF1 write / 2AF0 notify)
#define UUID16_OBD_SERVICE_FF12  0xFF12  // config service of some adapters (e.g. Viecar) (FF15 write / FF14 notify)
#define UUID16_OBD_WRITE_CHAR    0xFFF1
#define UUID16_CCCD              0x2902

static const char *TAG = "elm327_ble";
static void gattc_event_handler(esp_gattc_cb_event_t event,
                                esp_gatt_if_t gattc_if,
                                esp_ble_gattc_cb_param_t *param);

static esp_gatt_if_t s_gattc_if = ESP_GATT_IF_NONE;   // 0 is a valid real interface number; NONE distinguishes "not registered yet"
static uint16_t s_conn_id = 0xFFFF;
static esp_bd_addr_t s_peer_bda = {0};
static volatile bool s_connected = false;
static bool s_have_service = false;
static uint16_t s_service_start = 0x0001, s_service_end = 0xFFFF; // default: full range
static uint16_t s_all_attr_end = 0xFFFF; // tracks highest seen end handle
static bool s_have_18f0 = false;          // 0x18F0 service (the real OBD communication service of IOS-Vlink)
static uint16_t s_18f0_start = 0, s_18f0_end = 0;
static bool s_have_ff12 = false;          // 0xFF12 service (fallback)
static uint16_t s_ff12_start = 0, s_ff12_end = 0;
static uint16_t s_char_write_handle = 0; // FFF1
static uint16_t s_char_notify_handle = 0; // prefer FFF2, fall back to FFF1 if absent
static uint16_t s_cccd_handle = 0;
static esp_gatt_write_type_t s_write_type = ESP_GATT_WRITE_TYPE_RSP; // write type, auto-selected from characteristic properties
static elm327_ble_callbacks_t s_cbs = {0};
static char s_target_name[32] = "OBDII";
// Exact MAC match: once set, match_device_target accepts only this address and ignores the name (prevents misconnecting to same-named devices)
static esp_bd_addr_t s_target_bda = {0};
static bool s_target_bda_valid = false;
static volatile bool s_connection_failed = false;

// ---- Scan mode related ----
static bool s_scan_only_mode = false;  // true=scan only, no connect
static ble_scan_found_cb_t s_scan_cb = NULL;
static ble_scan_result_t s_scan_list[BLE_SCAN_MAX_DEVICES];
static int s_scan_count = 0;
static bool s_scan_params_ready = false;
static bool s_scan_start_pending = false;
static int s_scan_pending_duration = 0;
static bool s_ble_inited = false;  // whether the BLE stack has been initialized
static bool s_poll_task_started = false; // whether the poll task has been created
static volatile bool s_ota_paused = false; // during WiFi OTA: suppress auto-reconnect + polling so BLE stops competing for the radio
static TaskHandle_t s_poll_task_handle = NULL; // poll task handle, used for task-notification wakeup
static QueueHandle_t s_rx_queue = NULL;
static volatile bool s_rx_dispatching = false;
#define OBD_RX_QUEUE_LENGTH 8
#define OBD_RX_MAX_NOTIFY 512
typedef struct {
    uint16_t len;
    uint8_t data[OBD_RX_MAX_NOTIFY];
} obd_rx_item_t;
static struct {
    uint32_t rx_enqueued;
    uint32_t rx_dropped;
    uint32_t rx_processed;
    uint32_t poll_slots;
    uint32_t poll_rounds;
    uint32_t valid_frames;
    uint32_t disconnects;
    uint32_t queue_high_watermark;
    int64_t last_rx_us;
} s_runtime_stats;
static portMUX_TYPE s_runtime_mux = portMUX_INITIALIZER_UNLOCKED;
static volatile bool s_notify_ready = false;   // set only after CCCD notify subscription completes; init/poll proceed based on this (prevents losing handshake responses)
static volatile int64_t s_last_obd_valid_us = 0; // time of the last valid OBD data; a timeout without data triggers self-heal re-init
static volatile bool s_got_valid_data = false;   // whether a genuinely valid frame has been parsed since the last poll round; set only by the parse path (not by do_elm_init), lets the poll task clear the self-heal counter
static uint8_t s_oil_query_mode = 0;     // current query mode index (0-2)

// Called when valid OBD data is parsed: refreshes the "valid data" timestamp and sets the flag.
// do_elm_init only sets the timestamp and does NOT go through here — just having initialized does not mean "data is flowing". Otherwise heal_attempts
// would be cleared right after every re-init, and "3 consecutive self-heals escalate to forced reconnect" could never be reached.
static inline void mark_obd_data_valid(void) {
    s_last_obd_valid_us = esp_timer_get_time();
    s_got_valid_data = true;
    s_runtime_stats.valid_frames++;
}

bool elm327_ble_send_ascii_blocking(const char *ascii_cmd);

static bool send_special_command(void *ctx, const char *command)
{
    (void)ctx;
    return elm327_ble_send_ascii_blocking(command);
}

static bool send_rpm_request(const char *site)
{
    bool ok = elm327_ble_send_ascii_blocking("01 0C\r");
    if (!ok) {
        ESP_LOGW(TAG, "[RPM][REQ:%s] send failed", site);
    }
    return ok;
}

// ---- Data-driven override state ----
static const vehicle_override_t *s_ov = NULL;  // override config of the current vehicle profile
static const oil_formula_t *s_oil_formula_pri = NULL;   // primary oil-temp formula
static const oil_formula_t *s_oil_formula_sec = NULL;   // secondary oil-temp formula
static bool s_oil_use_override = false;  // true=use override formulas, false=use the legacy enum
static uint8_t s_oil_override_idx = 0;   // 0=primary, 1=secondary
static uint8_t s_oil_override_fail = 0;  // consecutive failure count of the current formula
#define OIL_OVERRIDE_FAIL_MAX 5
static obd_mode21_handler_context_t s_mode21_handler_context;

// ---- Vehicle-profile-based oil-temp query strategy ----
static oil_temp_query_mode_t s_oil_mode_priority[4] = {
    OIL_TEMP_MODE_PID_5C,
    OIL_TEMP_MODE_UDS_22_10_17,
    OIL_TEMP_MODE_TOYOTA_21_01,
};  // default priority, updated from the vehicle profile config after boot
static oil_temp_query_mode_t s_oil_active_mode = OIL_TEMP_MODE_PID_5C;
static uint8_t s_oil_active_fallback_rank = 0;
static bool s_pending_oil_query = false;
static bool s_pending_oil_value_handled = false;
static uint32_t s_oil_mode_fail_count[12] = {0};  // consecutive failure count per mode (poll idx 0~11)
#define OIL_MODE_FAIL_THRESHOLD 5  // switch to the next mode only after a mode fails this many times
#define OBD_POLL_SLOT_GAP_MS   30  // idle gap between poll slots (ms); was 100, lowered to raise refresh rate — too small overwhelms clone adapters
static bool s_vehicle_profile_inited = false;

// Runtime composition plan. The BLE transport remains in this file, while
// response decoding is delegated to the pure rule dispatcher. A failed plan
// build leaves the legacy switch/parser available as a compatibility fallback.
static obd_manager_t s_obd_manager;
#define s_composed_plan s_obd_manager.composed_plan
#define s_request_plan s_obd_manager.request_plan
#define s_response_dispatcher s_obd_manager.dispatcher
#define s_channel_arbiter s_obd_manager.arbiter
#define s_composition_runtime_ready s_obd_manager.ready
// ELM327 responses do not carry the request header after normalization. Keep
// the immutable rule header for the single in-flight request so identical
// DIDs addressed to different ECUs remain unambiguous.
static const char *s_pending_response_header = NULL;
// Legacy state for an optional ELM327 adapter-voltage query.  Vehicle battery
// voltage is read from the declarative Mode 01 PID 42 rule below; this parser
// remains only for compatibility with older command paths.
static volatile bool s_pending_adapter_voltage = false;

// SAE J1979 PID 00 only advertises 01..20. Fuel level is PID 2F, so probe
// PID 20 and require its support bitmap before sending any 01 2F request.
// This prevents a vehicle such as a 2013 Mondeo from receiving an unsupported
// command merely because another vehicle profile has a fuel-tank capacity.
typedef enum {
    FUEL_PID_SUPPORT_UNKNOWN = 0,
    FUEL_PID_SUPPORT_PROBING,
    FUEL_PID_SUPPORT_AVAILABLE,
    FUEL_PID_SUPPORT_UNAVAILABLE,
} fuel_pid_support_t;
static volatile fuel_pid_support_t s_fuel_pid_support = FUEL_PID_SUPPORT_UNKNOWN;
static const vehicle_profile_t *s_fuel_pid_profile = NULL;

static void reset_composition_runtime(void);

// Oil-temp diagnostic stats
static struct {
    uint32_t mode0_ok;  // 01 5C success count
    uint32_t mode1_ok;  // 22 10 17 success count
    uint32_t mode2_ok;  // 21 01 success count
    uint32_t mode3_ok;  // 22 11 1F (Mazda) success count
    uint32_t mode4_ok;  // 22 13 10 (Mazda) success count
    uint32_t mode5_ok;  // reserved
    uint32_t mode6_ok;  // 22 58 22 (MINI/BMW) success count
    uint32_t mode7_ok;  // 22 44 02 (BMW F-series) success count
    uint32_t mode8_ok;  // 22 03 F3 (BMW G-series) success count
    uint32_t mode9_ok;  // 22 44 02 G formula (BMW G-series) success count
    uint32_t mode10_ok; // 22 D0 02 (BMW G-series) success count
    uint32_t mode11_ok; // 22 11 1F (BMW, A-50) success count
    uint32_t mode0_fail;
    uint32_t mode1_fail;
    uint32_t mode2_fail;
    uint32_t mode3_fail;
    uint32_t mode4_fail;
    uint32_t mode5_fail;
    uint32_t mode6_fail;
    uint32_t mode7_fail;
    uint32_t mode8_fail;
    uint32_t mode9_fail;
    uint32_t mode10_fail;
    uint32_t mode11_fail;
    int16_t last_raw_temp; // raw temperature (unfiltered)
    int16_t last_filtered_temp; // filtered temperature
} s_oil_diag = {0};

static int8_t s_oil_temp_offset = 0;  // user calibration offset, in °C
static volatile int64_t s_can_oil_last_us = 0;      // last CAN oil-temp sample time
static volatile int64_t s_can_coolant_last_us = 0;  // last CAN coolant-temp sample time

// Global ready flag
static volatile bool s_elm_ready = true; // initially true so the first ATZ can be sent
static volatile bool s_expect_mode21 = false; // true=last command was 21 01, waiting for a 61 01 response
// ---- CAN continuous monitor mode (ATMA, parse each frame as it arrives) ----
static volatile bool s_zc6_can_monitor_active = false;
static bool s_zc_can_obd_phase = false;          // true=running the standard OBD poll
static bool s_zc_can_obd_round_started = false;  // false=just entered OBD phase, true=already consumed slot0 if needed
#define ZC6_CAN_MONITOR_BUF_SIZE 160
static char s_zc6_can_monitor_buf[ZC6_CAN_MONITOR_BUF_SIZE];
static size_t s_zc6_can_monitor_len = 0;
static int64_t s_zc6_can_monitor_entered_us = 0;   // time the monitor was entered
static uint32_t s_zc6_can_monitor_obd_cycle = 0;   // OBD query cycle counter while monitoring
#define ZC6_CAN_OBD_INTERVAL 50                     // exit ATMA every 50 cycles (~6s) to query OBD PIDs once
#define ZC6_CAN_TEMP_PROBE_INTERVAL_US 500000LL     // brief CAN-temp probe every 0.5s
#define ZC6_CAN_TEMP_PROBE_WINDOW_MS 120u           // shorter window to reduce RPM disturbance
#define ZC6_CAN_TEMP_STALE_US 15000000LL            // CAN temp channels stale after 15s without fresh frames
static int64_t s_zc6_can_temp_probe_last_us = 0;    // last time we briefly entered ATMA to refresh ZC6 CAN temps
bool elm327_ble_send_ascii_blocking(const char *ascii_cmd);
static bool can_rules_have_channel(const vehicle_override_t *ov, uint8_t channel);
static void record_oil_temp_success(oil_temp_query_mode_t mode);
static void record_oil_temp_failure(oil_temp_query_mode_t mode);
static void record_oil_query_failure(void);
static oil_temp_query_mode_t get_next_oil_query_mode(uint8_t *poll_idx);

// Accumulation buffer for multi-packet responses (21 01 responses span multiple BLE packets)
#define ACCUM_BUF_SIZE 512
static char s_accum_buf[ACCUM_BUF_SIZE];
static size_t s_accum_len = 0;
static int64_t s_accum_start_us = 0; // accumulation start time (us)

static const char *const s_zc6_can_monitor_enter_cmds_plain[] = {
    "ATE0\r", "ATL0\r", "ATS1\r", "ATH1\r", "ATMA\r",
};

// ---- Auto protocol detection ----
static volatile int s_protocol_detect_idx = -1;  // -1=not detecting, 0-10=protocol number being tried
static volatile bool s_protocol_detect_got_response = false;  // whether a valid response was received
static volatile int32_t s_protocol_detect_rpm = -1;  // detected RPM value (-1=none)

// ---- Oil-temp query mode conversion ----
// Convert oil_temp_query_mode_t to poll index (0-2)
static inline uint8_t oil_mode_to_poll_idx(oil_temp_query_mode_t mode) {
    switch (mode) {
        case OIL_TEMP_MODE_PID_5C: return 0;
        case OIL_TEMP_MODE_UDS_22_10_17: return 1;
        case OIL_TEMP_MODE_TOYOTA_21_01: return 2;
        case OIL_TEMP_MODE_MAZDA_22_111F: return 3;
        case OIL_TEMP_MODE_MAZDA_22_1310: return 4;
        case OIL_TEMP_MODE_MINI_22_5822: return 5;
        case OIL_TEMP_MODE_BMW_22_4402: return 6;
        case OIL_TEMP_MODE_BMW_22_03F3: return 7;
        case OIL_TEMP_MODE_BMW_G_22_4402: return 8;
        case OIL_TEMP_MODE_BMW_22_D002: return 9;
        case OIL_TEMP_MODE_BMW_22_111F: return 10;
        default: return 0;
    }
}

static const char *get_vehicle_fixed_header_cmd(void) {
    const vehicle_profile_t *vp = vehicle_profile_get_active();
    if (vp && vp->obd_functional_addr) {
        // 29-bit CAN functional broadcast (Honda Integra/Civic 11th gen and similar vehicles)
        if (vp->obd_29bit_functional) {
            return "ATSH18DB33F1\r";
        }
        // 11-bit functional addressing (vehicle-wide broadcast), same as phone apps; BMW needs this
        return "ATSH7DF\r";
    }
    return "ATSH7E0\r";     // physical addressing to the engine ECU; Subaru/default
}

static void composition_on_frame_valid(void *ctx, obd_response_service_t service)
{
    (void)ctx;
    (void)service;
    mark_obd_data_valid();
}

static void composition_on_value(void *ctx, const obd_data_rule_t *rule, float value)
{
    (void)ctx;
    if (!rule || (s_protocol_detect_idx >= 0 && rule->address != 0x0C)) return;
    if (!obd_channel_arbiter_publish(&s_channel_arbiter, rule, value,
                                     esp_timer_get_time())) return;

    switch (rule->channel) {
        case CH_RPM:
            if (s_protocol_detect_idx >= 0) {
                s_protocol_detect_rpm = (int32_t)value;
                s_protocol_detect_got_response = true;
            } else if (s_cbs.on_parsed_rpm) {
                s_cbs.on_parsed_rpm((uint16_t)value);
            }
            break;
        case CH_SPEED:
            if (s_cbs.on_parsed_speed_kmh) s_cbs.on_parsed_speed_kmh((uint8_t)value);
            break;
        case CH_COOLANT:
            if (s_cbs.on_parsed_coolant_temp)
                s_cbs.on_parsed_coolant_temp((uint32_t)(int32_t)value);
            break;
        case CH_INTAKE:
            if (s_cbs.on_parsed_intake_temp)
                s_cbs.on_parsed_intake_temp((uint32_t)(int32_t)value);
            break;
        case CH_OIL_TEMP:
            s_pending_oil_value_handled = true;
            if (rule->kind == OBD_RULE_MODE01) {
                record_oil_temp_success(OIL_TEMP_MODE_PID_5C);
            } else if (rule->kind == OBD_RULE_MODE22) {
                s_oil_override_fail = 0;
                record_oil_temp_success(s_oil_active_mode);
            }
            if (s_cbs.on_parsed_oil_temp)
                s_cbs.on_parsed_oil_temp((uint32_t)(int32_t)value);
            break;
        case CH_LOAD:
            if (s_cbs.on_parsed_load_pct) s_cbs.on_parsed_load_pct((uint32_t)value);
            break;
        case CH_TPS:
            if (s_cbs.on_parsed_throttle_position)
                s_cbs.on_parsed_throttle_position((uint32_t)value);
            break;
        case CH_MAP_KPA:
            if (s_cbs.on_parsed_manifold_pressure)
                s_cbs.on_parsed_manifold_pressure((uint32_t)value);
            break;
        case CH_BAT_MV:
            if (s_cbs.on_parsed_control_module_voltage)
                s_cbs.on_parsed_control_module_voltage((uint32_t)value);
            break;
        case CH_AFR_X100:
            if (s_cbs.on_parsed_afr) s_cbs.on_parsed_afr((uint32_t)value);
            break;
        case CH_FUEL_PCT:
            if (s_cbs.on_parsed_fuel_level) s_cbs.on_parsed_fuel_level((uint32_t)value);
            break;
        case CH_OIL_PRESSURE_HPA:
            if (s_cbs.on_parsed_oil_pressure)
                s_cbs.on_parsed_oil_pressure((uint32_t)value);
            break;
        case CH_GEAR_RAW:
            if (s_cbs.on_parsed_obd_gear)
                s_cbs.on_parsed_obd_gear((uint8_t)value);
            break;
        case CH_TPMS_FL_BAR_X100:
        case CH_TPMS_FR_BAR_X100:
        case CH_TPMS_RL_BAR_X100:
        case CH_TPMS_RR_BAR_X100:
            obd_tpms_cache_set((obd_tpms_wheel_t)(rule->channel - CH_TPMS_FL_BAR_X100),
                               value, esp_timer_get_time());
            break;
        default:
            break;
    }
}

static bool init_composition_runtime(void)
{
#if !OBD_COMPOSITION_ENABLE
    reset_composition_runtime();
    return false;
#else
    const obd_vehicle_composition_t *composition = obd_composition_get_active();
    static const obd_response_sink_t sink = {
        .on_value = composition_on_value,
        .on_frame_valid = composition_on_frame_valid,
    };
    if (!composition || !obd_manager_rebuild(&s_obd_manager, composition, &sink, NULL)) {
        // Do not leave a prior profile's plan, arbitration timestamps, or
        // TPMS values visible after a failed rebuild.
        reset_composition_runtime();
        return false;
    }
    obd_tpms_cache_reset();
    s_composition_runtime_ready = true;
    return true;
#endif
}

static void reset_composition_runtime(void)
{
    s_pending_response_header = NULL;
    s_pending_adapter_voltage = false;
    obd_manager_reset(&s_obd_manager);
}

static bool send_composed_slot(uint8_t slot_id)
{
    const obd_request_slot_t *slot;
    const obd_data_rule_t *rule;
    const vehicle_profile_t *profile = vehicle_profile_get_active();
    const vehicle_override_t *override = vehicle_profile_get_override();

    if (profile != s_fuel_pid_profile) {
        s_fuel_pid_profile = profile;
        s_fuel_pid_support = FUEL_PID_SUPPORT_UNKNOWN;
    }

    const obd_vehicle_composition_t *composition = obd_composition_get_active();
    if (!s_composition_runtime_ready ||
        !composition || composition->mechanical_profile != s_composed_plan.mechanical_profile) {
        // Profile selection can happen while the BLE task is alive. Rebuild
        // before the next request so old rules cannot leak into the new car.
        if (!init_composition_runtime()) return false;
    }

    if (slot_id == 6) {
        s_pending_oil_query = true;
        s_pending_oil_value_handled = false;
        if (s_oil_use_override) {
            const oil_formula_t *formula = s_oil_override_idx == 0
                                               ? s_oil_formula_pri
                                               : s_oil_formula_sec;
            s_oil_active_fallback_rank = s_oil_override_idx;
            s_oil_active_mode = formula ?
                ((formula->type == OIL_SPECIAL) ? OIL_TEMP_MODE_TOYOTA_21_01 :
                 (formula->type == OIL_STD_PID) ? OIL_TEMP_MODE_PID_5C :
                 (formula->pid[0] == 0x13 && formula->pid[1] == 0x10) ? OIL_TEMP_MODE_MAZDA_22_1310 :
                 (formula->pid[0] == 0x11 && formula->pid[1] == 0x1F) ? OIL_TEMP_MODE_MAZDA_22_111F :
                 (formula->pid[0] == 0x58 && formula->pid[1] == 0x22) ? OIL_TEMP_MODE_MINI_22_5822 :
                 (formula->pid[0] == 0x44 && formula->pid[1] == 0x02 && formula->resp_bytes == 2) ? OIL_TEMP_MODE_BMW_G_22_4402 :
                 (formula->pid[0] == 0x44 && formula->pid[1] == 0x02) ? OIL_TEMP_MODE_BMW_22_4402 :
                 (formula->pid[0] == 0xD0 && formula->pid[1] == 0x02) ? OIL_TEMP_MODE_BMW_22_D002 :
                 (formula->pid[0] == 0x03 && formula->pid[1] == 0xF3) ? OIL_TEMP_MODE_BMW_22_03F3 :
                 (formula->pid[0] == 0x10 && formula->pid[1] == 0x17) ? OIL_TEMP_MODE_UDS_22_10_17 :
                 OIL_TEMP_MODE_BMW_22_111F)
                : OIL_TEMP_MODE_PID_5C;
        } else {
            uint8_t poll_idx = 0;
            s_oil_active_mode = get_next_oil_query_mode(&poll_idx);
            s_oil_query_mode = poll_idx;
            s_oil_active_fallback_rank = 0;
            for (uint8_t rank = 0; rank < 4; ++rank) {
                if (s_oil_mode_priority[rank] == s_oil_active_mode) {
                    s_oil_active_fallback_rank = rank;
                    break;
                }
            }
        }
        slot = obd_request_plan_find_fallback(&s_request_plan, slot_id,
                                              s_oil_active_fallback_rank);
    } else {
        s_pending_oil_query = false;
        slot = obd_request_plan_find(&s_request_plan, slot_id);
    }
    if (!slot || !slot->rule) {
        s_pending_oil_query = false;
        return true; // plan intentionally has no request for this slot
    }
    rule = slot->rule;

    if (slot_id == 3 && profile && profile->can_broadcast_mode &&
        can_rules_have_channel(override, CH_COOLANT)) return true;
    if (slot_id == 5 && profile && profile->can_broadcast_mode &&
        can_rules_have_channel(override, CH_TPS)) return true;
    if (slot_id == 6 && profile && profile->can_broadcast_mode &&
        can_rules_have_channel(override, CH_OIL_TEMP)) {
        s_pending_oil_query = false;
        return true;
    }
    if (rule->channel == CH_MAP_KPA && (!profile || !profile->has_boost)) return true;
    if (rule->channel == CH_FUEL_PCT && rule->protocol == OBD_PROTOCOL_STANDARD) {
        if (s_fuel_pid_support == FUEL_PID_SUPPORT_UNKNOWN) {
            s_fuel_pid_support = FUEL_PID_SUPPORT_PROBING;
            if (!elm327_ble_send_ascii_blocking("01 20\r")) {
                s_fuel_pid_support = FUEL_PID_SUPPORT_UNAVAILABLE;
                return false;
            }
            return true;
        }
        if (s_fuel_pid_support != FUEL_PID_SUPPORT_AVAILABLE) return true;
    }

    const char *fixed_header = get_vehicle_fixed_header_cmd();
    bool sent = true;
    bool special_raw_gear = obd_special_bmw_is_raw_gear(rule, override);
    bool special_raw_gear_started = false;
    s_pending_response_header = rule->header;
    s_pending_adapter_voltage = false;
    bool switched_header = rule->header && rule->header[0] != '\0' &&
                           strcmp(rule->header, fixed_header) != 0;
    if (switched_header)
        sent = elm327_ble_send_ascii_blocking(rule->header);

    if (sent && special_raw_gear) {
        special_raw_gear_started = true;
        sent = obd_special_bmw_send_raw_gear(override, fixed_header,
                                             send_special_command, NULL);
    } else if (sent) {
        char command[32];
        if (!obd_protocol_build_request(slot->protocol, rule, command, sizeof(command))) {
            sent = false;
        } else {
            sent = elm327_ble_send_ascii_blocking(command);
        }
    }
    // The special BMW script restores the default header itself. Normal
    // requests need the same paired header restoration here.
    if (switched_header && !special_raw_gear_started &&
        !elm327_ble_send_ascii_blocking(fixed_header)) sent = false;
    if (!sent) {
        if (slot_id == 6) record_oil_query_failure();
        s_pending_response_header = NULL;
        s_pending_adapter_voltage = false;
        s_pending_oil_query = false;
        s_pending_oil_value_handled = false;
        s_expect_mode21 = false;
        return false;
    }
    s_expect_mode21 = rule->kind == OBD_RULE_MODE21;
    return true;
}

// Initialize the oil-temp query strategy (reads the primary/secondary/tertiary priority chain from the vehicle profile config)
static void init_oil_temp_strategy(void) {
    // Take the profile's full priority chain: after the primary fails consecutively (threshold times), fall back to secondary, tertiary.
    const oil_temp_strategy_t *st = vehicle_profile_get_oil_temp_strategy();
    s_oil_mode_priority[0] = st ? st->primary    : OIL_TEMP_MODE_PID_5C;
    s_oil_mode_priority[1] = st ? st->secondary  : OIL_TEMP_MODE_NONE;
    s_oil_mode_priority[2] = st ? st->tertiary   : OIL_TEMP_MODE_NONE;
    s_oil_mode_priority[3] = st ? st->quaternary : OIL_TEMP_MODE_NONE;

    // ---- Data-driven override init ----
    s_ov = vehicle_profile_get_override();
    s_oil_formula_pri = s_ov ? s_ov->oil_primary : NULL;
    s_oil_formula_sec = s_ov ? s_ov->oil_secondary : NULL;
    s_oil_use_override = (s_oil_formula_pri != NULL);
    s_oil_override_idx = 0;
    s_oil_override_fail = 0;
    s_oil_active_mode = s_oil_mode_priority[0];
    s_oil_active_fallback_rank = 0;

    const vehicle_profile_t *profile = vehicle_profile_get_active();
    obd_mode21_handler_init(&s_mode21_handler_context,
                            profile && strncmp(profile->name, "ZN/C6", 5) == 0);

    // Reset failure counts
    memset(s_oil_mode_fail_count, 0, sizeof(s_oil_mode_fail_count));
    s_oil_query_mode = 0;
    s_vehicle_profile_inited = true;

    const obd_vehicle_composition_t *composition = obd_composition_get_active();
    if (init_composition_runtime()) {
        ESP_LOGD(TAG, "Composition '%s': protocols=%u packs=%u rules=%u (declarative path active)",
                 composition->name ? composition->name : "UNKNOWN",
                 composition->protocol_count, composition->rule_pack_count,
                 s_composed_plan.rule_count);
    }
    ESP_LOGD(TAG, "Oil temp strategy for [%s]: Primary=%d",
             profile ? profile->name : "UNKNOWN", s_oil_mode_priority[0]);
}

// Select the next query mode based on the current strategy
static oil_temp_query_mode_t get_next_oil_query_mode(uint8_t *poll_idx) {
    if (!s_vehicle_profile_inited) {
        init_oil_temp_strategy();
    }
    
    // Walk the priority list and find the first valid mode that hasn't failed too much
    for (int i = 0; i < 4; i++) {
        oil_temp_query_mode_t mode = s_oil_mode_priority[i];
        if (mode == OIL_TEMP_MODE_NONE) continue;
        
        uint8_t idx = oil_mode_to_poll_idx(mode);
        // Use this mode if its failure count is below the threshold
        if (s_oil_mode_fail_count[idx] < OIL_MODE_FAIL_THRESHOLD) {
            *poll_idx = idx;
            return mode;
        }
    }
    
    // All modes have failed too much; reset failure counts and use the primary mode
    memset(s_oil_mode_fail_count, 0, sizeof(s_oil_mode_fail_count));
    *poll_idx = oil_mode_to_poll_idx(s_oil_mode_priority[0]);
    return s_oil_mode_priority[0];
}

// Record oil-temp query success/failure (internal use)
static void record_oil_temp_success(oil_temp_query_mode_t mode) {
    uint8_t idx = oil_mode_to_poll_idx(mode);
    s_oil_mode_fail_count[idx] = 0;  // success, clear the failure count

    // Update diagnostic stats
    switch (mode) {
        case OIL_TEMP_MODE_PID_5C:
            s_oil_diag.mode0_ok++;
            break;
        case OIL_TEMP_MODE_UDS_22_10_17:
            s_oil_diag.mode1_ok++;
            break;
        case OIL_TEMP_MODE_TOYOTA_21_01:
            s_oil_diag.mode2_ok++;
            break;
        case OIL_TEMP_MODE_MAZDA_22_111F:
            s_oil_diag.mode3_ok++;
            break;
        case OIL_TEMP_MODE_MAZDA_22_1310:
            s_oil_diag.mode4_ok++;
            break;
        case OIL_TEMP_MODE_MINI_22_5822:
            s_oil_diag.mode6_ok++;
            break;
        case OIL_TEMP_MODE_BMW_22_4402:
            s_oil_diag.mode7_ok++;
            break;
        case OIL_TEMP_MODE_BMW_22_03F3:
            s_oil_diag.mode8_ok++;
            break;
        case OIL_TEMP_MODE_BMW_G_22_4402:
            s_oil_diag.mode9_ok++;
            break;
        case OIL_TEMP_MODE_BMW_22_D002:
            s_oil_diag.mode10_ok++;
            break;
        case OIL_TEMP_MODE_BMW_22_111F:
            s_oil_diag.mode11_ok++;
            break;
        default:
            break;
    }
}

static void record_oil_temp_failure(oil_temp_query_mode_t mode) {
    uint8_t idx = oil_mode_to_poll_idx(mode);
    s_oil_mode_fail_count[idx]++;

    // Update diagnostic stats
    switch (mode) {
        case OIL_TEMP_MODE_PID_5C:
            s_oil_diag.mode0_fail++;
            break;
        case OIL_TEMP_MODE_UDS_22_10_17:
            s_oil_diag.mode1_fail++;
            break;
        case OIL_TEMP_MODE_TOYOTA_21_01:
            s_oil_diag.mode2_fail++;
            break;
        case OIL_TEMP_MODE_MAZDA_22_111F:
            s_oil_diag.mode3_fail++;
            break;
        case OIL_TEMP_MODE_MAZDA_22_1310:
            s_oil_diag.mode4_fail++;
            break;
        case OIL_TEMP_MODE_MINI_22_5822:
            s_oil_diag.mode6_fail++;
            break;
        case OIL_TEMP_MODE_BMW_22_4402:
            s_oil_diag.mode7_fail++;
            break;
        case OIL_TEMP_MODE_BMW_22_03F3:
            s_oil_diag.mode8_fail++;
            break;
        case OIL_TEMP_MODE_BMW_G_22_4402:
            s_oil_diag.mode9_fail++;
            break;
        case OIL_TEMP_MODE_BMW_22_D002:
            s_oil_diag.mode10_fail++;
            break;
        case OIL_TEMP_MODE_BMW_22_111F:
            s_oil_diag.mode11_fail++;
            break;
        default:
            break;
    }
}

static void record_oil_query_failure(void)
{
    record_oil_temp_failure(s_oil_active_mode);
    if (s_oil_use_override && s_oil_override_idx == 0 && s_oil_formula_sec &&
        ++s_oil_override_fail >= OIL_OVERRIDE_FAIL_MAX) {
        s_oil_override_idx = 1;
        s_oil_override_fail = 0;
        ESP_LOGW(TAG, "[Override] primary failed %d times, switch to secondary",
                 OIL_OVERRIDE_FAIL_MAX);
    }
}

// Default callbacks and poll task (optional)
static void default_on_connected(void) { ESP_LOGD(TAG, "OBD BLE connected"); }
static void default_on_disconnected(void) { ESP_LOGD(TAG, "OBD BLE disconnected"); }
static void default_on_raw_notify(const uint8_t *data, size_t len) {
    // Receiving '>' means the ELM is ready; the next command can be sent
    // xTaskNotify wakes the poll task immediately, avoiding the 10ms polling overhead
    for (size_t i = 0; i < len; ++i) {
        if (data[i] == '>') {
            s_elm_ready = true;
            if (s_poll_task_handle) xTaskNotify(s_poll_task_handle, 0, eNoAction);
            break;
        }
    }
}

// ---- Protocol auto-detection ----
// Try all protocols (1-11); send 01 0C (read RPM) to check whether the protocol is valid
static int elm327_auto_detect_protocol(void) {
    ESP_LOGD(TAG, "=== Starting protocol auto-detect ===");

    // Send generic init commands first (no protocol selection involved)
    const char *init_cmds[] = {
        "ATZ\r",        // reset
        "ATE0\r",       // Echo off
        "ATAT1\r",      // adaptive timing
        "ATST 19\r",    // set timeout
    };

    for (size_t i = 0; i < sizeof(init_cmds) / sizeof(init_cmds[0]); ++i) {
        if (!s_connected) { ESP_LOGW(TAG, "[DETECT] BLE disconnected, aborting"); s_protocol_detect_idx = -1; return 0; }
        elm327_ble_send_ascii_blocking(init_cmds[i]);
        vTaskDelay(pdMS_TO_TICKS(30));
    }

    vTaskDelay(pdMS_TO_TICKS(200));

    // Try protocols 1-11
    for (int proto = 1; proto <= 11; proto++) {
        // Abort immediately on BLE disconnect — without this check, a disconnect mid-detect
        // would blindly cycle 11 protocols × 2s = up to 22s without feeding the watchdog → TWDT reboot.
        if (!s_connected) { ESP_LOGW(TAG, "[DETECT] BLE disconnected, aborting"); s_protocol_detect_idx = -1; return 0; }
        esp_task_wdt_reset();  // feed watchdog between protocols (the 2s wait below also feeds)
        ESP_LOGD(TAG, "[DETECT] Trying protocol %d...", proto);

        // Set the protocol
        char atsp_cmd[16];
        snprintf(atsp_cmd, sizeof(atsp_cmd), "ATSP%d\r", proto);
        elm327_ble_send_ascii_blocking(atsp_cmd);
        vTaskDelay(pdMS_TO_TICKS(50));

        // Init detection state
        s_protocol_detect_idx = proto;
        s_protocol_detect_got_response = false;
        s_protocol_detect_rpm = -1;

        // Send test command 01 0C (read RPM)
        elm327_ble_send_ascii_blocking("01 0C\r");
        esp_log_level_t prev_level = esp_log_level_get(TAG);
        esp_log_level_set(TAG, ESP_LOG_INFO);
        ESP_LOGD(TAG, "[DETECT] Sent 01 0C, waiting...");
        esp_log_level_set(TAG, prev_level);

        // Wait for a response, up to 2 seconds
        uint32_t wait_ms = 0;
        while (wait_ms < 2000) {
            if (!s_connected) { ESP_LOGW(TAG, "[DETECT] BLE disconnected, aborting"); s_protocol_detect_idx = -1; return 0; }
            esp_task_wdt_reset();  // feed the watchdog in the 2s wait loop (11 protocols × 2s could otherwise exceed TWDT)
            vTaskDelay(pdMS_TO_TICKS(50));
            wait_ms += 50;

            if (s_protocol_detect_got_response) {
                // Success!
                s_protocol_detect_idx = -1;  // exit detection mode
                ESP_LOGD(TAG, "[DETECT] Protocol %d: SUCCESS! (RPM=%ld)", proto, s_protocol_detect_rpm);
                return proto;
            }
        }

        ESP_LOGW(TAG, "[DETECT] Protocol %d: No valid response (timeout)", proto);
    }

    s_protocol_detect_idx = -1;  // exit detection mode
    ESP_LOGW(TAG, "=== Protocol auto-detect FAILED ===");
    return 0;  // 0 means detection failed; the default protocol 6 will be used
}

static void default_on_parsed_rpm(uint16_t rpm) { obd_data_set_rpm(rpm); }
static void default_on_parsed_speed(uint8_t kmh) {
    const vehicle_profile_t *p = vehicle_profile_get_active();
    float sc = (p && p->speed_scale > 0.0f) ? p->speed_scale : 1.0f;
    int32_t v = (int32_t)((float)kmh * sc + 0.5f);
    if (v > 255) v = 255;
    if (p && p->can_broadcast_mode && obd_data_get_rpm() < 800)
        v = 0;
    if (v <= 2) v = 0;
    obd_data_set_speed((uint8_t)v);
}
static void default_on_parsed_coolant_temp(uint32_t coolant_temp) {
    const vehicle_profile_t *profile = vehicle_profile_get_active();
    const vehicle_override_t *ov = vehicle_profile_get_override();
    if (profile && profile->can_broadcast_mode && can_rules_have_channel(ov, CH_COOLANT)) {
        s_can_coolant_last_us = esp_timer_get_time();
    }
    obd_data_set_coolant_temp((int16_t)coolant_temp);
}
static void default_on_parsed_intake_temp(uint32_t intake_temp) { obd_data_set_intake_temp((int16_t)intake_temp); }

// Inline helper: apply the oil-temp offset before storing
static inline void obd_data_set_oil_temp_with_offset(int16_t temp) {
    int16_t adjusted = temp + s_oil_temp_offset;
    if (adjusted < -20) adjusted = -20;
    if (adjusted > 150) adjusted = 150;
    obd_data_set_oil_temp(adjusted);
}

// float → int16_t rounding (safe for positive values; negative-value precision is a non-issue in the oil-temp range)
static inline int16_t oil_f2i(float f) { return (int16_t)(f + 0.5f); }

static void default_on_parsed_oil_temp(uint32_t oil_temp)
{
    static float s_oil_filtered = -100.0f;
    static int16_t s_oil_pending = -100;
    static uint8_t s_oil_pending_cnt = 0;
    const vehicle_profile_t *profile = vehicle_profile_get_active();
    const vehicle_override_t *ov = vehicle_profile_get_override();
    bool can_direct_oil = profile && profile->can_broadcast_mode &&
                          can_rules_have_channel(ov, CH_OIL_TEMP);

    int16_t in = (int16_t)oil_temp;
    s_oil_diag.last_raw_temp = in;

    if (in < -20 || in > 150) return;
    if (s_pending_oil_query) s_pending_oil_value_handled = true;

    if (can_direct_oil) {
        s_can_oil_last_us = esp_timer_get_time();
        s_oil_filtered = (float)in;
        s_oil_pending = in;
        s_oil_pending_cnt = 0;
        s_oil_diag.last_filtered_temp = in;
        obd_data_set_oil_temp_with_offset(in);
        return;
    }

    if (s_oil_filtered <= -40.0f) {
        s_oil_filtered = (float)in;
        s_oil_pending = in;
        s_oil_pending_cnt = 1;
        s_oil_diag.last_filtered_temp = in;
        obd_data_set_oil_temp_with_offset(in);
        return;
    }

    float fdiff = s_oil_filtered - (float)in;
    int diff = (int)(fdiff >= 0 ? fdiff : -fdiff);

    if (diff <= 5) {
        s_oil_pending = -100;
        s_oil_pending_cnt = 0;
        s_oil_filtered = 0.65f * s_oil_filtered + 0.35f * (float)in;
        int16_t disp = oil_f2i(s_oil_filtered);
        s_oil_diag.last_filtered_temp = disp;
        obd_data_set_oil_temp_with_offset(disp);
        return;
    }

    if (diff <= 15) {
        if (s_oil_pending == in) {
            s_oil_pending_cnt++;
        } else {
            s_oil_pending = in;
            s_oil_pending_cnt = 1;
            return;
        }
        if (s_oil_pending_cnt >= 4) {
            s_oil_filtered = 0.5f * s_oil_filtered + 0.5f * (float)in;
            s_oil_pending = -100;
            s_oil_pending_cnt = 0;
            int16_t disp = oil_f2i(s_oil_filtered);
            s_oil_diag.last_filtered_temp = disp;
            obd_data_set_oil_temp_with_offset(disp);
        }
        return;
    }

    if (diff >= 20) {
        if (s_oil_pending == in) {
            s_oil_pending_cnt++;
        } else {
            s_oil_pending = in;
            s_oil_pending_cnt = 1;
            return;
        }
        if (s_oil_pending_cnt >= 3) {
            s_oil_filtered = (float)in;
            s_oil_pending = -100;
            s_oil_pending_cnt = 0;
            s_oil_diag.last_filtered_temp = in;
            obd_data_set_oil_temp_with_offset(in);
        }
    }
}
static void default_on_parsed_load_pct(uint32_t load_pct) { obd_data_set_load_pct((int16_t)load_pct); }
static void default_on_parsed_control_module_voltage(uint32_t bat_mv) { obd_data_set_bat_mv((int32_t)bat_mv); }
static void default_on_parsed_fuel_level(uint32_t fuel_pct) { obd_data_set_fuel_pct((int16_t)fuel_pct); }
static void default_on_parsed_throttle_position(uint32_t tps_pct) { obd_data_set_tps((int16_t)tps_pct); }
static void default_on_parsed_gear(int8_t gear) {
    // Direct gear decode when available, raw value -> UI gear:
    //   3→R, 4→N, 5→1, 6→2, …  (0-2 reserved/Park etc.)
    if (gear == 3) {
        obd_data_set_gear(-1);  // R
    } else if (gear == 4) {
        obd_data_set_gear(GEAR_NEUTRAL);  // N/P
    } else if (gear >= 5 && gear <= 12) {
        obd_data_set_gear((int8_t)(gear - 4));  // 5→1, 6→2, ...
    } else {
        obd_data_set_gear(127);  // invalid/unknown
    }
}
// MAP(kPa) → turbo gauge pressure (0.1bar): gauge = (MAP - atmospheric ≈100kPa), 10kPa = 0.1bar
static void default_on_parsed_manifold_pressure(uint32_t map_kpa) {
    int16_t boost_x10 = (int16_t)(((int32_t)map_kpa - 100) / 10);
    if (boost_x10 < 0) boost_x10 = 0; // don't display negative pressure (vacuum), floor at 0
    obd_data_set_boost_x10(boost_x10);
}

static void can_expire_stale_temp_channels(void)
{
    const vehicle_profile_t *profile = vehicle_profile_get_active();
    const vehicle_override_t *ov = vehicle_profile_get_override();
    int64_t now_us;

    if (!profile || !profile->can_broadcast_mode || !ov || !ov->can_rules || ov->can_rule_count == 0) {
        return;
    }

    now_us = esp_timer_get_time();

    if (can_rules_have_channel(ov, CH_OIL_TEMP) && s_can_oil_last_us > 0 &&
        (now_us - s_can_oil_last_us) > ZC6_CAN_TEMP_STALE_US) {
        obd_data_set_oil_temp_invalid();
        s_oil_diag.last_raw_temp = -100;
        s_oil_diag.last_filtered_temp = -100;
        s_can_oil_last_us = 0;
    }

    if (can_rules_have_channel(ov, CH_COOLANT) && s_can_coolant_last_us > 0 &&
        (now_us - s_can_coolant_last_us) > ZC6_CAN_TEMP_STALE_US) {
        obd_data_set_coolant_temp_invalid();
        s_can_coolant_last_us = 0;
    }
}

// PID 01 44: Commanded Equivalence Ratio (λ), formula: (A*256+B)/32768, range 0~<2
// λ=1.0 stoichiometric AFR (gasoline ~14.7:1), λ<1 rich, λ>1 lean
// Conversion: AFR = λ × 14.7, stored ×100 (1470 = 14.70:1)
static void default_on_parsed_afr(uint32_t afr_x100) {
    obd_data_set_afr_x100((int16_t)afr_x100);
}
// Mode 22 oil pressure (4436=B58, 586F=N55): absolute hPa → 0.1 bar (x10), setter clamps to [0, 200]
static void default_on_parsed_oil_pressure(uint32_t oil_pressure_hpa) {
    int32_t x10 = (int32_t)oil_pressure_hpa / 100;   // 100 hPa = 0.1 bar
    if (x10 < 0) x10 = 0;
    if (x10 > 200) x10 = 200;
    obd_data_set_oil_pressure_x10((int16_t)x10);
}
// Mode 22 gear (BMW 22 D0 31, ZF 8HP "BMW_GEAR_V2"): 0x00=N, 0x01..0x08=1..8; anything else invalid → ratio-calc fallback
static void default_on_parsed_obd_gear(uint8_t raw_gear) {
    if (raw_gear <= 0x08) {
        obd_data_set_gear((int8_t)raw_gear);   // 0=N, 1..8 = forward gear
    } else {
        obd_data_set_gear(127);                // invalid/unknown (R/P/0xFF) → falls back to the computed gear
    }
}

// ---- CAN continuous monitor: enter/exit/byte-wise feed/line-wise parse ----

static void zc6_can_monitor_enter(void)
{
    const char *const *cmds = s_zc6_can_monitor_enter_cmds_plain;
    size_t cmd_count = sizeof(s_zc6_can_monitor_enter_cmds_plain) / sizeof(s_zc6_can_monitor_enter_cmds_plain[0]);
    s_zc6_can_monitor_active = false;
    s_zc6_can_monitor_len = 0;
    s_zc6_can_monitor_buf[0] = '\0';
    s_zc6_can_monitor_entered_us = 0;
    s_accum_len = 0;
    s_accum_buf[0] = '\0';

    for (size_t i = 0; i < cmd_count; i++) {
        elm327_ble_send_ascii_blocking(cmds[i]);
        vTaskDelay(pdMS_TO_TICKS(i + 1 == cmd_count ? 80 : 30));
    }
    s_zc6_can_monitor_active = true;
    s_zc6_can_monitor_entered_us = esp_timer_get_time();
}

static void zc6_can_monitor_exit(void)
{
    s_zc6_can_monitor_active = false;
    s_elm_ready = true;
    uint8_t stop = '\r';
    elm327_ble_send_command(&stop, 1);
    vTaskDelay(pdMS_TO_TICKS(80));
    // Restore CAN filtering to the adapter default before normal OBD polling resumes.
    elm327_ble_send_ascii_blocking("ATCRA\r");
    s_accum_len = 0;
    s_accum_buf[0] = '\0';
    // Light restore: clear filter + headers off, no full ATZ reset (saves ~500ms)
    elm327_ble_send_ascii_blocking("AT AR\r");
    elm327_ble_send_ascii_blocking("AT H0\r");
}

static void zc6_can_monitor_probe_window(uint32_t window_ms)
{
    if (window_ms == 0) return;
    zc6_can_monitor_enter();
    vTaskDelay(pdMS_TO_TICKS(window_ms));
    zc6_can_monitor_exit();
}

static bool can_monitor_parse_hex_token(const char **cursor, uint32_t *value_out)
{
    const char *p = (cursor != NULL) ? *cursor : NULL;
    uint32_t value = 0;
    bool saw_digit = false;

    if (!p || !value_out) return false;

    if (p[0] == '0' && (p[1] == 'x' || p[1] == 'X')) {
        p += 2;
    }

    while (*p && isxdigit((unsigned char)*p)) {
        uint8_t nibble;
        if (*p >= '0' && *p <= '9') {
            nibble = (uint8_t)(*p - '0');
        } else if (*p >= 'A' && *p <= 'F') {
            nibble = (uint8_t)(*p - 'A' + 10);
        } else {
            nibble = (uint8_t)(*p - 'a' + 10);
        }
        value = (value << 4) | nibble;
        saw_digit = true;
        ++p;
    }

    if (!saw_digit) return false;
    *cursor = p;
    *value_out = value;
    return true;
}

static bool can_monitor_parse_line_fast(const char *line, uint16_t *can_id_out,
                                        uint8_t data[8], uint8_t *data_len_out)
{
    const char *p = line;
    uint32_t token = 0;
    uint32_t tokens[9] = {0};
    uint8_t count = 0;
    uint8_t start = 0;

    if (!line || !can_id_out || !data || !data_len_out) return false;

    while (*p && !isxdigit((unsigned char)*p)) {
        if (*p == '>' || *p == '\r' || *p == '\n') return false;
        ++p;
    }

    if (!can_monitor_parse_hex_token(&p, &token)) return false;
    if (*p == ':' && token <= 0xFFu) {
        ++p;
        while (*p && !isxdigit((unsigned char)*p)) {
            if (*p == '>' || *p == '\r' || *p == '\n') return false;
            ++p;
        }
        if (!can_monitor_parse_hex_token(&p, &token)) return false;
    }
    if (token > 0x7FFu) return false;
    *can_id_out = (uint16_t)token;

    while (*p && count < 9) {
        while (*p && !isxdigit((unsigned char)*p)) {
            if (*p == '>' || *p == '\r' || *p == '\n') goto out;
            ++p;
        }
        if (!*p) break;

        if (!can_monitor_parse_hex_token(&p, &token) || token > 0xFFu) return false;
        tokens[count++] = token;
    }

    if (count == 9 && tokens[0] <= 8u) {
        start = 1;
    }
    for (uint8_t i = start; i < count && (i - start) < 8; ++i) {
        data[i - start] = (uint8_t)tokens[i];
    }

out:
    *data_len_out = (uint8_t)(count - start);
    return *data_len_out > 0;
}

static bool can_rules_have_channel(const vehicle_override_t *ov, uint8_t channel)
{
    if (!ov || !ov->can_rules || ov->can_rule_count == 0) return false;
    for (uint8_t i = 0; i < ov->can_rule_count; ++i) {
        if (ov->can_rules[i].channel == channel) return true;
    }
    return false;
}

// Line-wise parse: generic rule tables; skipped automatically if the frame is not on the bus
static bool zc6_can_monitor_parse_line(const char *line)
{
    // Generic CAN frame parse: extract CAN ID + data from the ATMA line and apply the override rules
    const vehicle_override_t *ov = vehicle_profile_get_override();
    if (!ov || !ov->can_rules || ov->can_rule_count == 0) {
        return false;
    }

    // The composed CAN module is authoritative for declarative rules. Keep
    // the legacy parser below for profiles/rules that are not yet migrated.
    if (s_composition_runtime_ready) {
        const obd_protocol_module_t *module =
            obd_protocol_get(OBD_PROTOCOL_CAN_MONITOR);
        obd_text_response_context_t text_context = {
            .dispatcher = &s_response_dispatcher,
            .header = NULL,
        };
        if (module && module->parse_response &&
            module->parse_response(&text_context, line)) {
            mark_obd_data_valid();
            return true;
        }
    }

    // Parse the CAN ID and payload once. Most adapters emit a plain "<ID> <D0> <D1> ..." monitor line;
    // the fast path handles that without `sscanf`, and the slow path below keeps compatibility with odd adapters.
    uint16_t line_id = 0;
    uint8_t data[8] = {0};
    uint8_t data_len = 0;
    bool parsed_fast = can_monitor_parse_line_fast(line, &line_id, data, &data_len);

    bool id_watched = false;
    for (uint8_t i = 0; i < ov->can_rule_count; i++) {
        if (ov->can_rules[i].can_id == line_id) { id_watched = true; break; }
    }
    if (!id_watched) return false;

    if (!parsed_fast) {
        int vals = sscanf(line, "%hx %hhx %hhx %hhx %hhx %hhx %hhx %hhx %hhx",
                          &line_id,
                          &data[0],&data[1],&data[2],&data[3],
                          &data[4],&data[5],&data[6],&data[7]);
        if (vals < 2 || line_id == 0) return false;
        data_len = (uint8_t)(vals - 1);
    }

    if (s_composition_runtime_ready &&
        obd_response_dispatch_can(&s_response_dispatcher, line_id, data,
                                  data_len, NULL)) {
        mark_obd_data_valid();
        return true;
    }

    float channels[CH_COUNT];
    for (int c = 0; c < CH_COUNT; c++) channels[c] = -32768.0f;
    can_apply_rules(ov->can_rules, ov->can_rule_count, line_id, data, channels);

    if (channels[CH_RPM] >= 0 && s_cbs.on_parsed_rpm)
        s_cbs.on_parsed_rpm((uint16_t)channels[CH_RPM]);
    if (channels[CH_SPEED] >= 0 && s_cbs.on_parsed_speed_kmh)
        s_cbs.on_parsed_speed_kmh((uint8_t)channels[CH_SPEED]);
    if (channels[CH_OIL_TEMP] > -40 && channels[CH_OIL_TEMP] <= 215 && s_cbs.on_parsed_oil_temp)
        s_cbs.on_parsed_oil_temp((uint32_t)(int16_t)channels[CH_OIL_TEMP]);
    if (channels[CH_COOLANT] > -40 && channels[CH_COOLANT] <= 215 && s_cbs.on_parsed_coolant_temp)
        s_cbs.on_parsed_coolant_temp((uint32_t)(int16_t)channels[CH_COOLANT]);
    if (channels[CH_TPS] >= 0 && s_cbs.on_parsed_throttle_position)
        s_cbs.on_parsed_throttle_position((uint32_t)channels[CH_TPS]);
    if (channels[CH_GEAR] > 0 && channels[CH_GEAR] < 127 && s_cbs.on_parsed_gear)
        s_cbs.on_parsed_gear((int8_t)channels[CH_GEAR]);

    mark_obd_data_valid();
    return true;
}

// Byte-wise feed: split into lines on \r\n and call parse_line for each line
static void zc6_can_monitor_feed(const uint8_t *data, size_t len)
{
    for (size_t i = 0; i < len; i++) {
        char ch = (char)data[i];
        if (ch == '>') { s_elm_ready = true; continue; }
        if (ch == '\r' || ch == '\n') {
            if (s_zc6_can_monitor_len > 0) {
                s_zc6_can_monitor_buf[s_zc6_can_monitor_len] = '\0';
                zc6_can_monitor_parse_line(s_zc6_can_monitor_buf);
                s_zc6_can_monitor_len = 0;
            }
            continue;
        }
        if ((unsigned char)ch < 0x20 || (unsigned char)ch > 0x7E) continue;
        if (s_zc6_can_monitor_len + 1 >= ZC6_CAN_MONITOR_BUF_SIZE)
            s_zc6_can_monitor_len = 0;
        s_zc6_can_monitor_buf[s_zc6_can_monitor_len++] = ch;
    }
}

// ELM327 init sequence (protocol selection + AT config + bus warm-up + oil-temp strategy).
// Called on every (re)connect and only after the notify subscription is ready, so handshake responses aren't lost before subscribing.
static void do_elm_init(void) {
    char atsp_cmd[16];
    nvs_user_cfg_t cfg_snapshot = {0};
    nvs_cfg_get_snapshot(&cfg_snapshot);
    const nvs_user_cfg_t *cfg = &cfg_snapshot;

    // ---- Protocol selection ----
    uint8_t protocol_to_use = cfg->protocol;
    // Vehicle-forced protocol takes priority (some ECUs/adapters are unstable with auto-detect; skip detection when a profile sets one)
    const vehicle_profile_t *vp_proto = vehicle_profile_get_active();
    if (vp_proto && vp_proto->forced_protocol != 0) {
        protocol_to_use = vp_proto->forced_protocol;
        ESP_LOGD(TAG, "Vehicle '%s' forces protocol %d (skip auto-detect)", vp_proto->name, protocol_to_use);
    } else if (protocol_to_use == 0) {
        // Auto protocol detection — abort immediately if BLE dropped during detection
        ESP_LOGD(TAG, "Protocol auto-detect enabled (current NVS: 0-auto)");
        int detected_proto = elm327_auto_detect_protocol();
        if (!s_connected) {
            ESP_LOGW(TAG, "BLE disconnected during protocol auto-detect, aborting init");
            return;
        }
        if (detected_proto > 0) {
            protocol_to_use = (uint8_t)detected_proto;
            nvs_user_cfg_t new_cfg = *cfg;
            new_cfg.protocol = protocol_to_use;
            nvs_cfg_set(&new_cfg);
            ESP_LOGD(TAG, "Protocol auto-detect SUCCESS! Saving protocol %d to NVS", protocol_to_use);
        } else {
            protocol_to_use = 6;
            ESP_LOGW(TAG, "Protocol auto-detect FAILED, using fallback protocol 6");
        }
    }

    snprintf(atsp_cmd, sizeof(atsp_cmd), "ATSP%d\r", protocol_to_use);
    const char *fixed_header_cmd = get_vehicle_fixed_header_cmd();
    // Timeout command: prefer the override's obd_timeout first, then the profile's obd_timeout, default 0x19
    const vehicle_override_t *vp_ov = vehicle_profile_get_override();
    char atst_cmd[12];
    uint8_t timeout_val = (vp_ov && vp_ov->obd_timeout) ? vp_ov->obd_timeout
                          : ((vp_proto && vp_proto->obd_timeout) ? vp_proto->obd_timeout : 0x19);
    snprintf(atst_cmd, sizeof(atst_cmd), "ATST %02X\r", timeout_val);
    const char *init_cmds[] = {
        "ATZ\r", "ATE0\r", "ATL0\r", "ATS1\r", "ATH0\r", "ATAT1\r", atst_cmd,
        atsp_cmd, fixed_header_cmd,
    };
    for (size_t i = 0; i < (sizeof(init_cmds) / sizeof(init_cmds[0])); ++i) {
        if (!s_connected) { ESP_LOGW(TAG, "BLE disconnected during ELM init seq, aborting"); return; }
        elm327_ble_send_ascii_blocking(init_cmds[i]);
        vTaskDelay(pdMS_TO_TICKS(30));
    }
    // Bus warm-up: send 01 00 a few extra times to give the vehicle CAN/ELM protocol time to handshake (the bus may not be awake on a cold start)
    for (int probe = 0; probe < 3; ++probe) {
        if (!s_connected) { ESP_LOGW(TAG, "BLE disconnected during bus warm-up, aborting"); return; }
        elm327_ble_send_ascii_blocking("01 00\r");
        vTaskDelay(pdMS_TO_TICKS(150));
    }

    // ---- Init the oil-temp query strategy (based on vehicle profile config) ----
    init_oil_temp_strategy();
    obd_data_reset_temp_cache();
    s_fuel_pid_support = FUEL_PID_SUPPORT_UNKNOWN;
    s_fuel_pid_profile = NULL;
    s_zc_can_obd_phase = false;
    s_zc_can_obd_round_started = false;
    s_zc6_can_temp_probe_last_us = 0;
    s_last_obd_valid_us = esp_timer_get_time();   // give a fresh "valid data" baseline so self-heal doesn't trigger right after init
}

static void process_rx_queue(void)
{
    if (!s_rx_queue) return;
    obd_rx_item_t item;
    unsigned processed = 0;
    while (processed++ < 4 && xQueueReceive(s_rx_queue, &item, 0) == pdTRUE) {
        esp_ble_gattc_cb_param_t param = {0};
        param.notify.value = item.data;
        param.notify.value_len = item.len;
        s_rx_dispatching = true;
        gattc_event_handler(ESP_GATTC_NOTIFY_EVT, s_gattc_if, &param);
        s_rx_dispatching = false;
        portENTER_CRITICAL(&s_runtime_mux);
        s_runtime_stats.rx_processed++;
        s_runtime_stats.last_rx_us = esp_timer_get_time();
        portEXIT_CRITICAL(&s_runtime_mux);
    }
}

static void obd_manager_task(void *arg) {
    s_poll_task_handle = xTaskGetCurrentTaskHandle();
    esp_task_wdt_add(NULL);  // register with the watchdog
    uint32_t tick_count = 0;
    TickType_t next_slot_wake = xTaskGetTickCount();
    int64_t last_stats_log_us = 0;
    bool inited = false;
    uint8_t heal_attempts = 0;   // consecutive self-heal count; escalates to a forced reconnect if resending ATZ a few times still yields no data

    // 12-slot poll: 0=RPM, 1=IAT, 2=Speed, 3=CLT, 4=Load(0x04), 5=TPS(0x11), 6=OIL(vehicle strategy), 7=vehicle battery voltage (01 42), 8=Boost, 9=AFR, 10=Oil pressure, 11=Gear
    while (1)
    {
        process_rx_queue();
        // The first twelve slots are the legacy cadence. Opt-in rule packs
        // may append extension slots (for example four Ford TPMS DIDs) while
        // standard-only vehicles keep the exact old cycle length.
        uint8_t poll_slot_count = 12;
        if (s_composition_runtime_ready) {
            for (uint8_t i = 0; i < s_request_plan.slot_count; ++i) {
                uint8_t end = (uint8_t)(s_request_plan.slots[i].slot_id + 1u);
                if (end > poll_slot_count) poll_slot_count = end;
            }
        }
        obd_tpms_cache_expire(esp_timer_get_time(), 4000000);
        esp_task_wdt_reset();  // feed the watchdog
        // Showroom mode: pause OBD polling to avoid overwriting the dummy data
        extern bool ui_showroom_is_active(void);
        if (ui_showroom_is_active()) {
            vTaskDelay(pdMS_TO_TICKS(500));
            continue;
        }
        // WiFi OTA: keep the ELM327 polling quiet so BLE stops competing for the radio.
        if (s_ota_paused) {
            vTaskDelay(pdMS_TO_TICKS(200));
            continue;
        }
        // Not connected or notify subscription not ready → mark for re-init and wait
        if (!s_connected || !s_notify_ready) {
            inited = false;
            vTaskDelay(pdMS_TO_TICKS(300));
            continue;
        }
        // Init only after the notify subscription is ready following a (re)connect; re-runs on every reconnect (fixes "must disconnect/reconnect to get readings")
        if (!inited) {
            vTaskDelay(pdMS_TO_TICKS(300));   // give the subscription a bit more time to settle
            if (!s_connected || !s_notify_ready) continue;  // dropped again while waiting — re-check before init
            do_elm_init();
            // do_elm_init may have aborted early due to disconnect; don't mark inited in that case
            if (!s_connected) continue;
            inited = true;
            tick_count = 0;
            next_slot_wake = xTaskGetTickCount();
            continue;
        }
        // Real valid data is flowing (any frame parsed since the last round) → clear the self-heal counter.
        // Must NOT judge by timestamp: do_elm_init also refreshes the timestamp; if that counted as "data flowing",
        // heal_attempts would be cleared right after every re-init and the "3 consecutive self-heals → forced reconnect" escalation could never run.
        if (s_got_valid_data) {
            s_got_valid_data = false;
            heal_attempts = 0;
        }
        // Self-heal: no valid data for >10s straight (covers no response / SEARCHING / UNABLE TO CONNECT / NO DATA).
        if ((esp_timer_get_time() - s_last_obd_valid_us) > 10000000) {
            s_last_obd_valid_us = esp_timer_get_time();
            heal_attempts++;
            if (heal_attempts >= 3) {
                // Retried ATZ a few times with still no data → force-close BLE; the DISCONNECT callback auto-reconnects,
                // equivalent to automatically doing a "manual disconnect/reconnect" (re-subscribe notify + re-run init; by then the bus is usually awake).
                ESP_LOGW(TAG, "Self-heal escalate: force BLE reconnect (re-init didn't help)");
                heal_attempts = 0;
                inited = false;
                esp_ble_gattc_close(s_gattc_if, s_conn_id);
                vTaskDelay(pdMS_TO_TICKS(300));
                continue;
            }
            ESP_LOGW(TAG, "No valid OBD data >10s, re-init ELM (self-heal #%u)...", heal_attempts);
            inited = false;
            continue;
        }
        // ---- Mixed CAN/OBD mode ----
        //  - OBD-RPM profiles (e.g. ZN/C6 CAN): keep OBD as the main loop and open short ATMA probe windows only
        //    when we need to refresh CAN temps/TPS.
        const vehicle_profile_t *vp_poll = vehicle_profile_get_active();
        const vehicle_override_t *ov_poll = vehicle_profile_get_override();
        bool can_broadcast = vp_poll && vp_poll->can_broadcast_mode;
        bool can_has_rpm = can_rules_have_channel(ov_poll, CH_RPM);
        bool can_has_coolant = can_rules_have_channel(ov_poll, CH_COOLANT);
        bool can_has_tps = can_rules_have_channel(ov_poll, CH_TPS);
        bool can_has_oil = can_rules_have_channel(ov_poll, CH_OIL_TEMP);
        bool can_needs_monitor_probe = can_has_coolant || can_has_tps || can_has_oil;
        bool can_obd_primary = can_broadcast && !can_has_rpm;
        uint32_t can_obd_interval = can_has_rpm ? ZC6_CAN_OBD_INTERVAL : 1;
        uint32_t can_atma_delay_ms = can_has_rpm ? 120u : 30u;
        can_expire_stale_temp_channels();

        if (!can_obd_primary && can_broadcast && !s_zc_can_obd_phase) {
            // ---- ATMA phase: receive CAN broadcast frames ----
            if (!s_zc6_can_monitor_active) {
                zc6_can_monitor_enter();
                s_zc6_can_monitor_obd_cycle = 0;
            }
            // Self-heal
            if (s_zc6_can_monitor_entered_us > 0 &&
                (esp_timer_get_time() - s_last_obd_valid_us) > 10000000) {
                zc6_can_monitor_exit();
                zc6_can_monitor_enter();
                s_zc6_can_monitor_obd_cycle = 0;
                vTaskDelay(pdMS_TO_TICKS(can_atma_delay_ms));
                continue;
            }
            s_zc6_can_monitor_obd_cycle++;
            if (s_zc6_can_monitor_obd_cycle >= can_obd_interval) {
                // Switch to the OBD phase
                zc6_can_monitor_exit();
                s_zc_can_obd_phase = true;
                s_zc_can_obd_round_started = can_has_rpm;
                tick_count = can_has_rpm ? 1 : 0;
            }
            vTaskDelay(pdMS_TO_TICKS(can_atma_delay_ms));
            continue;
        }

        // ---- Standard OBD polling (ZC/N6 CAN's OBD phase, or non-CAN profiles) ----
        // Fully reuses the switch(tick_count) below, identical to regular ZC/N6
        if (!can_obd_primary && can_broadcast && s_zc_can_obd_phase && tick_count == 0) {
            if (!s_zc_can_obd_round_started) {
                s_zc_can_obd_round_started = true;
            } else {
                // One standard OBD round done, return to the ATMA phase
                s_zc_can_obd_phase = false;
                s_zc_can_obd_round_started = false;
                zc6_can_monitor_enter();
                s_zc6_can_monitor_obd_cycle = 0;
                vTaskDelay(pdMS_TO_TICKS(can_atma_delay_ms));
                continue;
            }
        }

        bool completed_obd_round = (tick_count == 11);
        {
        bool composition_handled = send_composed_slot((uint8_t)tick_count);
        if (!composition_handled) switch(tick_count)
        {
            case 0:// Engine RPM
                send_rpm_request("slot0");
                break;
            case 1:// Intake air temp
                elm327_ble_send_ascii_blocking("01 0F\r");
                break;
            case 6: // Auto oil-temp query (based on vehicle strategy) (CAN mode gets it from passive CAN, skip when available)
                if (can_broadcast && can_has_oil) break;
                {
                    const oil_formula_t *oil_f = NULL;
                    if (s_oil_use_override) {
                        oil_f = (s_oil_override_idx == 0) ? s_oil_formula_pri : s_oil_formula_sec;
                    }

                    if (oil_f && oil_f->type != OIL_SPECIAL) {
                        char cmd_buf[24];
                        const char *uds_hdr = (s_ov && s_ov->uds_header_cmd) ? s_ov->uds_header_cmd : NULL;
                        bool need_phys = !uds_hdr && s_ov && s_ov->functional_addr && oil_f->type == OIL_UDS_22;
                        if (uds_hdr) elm327_ble_send_ascii_blocking(uds_hdr);
                        else if (need_phys) elm327_ble_send_ascii_blocking("ATSH7E0\r");
                        if (oil_formula_build_cmd(oil_f, cmd_buf, sizeof(cmd_buf))) {
                            elm327_ble_send_ascii_blocking(cmd_buf);
                        }
                        if (uds_hdr) elm327_ble_send_ascii_blocking(get_vehicle_fixed_header_cmd());
                        else if (need_phys) elm327_ble_send_ascii_blocking("ATSH7DF\r");
                        s_expect_mode21 = false;
                    } else if (oil_f && oil_f->type == OIL_SPECIAL && oil_f->special_id == 0) {
                        elm327_ble_send_ascii_blocking("21 01\r");
                        s_expect_mode21 = true;
                    } else {
                        uint8_t poll_idx = 0;
                        oil_temp_query_mode_t mode = get_next_oil_query_mode(&poll_idx);
                        s_expect_mode21 = (mode == OIL_TEMP_MODE_TOYOTA_21_01);
                        if (mode == OIL_TEMP_MODE_PID_5C)
                            elm327_ble_send_ascii_blocking("01 5C\r");
                        else if (mode == OIL_TEMP_MODE_TOYOTA_21_01)
                            elm327_ble_send_ascii_blocking("21 01\r");
                        else {
                            char cmd_buf[24];
                            oil_formula_t legacy_f = {0};
                            legacy_f.type = OIL_UDS_22;
                            legacy_f.pid_len = 2;
                            switch (mode) {
                                case OIL_TEMP_MODE_UDS_22_10_17: legacy_f.pid[0]=0x10; legacy_f.pid[1]=0x17; break;
                                case OIL_TEMP_MODE_MAZDA_22_111F: legacy_f.pid[0]=0x11; legacy_f.pid[1]=0x1F; break;
                                case OIL_TEMP_MODE_MAZDA_22_1310: legacy_f.pid[0]=0x13; legacy_f.pid[1]=0x10; break;
                                case OIL_TEMP_MODE_MINI_22_5822: legacy_f.pid[0]=0x58; legacy_f.pid[1]=0x22; break;
                                case OIL_TEMP_MODE_BMW_22_4402:
                                case OIL_TEMP_MODE_BMW_G_22_4402: legacy_f.pid[0]=0x44; legacy_f.pid[1]=0x02; break;
                                case OIL_TEMP_MODE_BMW_22_03F3: legacy_f.pid[0]=0x03; legacy_f.pid[1]=0xF3; break;
                                case OIL_TEMP_MODE_BMW_22_D002: legacy_f.pid[0]=0xD0; legacy_f.pid[1]=0x02; break;
                                case OIL_TEMP_MODE_BMW_22_111F: legacy_f.pid[0]=0x11; legacy_f.pid[1]=0x1F; break;
                                default: legacy_f.type = OIL_STD_PID; legacy_f.pid[0]=0x5C; legacy_f.pid_len=1; break;
                            }
                            bool need_phys = (mode == OIL_TEMP_MODE_BMW_22_03F3 ||
                                              mode == OIL_TEMP_MODE_BMW_G_22_4402 ||
                                              mode == OIL_TEMP_MODE_BMW_22_D002 ||
                                              mode == OIL_TEMP_MODE_BMW_22_111F);
                            if (need_phys) elm327_ble_send_ascii_blocking("ATSH7E0\r");
                            if (oil_formula_build_cmd(&legacy_f, cmd_buf, sizeof(cmd_buf)))
                                elm327_ble_send_ascii_blocking(cmd_buf);
                            if (need_phys) elm327_ble_send_ascii_blocking("ATSH7DF\r");
                        }
                        s_oil_query_mode = poll_idx;
                    }
                }
                break;
            case 2:// Vehicle speed
                elm327_ble_send_ascii_blocking("01 0D\r");
                break;
            case 3:// Coolant temp (skip when CAN already provides it)
                if (!(can_broadcast && can_has_coolant)) {
                    elm327_ble_send_ascii_blocking("01 05\r");
                }
                break;
            case 4:// Engine load (0x04, 0~100%)
                elm327_ble_send_ascii_blocking("01 04\r");
                break;
            case 5:// Throttle position TPS (skip when CAN already provides it)
                if (!(can_broadcast && can_has_tps)) {
                    elm327_ble_send_ascii_blocking("01 11\r");
                }
                break;
            case 7:// Battery voltage (0x42)
                elm327_ble_send_ascii_blocking("01 42\r");
                break;
            case 8:// Boost pressure: intake manifold absolute pressure (0x0B, kPa), queried only for turbo profiles
                {
                    const vehicle_profile_t *vp = vehicle_profile_get_active();
                    if (vp && vp->has_boost) {
                        elm327_ble_send_ascii_blocking("01 0B\r");
                    }
                }
                break;
            case 9:// Air-fuel ratio AFR (01 44, Commanded Equivalence Ratio)
                elm327_ble_send_ascii_blocking("01 44\r");
                break;
            case 10:// Engine oil pressure (Mode 22 DID, per-profile: 4436=B58, 586F=N55) — physical header, only for OBD-oil-pressure profiles
                {
                    const vehicle_profile_t *vp = vehicle_profile_get_active();
                    if (vp && vp->obd_oil_pressure_did != 0) {
                        const vehicle_override_t *ov = vehicle_profile_get_override();
                        const char *phys_hdr = (ov && ov->uds_header_cmd) ? ov->uds_header_cmd : "ATSH7E0\r";
                        char cmd[16];
                        elm327_ble_send_ascii_blocking(phys_hdr);
                        snprintf(cmd, sizeof(cmd), "22 %02X %02X\r",
                                 (vp->obd_oil_pressure_did >> 8) & 0xFF, vp->obd_oil_pressure_did & 0xFF);
                        elm327_ble_send_ascii_blocking(cmd);
                        elm327_ble_send_ascii_blocking(get_vehicle_fixed_header_cmd());
                    }
                }
                break;
            case 11:// Transmission gear (Mode 22 DID, per-profile: DA2E=BMW EGS) — only for OBD-gear profiles
                {
                    const vehicle_profile_t *vp = vehicle_profile_get_active();
                    if (vp && vp->obd_gear_did != 0) {
                        const vehicle_override_t *ov = vehicle_profile_get_override();
                        const char *gear_hdr = (ov && ov->obd_gear_header_cmd) ? ov->obd_gear_header_cmd
                                             : ((ov && ov->uds_header_cmd) ? ov->uds_header_cmd : "ATSH7E0\r");
                        const char *rx_filter = ov ? ov->obd_gear_rx_filter_cmd : NULL;
                        const char *raw_frame = ov ? ov->obd_gear_raw_frame : NULL;
                        elm327_ble_send_ascii_blocking(gear_hdr);
                        if (rx_filter) elm327_ble_send_ascii_blocking(rx_filter);
                        if (raw_frame) {
                            // CAF0: ELM327 sends the bytes verbatim (no PCI added) and prints the raw reply,
                            // which still contains "62 HH LL <data>" for the Mode 22 parser.
                            elm327_ble_send_ascii_blocking("ATCAF0\r");
                            elm327_ble_send_ascii_blocking(raw_frame);
                            elm327_ble_send_ascii_blocking("ATCAF1\r");
                        } else {
                            char cmd[16];
                            snprintf(cmd, sizeof(cmd), "22 %02X %02X\r",
                                     (vp->obd_gear_did >> 8) & 0xFF, vp->obd_gear_did & 0xFF);
                            elm327_ble_send_ascii_blocking(cmd);
                        }
                        if (rx_filter) elm327_ble_send_ascii_blocking("ATCRA\r");
                        elm327_ble_send_ascii_blocking(get_vehicle_fixed_header_cmd());
                    }
                }
                break;
            case 12:// Fuel level (0x2F, 0~100%)
                if (s_fuel_pid_support == FUEL_PID_SUPPORT_UNKNOWN) {
                    s_fuel_pid_support = FUEL_PID_SUPPORT_PROBING;
                    if (!elm327_ble_send_ascii_blocking("01 20\r"))
                        s_fuel_pid_support = FUEL_PID_SUPPORT_UNAVAILABLE;
                } else if (s_fuel_pid_support == FUEL_PID_SUPPORT_AVAILABLE) {
                    elm327_ble_send_ascii_blocking("01 2F\r");
                }
                break;
        default:
                break;
        }

        s_runtime_stats.poll_slots++;
        tick_count++;
        if(tick_count >= poll_slot_count)
        {
            tick_count = 0;
            s_runtime_stats.poll_rounds++;
        }
        } // end standard OBD poll block

        if (can_obd_primary && can_needs_monitor_probe && completed_obd_round) {
            int64_t now_us = esp_timer_get_time();
            if (s_zc6_can_temp_probe_last_us == 0 ||
                (now_us - s_zc6_can_temp_probe_last_us) >= ZC6_CAN_TEMP_PROBE_INTERVAL_US) {
                zc6_can_monitor_probe_window(ZC6_CAN_TEMP_PROBE_WINDOW_MS);
                s_zc6_can_temp_probe_last_us = esp_timer_get_time();
            }
        }

        // Inter-slot idle gap: prefer the override's poll_gap_ms first, then the profile's poll_gap_ms (e.g. ZC/N6, MX-5 ND use 1ms); fall back to the global default 30ms.
        // Too small overwhelms cheap BLE adapters; profiles with fast CAN-bus response can safely go smaller.
        // If the user sets poll_gap_ms = 0, skip vTaskDelay and move on directly.
        {
            const vehicle_override_t *ov_gap = vehicle_profile_get_override();
            const vehicle_profile_t *vp_gap = vehicle_profile_get_active();
            uint32_t gap = (ov_gap && ov_gap->poll_gap_ms > 0)
                           ? ov_gap->poll_gap_ms
                           : ((vp_gap && vp_gap->poll_gap_ms > 0)
                              ? vp_gap->poll_gap_ms : OBD_POLL_SLOT_GAP_MS);
            if (gap > 0) vTaskDelayUntil(&next_slot_wake, pdMS_TO_TICKS(gap));
        }

        int64_t stats_now_us = esp_timer_get_time();
        if (stats_now_us - last_stats_log_us >= 10000000LL) {
            elm327_ble_runtime_stats_t stats;
            elm327_ble_get_runtime_stats(&stats);
            ESP_LOGI(TAG, "OBD stats rx=%lu drop=%lu q=%lu/%u poll=%lu/%lu valid=%lu stack=%u prio=%u",
                     (unsigned long)stats.rx_processed,
                     (unsigned long)stats.rx_dropped,
                     (unsigned long)stats.rx_enqueued,
                     (unsigned)stats.queue_high_watermark,
                     (unsigned long)stats.poll_slots,
                     (unsigned long)stats.poll_rounds,
                     (unsigned long)stats.valid_frames,
                     (unsigned)uxTaskGetStackHighWaterMark(NULL),
                     (unsigned)uxTaskPriorityGet(NULL));
            last_stats_log_us = stats_now_us;
        }
    }
}

static void start_scan(void) {
    esp_err_t err = esp_ble_gap_start_scanning(10); // 10s
    if (err != ESP_OK) {
        ESP_LOGW(TAG, "Auto scan start failed: %s", esp_err_to_name(err));
        s_connection_failed = true;
    }
}

static bool match_device_target(const esp_ble_gap_cb_param_t *pr, const char *target_name,
                                char *found_name, size_t found_name_len) {
    if (!pr) return false;
    ble_adv_extract_name(pr->scan_rst.ble_adv, pr->scan_rst.adv_data_len, pr->scan_rst.scan_rsp_len,
                     found_name, found_name_len);
    (void)target_name;

    // Only exact MAC matches: never auto-connect when no MAC is bound (no fuzzy name matching,
    // to prevent connecting to a nearby same-named adapter that yields no data). The user must manually select and bind a MAC on the BLE SCAN page.
    if (!s_target_bda_valid) return false;
    return memcmp(pr->scan_rst.bda, s_target_bda, sizeof(esp_bd_addr_t)) == 0;
}

static void request_discovery(void) {
    // NULL = discover all services, to stay compatible with ELM327 adapters using different UUIDs
    esp_ble_gattc_search_service(s_gattc_if, s_conn_id, NULL);
}

static void enable_notify_if_ready(void) {
    if (s_cccd_handle) {
        uint8_t notify_en[2] = {0x01, 0x00};
        esp_ble_gattc_write_char_descr(s_gattc_if, s_conn_id, s_cccd_handle,
                                       sizeof(notify_en), notify_en,
                                       ESP_GATT_WRITE_TYPE_RSP, ESP_GATT_AUTH_REQ_NONE);
    }
}

static void gap_event_handler(esp_gap_ble_cb_event_t event, esp_ble_gap_cb_param_t *param);
static void process_rx_queue(void);

void elm327_ble_get_runtime_stats(elm327_ble_runtime_stats_t *out)
{
    if (!out) return;
    portENTER_CRITICAL(&s_runtime_mux);
    out->rx_enqueued = s_runtime_stats.rx_enqueued;
    out->rx_dropped = s_runtime_stats.rx_dropped;
    out->rx_processed = s_runtime_stats.rx_processed;
    out->poll_slots = s_runtime_stats.poll_slots;
    out->poll_rounds = s_runtime_stats.poll_rounds;
    out->valid_frames = s_runtime_stats.valid_frames;
    out->disconnects = s_runtime_stats.disconnects;
    out->queue_high_watermark = s_runtime_stats.queue_high_watermark;
    out->last_rx_us = s_runtime_stats.last_rx_us;
    portEXIT_CRITICAL(&s_runtime_mux);
}

void elm327_ble_init_and_start(const char *target_name, const elm327_ble_callbacks_t *cbs) {
    if (cbs) s_cbs = *cbs;
    if (!s_rx_queue) s_rx_queue = xQueueCreate(OBD_RX_QUEUE_LENGTH, sizeof(obd_rx_item_t));
    if (target_name && target_name[0]) {
        strncpy(s_target_name, target_name, sizeof(s_target_name)-1);
        s_target_name[sizeof(s_target_name)-1] = '\0';
    }

    esp_bt_controller_config_t bt_cfg = BT_CONTROLLER_INIT_CONFIG_DEFAULT();
    esp_bt_controller_mem_release(ESP_BT_MODE_CLASSIC_BT);
    if (esp_bt_controller_get_status() == ESP_BT_CONTROLLER_STATUS_IDLE) {
        ESP_ERROR_CHECK(esp_bt_controller_init(&bt_cfg));
    }
    if (esp_bt_controller_get_status() != ESP_BT_CONTROLLER_STATUS_ENABLED) {
        ESP_ERROR_CHECK(esp_bt_controller_enable(ESP_BT_MODE_BLE));
    }
    if (!esp_bluedroid_get_status()) {
        // Raise the local ATT MTU from the 23-byte default: the phone OTA app requests
        // 517 and the negotiated MTU is min(both). 23 bytes would cripple OTA throughput
        // (20-byte writes) and force long-read fragmentation for the manifest.
        esp_ble_gatt_set_local_mtu(517);
        ESP_ERROR_CHECK(esp_bluedroid_init());
        ESP_ERROR_CHECK(esp_bluedroid_enable());
    } else if (esp_bluedroid_get_status() != ESP_BLUEDROID_STATUS_ENABLED) {
        ESP_ERROR_CHECK(esp_bluedroid_enable());
    }

    ESP_ERROR_CHECK(esp_ble_gap_register_callback(gap_event_handler));
    ESP_ERROR_CHECK(esp_ble_gattc_register_callback(gattc_event_handler));
    ESP_ERROR_CHECK(esp_ble_gattc_app_register(0));
    s_ble_inited = true;
}

bool elm327_ble_send_command(const uint8_t *data, size_t len) {
    if (!s_connected || s_char_write_handle == 0) {
        s_elm_ready = true; // restore the flag when unable to send, to prevent a permanent timeout
        return false;
    }
    if (len == 0 || data == NULL) { s_elm_ready = true; return false; }
    esp_err_t err = esp_ble_gattc_write_char(s_gattc_if, s_conn_id, s_char_write_handle,
                                             len, (uint8_t *)data,
                                             s_write_type, ESP_GATT_AUTH_REQ_NONE);
    if (err != ESP_OK) s_elm_ready = true; // also restore on send failure
    return err == ESP_OK;
}

// Block until the previous response ends ('>' received) before sending.
// Uses FreeRTOS task notifications instead of 10ms polling: xTaskNotify wakes immediately on '>', zero wait overhead.
bool elm327_ble_send_ascii_blocking(const char *ascii_cmd)
{
    // Fast-exit when disconnected: no point waiting for a '>' that will never arrive.
    // Prevents up to 3s of pointless blocking per command after a BLE drop.
    if (!s_connected) {
        s_elm_ready = true;
        return false;
    }
    if (!s_elm_ready) {
        uint32_t waited_ms = 0;
        while (!s_elm_ready && waited_ms < 3000) {
            // Disconnect mid-wait → abort immediately instead of waiting up to 3s
            if (!s_connected) { s_elm_ready = true; return false; }
            // Wait at most 10ms (as a fallback); xTaskNotify wakes early when '>' arrives
            ulTaskNotifyTake(pdTRUE, pdMS_TO_TICKS(10));
            waited_ms += 10;
            process_rx_queue();
            // Feed the watchdog: this wait loop itself can run close to 3s (adapter unresponsive / protocol detection timing out repeatedly).
            // The TWDT timeout is only 5s; without feeding here, a few consecutive protocol-detect timeouts would
            // trip the obd_poll task's watchdog and reboot (reproduced in testing).
            esp_task_wdt_reset();
        }
        if (!s_elm_ready) {
            ESP_LOGW(TAG, "Timeout (>3s) waiting previous response, forcing send: %s", ascii_cmd);
            s_elm_ready = true;
        }
    }
    s_elm_ready = false;
    uint8_t buf[32];
    size_t n = elm327_ble_ascii_cmd_to_bytes(ascii_cmd, buf, sizeof(buf));
    if (n) return elm327_ble_send_command(buf, n);
    else {
        s_elm_ready = true;
        return false;
    }
}

// Copy an ASCII command (e.g. "01 0C\r") into the output buffer, stripping whitespace while keeping the ASCII format the ELM327 expects
size_t elm327_ble_ascii_cmd_to_bytes(const char *ascii, uint8_t *out_buf, size_t out_buf_len) {
    size_t out = 0;
    const char *p = ascii;
    while (*p && out < out_buf_len) {
        if (*p == ' ' || *p == '\t') {
            p++;                // skip whitespace
            continue;
        }
        out_buf[out++] = (uint8_t)(*p++); // copy the ASCII byte directly
    }
    return out;
}

static void gap_event_handler(esp_gap_ble_cb_event_t event, esp_ble_gap_cb_param_t *param) {
    racechrono_ble_diy_handle_gap_event(event, param);

    switch (event) {
    case ESP_GAP_BLE_SCAN_PARAM_SET_COMPLETE_EVT: {
        s_scan_params_ready = true;
        if (s_scan_only_mode && s_scan_start_pending) {
            s_scan_start_pending = false;
            esp_err_t err = esp_ble_gap_start_scanning(s_scan_pending_duration);
            ESP_LOGI(TAG, "Scan-only started after scan params ready (%ds): %s",
                     s_scan_pending_duration, esp_err_to_name(err));
            break;
        }
        // Only auto-start scanning when a target MAC is actually bound. Stack-only inits
        // (no OBD device bound) must not scan: scanning duty-cycles the radio and degrades
        // the SkyGauge pairing advert on MASTER devices.
        if (s_target_bda_valid && !s_scan_only_mode && !s_connection_failed && !s_ota_paused) {
            start_scan();
        }
        break;
    }
    case ESP_GAP_BLE_SCAN_RESULT_EVT: {
        esp_ble_gap_cb_param_t *pr = param;
        if (pr->scan_rst.search_evt == ESP_GAP_SEARCH_INQ_RES_EVT) {
            char dev_name[32] = {0};
            ble_adv_extract_name(pr->scan_rst.ble_adv, pr->scan_rst.adv_data_len,
                             pr->scan_rst.scan_rsp_len, dev_name, sizeof(dev_name));

            if (s_scan_only_mode) {
                ESP_LOGD(TAG, "Scan result: mac=%02x:%02x:%02x:%02x:%02x:%02x rssi=%d adv=%u rsp=%u name='%s'",
                         pr->scan_rst.bda[0], pr->scan_rst.bda[1], pr->scan_rst.bda[2],
                         pr->scan_rst.bda[3], pr->scan_rst.bda[4], pr->scan_rst.bda[5],
                         pr->scan_rst.rssi, pr->scan_rst.adv_data_len, pr->scan_rst.scan_rsp_len,
                         dev_name);
                // Scan mode: collect the device list only while a page callback is active.
                // Inquiry-complete can be followed by already-queued result events.
                if (s_scan_cb && dev_name[0] != '\0' && s_scan_count < BLE_SCAN_MAX_DEVICES) {
                    // Check if it already exists
                    bool exists = false;
                    for (int i = 0; i < s_scan_count; i++) {
                        if (strcmp(s_scan_list[i].name, dev_name) == 0) {
                            exists = true;
                            break;
                        }
                    }
                    if (!exists) {
                        strncpy(s_scan_list[s_scan_count].name, dev_name, 31);
                        memcpy(s_scan_list[s_scan_count].addr, pr->scan_rst.bda, 6);
                        s_scan_list[s_scan_count].rssi = pr->scan_rst.rssi;
                        s_scan_count++;
                        ESP_LOGI(TAG, "Scan found [%d]: %s (RSSI %d)", s_scan_count, dev_name, pr->scan_rst.rssi);
                        if (s_scan_cb) s_scan_cb(&s_scan_list[s_scan_count - 1], s_scan_count);
                    }
                }
            } else {
                // Normal mode: connect after matching
                bool matched = match_device_target(pr, s_target_name, dev_name, sizeof(dev_name));
                ESP_LOGD(TAG, "Scan: name=%s rssi=%d target=%s match=%d",
                         dev_name[0] ? dev_name : "<no-name>", pr->scan_rst.rssi,
                         s_target_name, matched);
                if (matched) {
                    ESP_LOGD(TAG, "Found target %s (dev=%s), connecting...",
                             s_target_name, dev_name[0] ? dev_name : "<no-name>");
                    esp_ble_gap_stop_scanning();
                    esp_err_t err = esp_ble_gattc_open(s_gattc_if, pr->scan_rst.bda,
                                                       pr->scan_rst.ble_addr_type, true);
                    if (err != ESP_OK) {
                        ESP_LOGE(TAG, "Open request failed: %s", esp_err_to_name(err));
                        s_connection_failed = true;
                    }
                }
            }
        } else if (pr->scan_rst.search_evt == ESP_GAP_SEARCH_INQ_CMPL_EVT) {
            if (s_scan_only_mode) {
                s_scan_start_pending = false;
                ESP_LOGI(TAG, "Scan complete: %d named devices", s_scan_count);
                ble_scan_found_cb_t cb = s_scan_cb;
                s_scan_cb = NULL;
                if (cb) cb(NULL, s_scan_count);
                break;
            }
            // A target scan is one connection attempt. Leave the target saved so
            // the UI can offer an explicit retry instead of looping forever.
            if (!s_scan_only_mode && s_target_bda_valid && !s_connected && !s_ota_paused) {
                s_connection_failed = true;
                ESP_LOGW(TAG, "OBD target not found during scan");
            }
        }
        break;
    }
    case ESP_GAP_BLE_SCAN_STOP_COMPLETE_EVT:
    default:
        break;
    }
}

// Locate a CAN ID's frame-header token in the multi-line accumulation buffer; only accept matches "at the line start".
// Must not strstr the whole buffer directly: if some frame's data-byte text happens to equal another monitored ID
// (e.g. oil-temp byte =0x40 while the profile also monitors 0x040), it false-matches inside the data segment and mislabels the frame.
static const char *find_can_id_token(const char *buf, uint16_t id) {
    char upper[8], lower[8];
    snprintf(upper, sizeof(upper), "%X ", id);
    snprintf(lower, sizeof(lower), "%x ", id);
    for (int pass = 0; pass < 2; pass++) {
        const char *needle = (pass == 0) ? upper : lower;
        const char *scan = buf;
        while ((scan = strstr(scan, needle)) != NULL) {
            if (scan == buf || scan[-1] == '\r' || scan[-1] == '\n') return scan;
            scan += 1; // coincidental match inside data bytes; skip it and keep looking for a real line start
        }
    }
    return NULL;
}
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
