omniscientjoker/obd_brz_gauge/main/app_obd_dsp/obd_data_cache.c

#include "obd_data_cache.h"
#include "vehicle_profiles.h"
#include "freertos/FreeRTOS.h"
#include "freertos/portmacro.h"
#include "freertos/task.h"
#include "esp_timer.h"
#include "bsp_obd_dsp/nvs_storage.h"


// Simple globals protected by a critical section
static int16_t  s_coolant_temp = -40;
static int16_t  s_oil_temp = -100;
static int16_t  s_intake_temp = -40;
static int16_t  s_load_pct = -1;
static int16_t  s_tps = -1;
static int32_t  s_bat_mv = -1;
static int16_t  s_oil_pressure_x10 = -1;
static int16_t  s_brake_temp_x10 = -1000;
static int16_t  s_boost_x10 = -32768;
static int8_t   s_gear = 127;
static int16_t  s_afr_x100 = -1;
static int16_t  s_fuel_pct = -1;
static brake_rs485_status_t s_brake_rs485_status = BRAKE_RS485_IDLE;
static obd_data_channel_state_t s_channel_state[OBD_DATA_CHANNEL_COUNT];
static portMUX_TYPE s_mux = portMUX_INITIALIZER_UNLOCKED;

#define SPEED_SMOOTH_TIME_MS 300   // speed ramp-up/down time constant (ms); the UI side already has anim_step, keep this small
#define FALL_TO_ZERO_MS      500   // fall-to-zero ramp-down time constant (ms)

// Smoothing state (advanced on the setter side, getters only read; unaffected by the number of callers)
static uint16_t s_rpm_smooth = 0;
static uint8_t  s_speed_smooth = 0;
static TickType_t s_speed_last_tick = 0;
static float s_speed_smooth_f = 0.f;

// RPM override layer: during multi-gauge linkage tests, the master gauge injects simulated RPM here.
// When enabled, obd_data_get_rpm() returns the override value (used for both local display and ESP-NOW broadcast).
static bool     s_rpm_override_en = false;
static uint16_t s_rpm_override_val = 0;

static inline void mark_channel_locked(obd_data_channel_t channel, bool valid)
{
    if (channel >= OBD_DATA_CHANNEL_COUNT) return;
    s_channel_state[channel].valid = valid;
    s_channel_state[channel].updated_us = valid ? esp_timer_get_time() : 0;
}

static inline void invalidate_channel_locked(obd_data_channel_t channel)
{
    mark_channel_locked(channel, false);
}

void obd_data_rpm_override_set(bool en, uint16_t val)
{
    portENTER_CRITICAL(&s_mux);
    s_rpm_override_en = en;
    s_rpm_override_val = val;
    portEXIT_CRITICAL(&s_mux);
}

void obd_data_set_rpm(uint16_t rpm)
{
    portENTER_CRITICAL(&s_mux);
    s_rpm_smooth = rpm;  // CAN 100Hz data is already clean, no smoothing needed
    mark_channel_locked(OBD_DATA_RPM, true);
    portEXIT_CRITICAL(&s_mux);
}

void obd_data_reset_temp_cache(void)
{
    portENTER_CRITICAL(&s_mux);
    s_coolant_temp = -40;
    s_oil_temp = -100;
    s_intake_temp = -40;
    s_fuel_pct = -1;
    invalidate_channel_locked(OBD_DATA_COOLANT);
    invalidate_channel_locked(OBD_DATA_OIL);
    invalidate_channel_locked(OBD_DATA_INTAKE);
    invalidate_channel_locked(OBD_DATA_FUEL);
    portEXIT_CRITICAL(&s_mux);
}

void obd_data_reset(void)
{
    portENTER_CRITICAL(&s_mux);
    s_rpm_smooth = 0;
    s_speed_smooth = 0;
    s_speed_smooth_f = 0.0f;
    s_speed_last_tick = xTaskGetTickCount();
    s_coolant_temp = -40;
    s_oil_temp = -100;
    s_intake_temp = -40;
    s_load_pct = -1;
    s_tps = -1;
    s_bat_mv = -1;
    s_oil_pressure_x10 = -1;
    s_brake_temp_x10 = -1000;
    s_boost_x10 = -32768;
    s_gear = 127;
    s_afr_x100 = -1;
    s_fuel_pct = -1;
    s_brake_rs485_status = BRAKE_RS485_IDLE;
    s_rpm_override_en = false;
    s_rpm_override_val = 0;
    for (unsigned i = 0; i < OBD_DATA_CHANNEL_COUNT; ++i) {
        invalidate_channel_locked((obd_data_channel_t)i);
    }
    portEXIT_CRITICAL(&s_mux);
}

bool obd_data_get_channel_state(obd_data_channel_t channel,
                                obd_data_channel_state_t *out)
{
    if (!out || channel >= OBD_DATA_CHANNEL_COUNT) return false;
    portENTER_CRITICAL(&s_mux);
    *out = s_channel_state[channel];
    portEXIT_CRITICAL(&s_mux);
    return true;
}

void obd_data_invalidate_channel(obd_data_channel_t channel)
{
    if (channel >= OBD_DATA_CHANNEL_COUNT) return;
    portENTER_CRITICAL(&s_mux);
    invalidate_channel_locked(channel);
    portEXIT_CRITICAL(&s_mux);
}

bool obd_data_channel_is_fresh(obd_data_channel_t channel, int64_t max_age_us)
{
    if (channel >= OBD_DATA_CHANNEL_COUNT || max_age_us < 0) return false;
    const int64_t now_us = esp_timer_get_time();
    bool fresh;
    portENTER_CRITICAL(&s_mux);
    fresh = s_channel_state[channel].valid &&
            s_channel_state[channel].updated_us > 0 &&
            now_us - s_channel_state[channel].updated_us <= max_age_us;
    portEXIT_CRITICAL(&s_mux);
    return fresh;
}

void obd_data_set_oil_temp_invalid(void)
{
    portENTER_CRITICAL(&s_mux);
    s_oil_temp = -100;
    invalidate_channel_locked(OBD_DATA_OIL);
    portEXIT_CRITICAL(&s_mux);
}

void obd_data_set_coolant_temp_invalid(void)
{
    portENTER_CRITICAL(&s_mux);
    s_coolant_temp = -40;
    invalidate_channel_locked(OBD_DATA_COOLANT);
    portEXIT_CRITICAL(&s_mux);
}

void obd_data_set_speed(uint8_t kmh)
{
    TickType_t now_tick = xTaskGetTickCount();
    uint32_t dt_ms = (now_tick - s_speed_last_tick) * portTICK_PERIOD_MS;
    if (dt_ms > 1000) dt_ms = 1000;
    s_speed_last_tick = now_tick;

    uint32_t tc = (kmh == 0) ? FALL_TO_ZERO_MS : SPEED_SMOOTH_TIME_MS;
    float alpha = (float)dt_ms / (float)tc;
    if (alpha > 1.0f) alpha = 1.0f;
    s_speed_smooth_f += alpha * ((float)kmh - s_speed_smooth_f);

    uint8_t smoothed = (uint8_t)(s_speed_smooth_f + 0.5f);
    portENTER_CRITICAL(&s_mux);
    s_speed_smooth = smoothed;
    mark_channel_locked(OBD_DATA_SPEED, true);
    portEXIT_CRITICAL(&s_mux);
}

void obd_data_set_coolant_temp(int16_t temp)
{
    portENTER_CRITICAL(&s_mux);
    s_coolant_temp = temp;
    mark_channel_locked(OBD_DATA_COOLANT, true);
    portEXIT_CRITICAL(&s_mux);
}

void obd_data_set_oil_temp(int16_t temp)
{
    if (temp < -20 || temp > 150) return;
    portENTER_CRITICAL(&s_mux);
    s_oil_temp = temp;
    mark_channel_locked(OBD_DATA_OIL, true);
    portEXIT_CRITICAL(&s_mux);
}

void obd_data_set_intake_temp(int16_t temp)
{
    portENTER_CRITICAL(&s_mux);
    s_intake_temp = temp;
    mark_channel_locked(OBD_DATA_INTAKE, true);
    portEXIT_CRITICAL(&s_mux);
}

uint16_t obd_data_get_rpm(void)
{
    uint16_t val;
    portENTER_CRITICAL(&s_mux);
    val = s_rpm_override_en ? s_rpm_override_val : s_rpm_smooth;
    portEXIT_CRITICAL(&s_mux);
    return val;
}

uint8_t obd_data_get_speed(void)
{
    uint8_t val;
    portENTER_CRITICAL(&s_mux);
    val = s_speed_smooth;
    portEXIT_CRITICAL(&s_mux);
    return val;
}

int16_t obd_data_get_coolant_temp(void)
{
    int16_t val;
    portENTER_CRITICAL(&s_mux);
    val = s_coolant_temp;
    portEXIT_CRITICAL(&s_mux);
    return val;
}

int16_t obd_data_get_oil_temp(void)
{
    int16_t val;
    portENTER_CRITICAL(&s_mux);
    val = s_oil_temp;
    portEXIT_CRITICAL(&s_mux);
    return val;
}

int16_t obd_data_get_intake_temp(void)
{
    int16_t val;
    portENTER_CRITICAL(&s_mux);
    val = s_intake_temp;
    portEXIT_CRITICAL(&s_mux);
    return val;
}

void obd_data_set_load_pct(int16_t pct)
{
    portENTER_CRITICAL(&s_mux);
    s_load_pct = pct;
    mark_channel_locked(OBD_DATA_LOAD, pct >= 0);
    portEXIT_CRITICAL(&s_mux);
}

int16_t obd_data_get_load_pct(void)
{
    int16_t val;
    portENTER_CRITICAL(&s_mux);
    val = s_load_pct;
    portEXIT_CRITICAL(&s_mux);
    return val;
}

void obd_data_set_tps(int16_t pct)
{
    portENTER_CRITICAL(&s_mux);
    s_tps = pct;
    mark_channel_locked(OBD_DATA_TPS, pct >= 0);
    portEXIT_CRITICAL(&s_mux);
}

int16_t obd_data_get_tps(void)
{
    int16_t val;
    portENTER_CRITICAL(&s_mux);
    val = s_tps;
    portEXIT_CRITICAL(&s_mux);
    return val;
}

void obd_data_set_bat_mv(int32_t mv)
{
    portENTER_CRITICAL(&s_mux);
    s_bat_mv = mv;
    mark_channel_locked(OBD_DATA_BATTERY, mv >= 0);
    portEXIT_CRITICAL(&s_mux);
}

int32_t obd_data_get_bat_mv(void)
{
    int32_t val;
    portENTER_CRITICAL(&s_mux);
    val = s_bat_mv;
    portEXIT_CRITICAL(&s_mux);
    return val;
}

void obd_data_set_oil_pressure_x10(int16_t pressure_x10)
{
    if (pressure_x10 < 0 || pressure_x10 > 200) return;
    portENTER_CRITICAL(&s_mux);
    s_oil_pressure_x10 = pressure_x10;
    mark_channel_locked(OBD_DATA_OIL_PRESSURE, true);
    portEXIT_CRITICAL(&s_mux);
}

int16_t obd_data_get_oil_pressure_x10(void)
{
    int16_t val;
    portENTER_CRITICAL(&s_mux);
    val = s_oil_pressure_x10;
    portEXIT_CRITICAL(&s_mux);
    return val;
}

void obd_data_set_boost_x10(int16_t boost_x10)
{
    if (boost_x10 < -15 || boost_x10 > 300) return;
    portENTER_CRITICAL(&s_mux);
    s_boost_x10 = boost_x10;
    mark_channel_locked(OBD_DATA_BOOST, true);
    portEXIT_CRITICAL(&s_mux);
}

int16_t obd_data_get_boost_x10(void)
{
    int16_t val;
    portENTER_CRITICAL(&s_mux);
    val = s_boost_x10;
    portEXIT_CRITICAL(&s_mux);
    return val;
}

void obd_data_set_brake_temp_x10(int16_t temp_x10)
{
    if (temp_x10 < -500 || temp_x10 > 12000) return;
    portENTER_CRITICAL(&s_mux);
    s_brake_temp_x10 = temp_x10;
    mark_channel_locked(OBD_DATA_BRAKE_TEMP, true);
    portEXIT_CRITICAL(&s_mux);
}

void obd_data_set_brake_rs485_status(brake_rs485_status_t status)
{
    portENTER_CRITICAL(&s_mux);
    s_brake_rs485_status = status;
    portEXIT_CRITICAL(&s_mux);
}

int16_t obd_data_get_brake_temp_x10(void)
{
    int16_t val;
    portENTER_CRITICAL(&s_mux);
    val = s_brake_temp_x10;
    portEXIT_CRITICAL(&s_mux);
    return val;
}

void obd_data_set_gear(int8_t gear)
{
    portENTER_CRITICAL(&s_mux);
    s_gear = gear;
    mark_channel_locked(OBD_DATA_GEAR, gear != 127);
    portEXIT_CRITICAL(&s_mux);
}

int8_t obd_data_get_gear(void)
{
    int8_t val;
    portENTER_CRITICAL(&s_mux);
    val = s_gear;
    portEXIT_CRITICAL(&s_mux);
    return val;
}

void obd_data_set_afr_x100(int16_t afr_x100)
{
    if (afr_x100 < 800 || afr_x100 > 2200) return;
    portENTER_CRITICAL(&s_mux);
    s_afr_x100 = afr_x100;
    mark_channel_locked(OBD_DATA_AFR, true);
    portEXIT_CRITICAL(&s_mux);
}

int16_t obd_data_get_afr_x100(void)
{
    int16_t val;
    portENTER_CRITICAL(&s_mux);
    val = s_afr_x100;
    portEXIT_CRITICAL(&s_mux);
    return val;
}

void obd_data_set_fuel_pct(int16_t fuel_pct)
{
    if (fuel_pct < 0 || fuel_pct > 100) return;
    portENTER_CRITICAL(&s_mux);
    s_fuel_pct = fuel_pct;
    mark_channel_locked(OBD_DATA_FUEL, true);
    portEXIT_CRITICAL(&s_mux);
}

int16_t obd_data_get_fuel_pct(void)
{
    int16_t val;
    portENTER_CRITICAL(&s_mux);
    val = s_fuel_pct;
    portEXIT_CRITICAL(&s_mux);
    return val;
}

void obd_data_get_snapshot(obd_data_snapshot_t *out)
{
    if (!out) return;

    portENTER_CRITICAL(&s_mux);
    out->rpm = s_rpm_override_en ? s_rpm_override_val : s_rpm_smooth;
    out->speed = s_speed_smooth;
    out->coolant_temp = s_coolant_temp;
    out->oil_temp = s_oil_temp;
    out->intake_temp = s_intake_temp;
    out->load_pct = s_load_pct;
    out->tps = s_tps;
    out->bat_mv = s_bat_mv;
    out->oil_pressure_x10 = s_oil_pressure_x10;
    out->boost_x10 = s_boost_x10;
    out->brake_temp_x10 = s_brake_temp_x10;
    out->gear = s_gear;
    out->afr_x100 = s_afr_x100;
    out->fuel_pct = s_fuel_pct;
    out->brake_rs485_status = s_brake_rs485_status;
    for (unsigned i = 0; i < OBD_DATA_CHANNEL_COUNT; ++i) {
        out->state[i] = s_channel_state[i];
    }
    portEXIT_CRITICAL(&s_mux);
}

/**
 * @brief Compute and determine the gear from RPM and vehicle speed
 * @param rpm engine speed (RPM)
 * @param speed vehicle speed (km/h)
 * @return the computed gear
 */
enGear calculate_gear(float rpm, float speed) {
    static enGear s_last_gear = GEAR_NEUTRAL;
    // 1. Check input data validity
    if (rpm <= 0 || speed <= 0) {
        s_last_gear = GEAR_NEUTRAL;
        return GEAR_NEUTRAL;
    }

    // 2. Compute the total gear ratio using the active vehicle profile
    const vehicle_profile_t *profile = vehicle_profile_get_active();
    float calc_const = vehicle_profile_calc_constant(profile);
    float total_ratio = rpm / (speed * calc_const);

    // 3. Compare against each gear's ratio range
    uint8_t range_count = 0;
    const gear_ratio_range_t *ranges = vehicle_profile_get_gear_ranges(&range_count);
    for (int i = 0; i < range_count; i++) {
        if (total_ratio >= ranges[i].min_ratio &&
            total_ratio <= ranges[i].max_ratio) {
            s_last_gear = ranges[i].gear;
            return ranges[i].gear;
        }
    }
    
    // 4. Outside all ranges: check if it could be neutral (high RPM, near-zero speed)
    if (rpm > 800 && speed < 5) { // Above idle and nearly stationary
        s_last_gear = GEAR_NEUTRAL;
        return GEAR_NEUTRAL;
    }
    
    // 5. Unrecognized ratio: return the last gear
    return s_last_gear;
}


/**
 * @brief Mileage statistics timer callback
 * @param pvParameter argument
 * @return none
 * @note
 * @note Mileage statistics task
 */
static void mileage_timer_cb(void* arg)
{
    (void)arg;
    obd_data_snapshot_t snap;
    obd_data_get_snapshot(&snap);
    nvs_stat_update_speed(snap.speed, 1000);
}

/**
 * @brief Initialize the mileage statistics task
 * @return none
 * @note
 * @note Initialize the mileage statistics task
 */
void vMileageDataStatisticTask(void)
{
    static esp_timer_handle_t s_timer = NULL;
    if(!s_timer){
        const esp_timer_create_args_t args={
            .callback = mileage_timer_cb,
            .arg = NULL,
            .name = "mile_stat"
        };
        if(esp_timer_create(&args,&s_timer)==ESP_OK){
            esp_timer_start_periodic(s_timer, 1000000); //1s
        }
    }
}
