omniscientjoker/obd_brz_gauge/main/bsp_obd_dsp/espnow_link.c

// Three-gauge ESP-NOW link: the master reads OBD then broadcasts to slaves.
// One master, many slaves, broadcast (1-to-many), coexists with BLE (master).
// Broadcast remains the wire transport for compatibility. Bound slaves filter
// the source MAC; legacy OBD packets additionally use a rolling sequence,
// while the TPMS extension uses a versioned CRC-protected packet.

#include "espnow_link.h"
#include "app_obd_dsp/app_event.h"
#include <string.h>
#include "freertos/FreeRTOS.h"
#include "freertos/task.h"
#include "esp_log.h"
#include "esp_idf_version.h"
#include "esp_wifi.h"
#include "esp_now.h"
#include "esp_event.h"
#include "esp_netif.h"
#include "esp_timer.h"
#include "app_obd_dsp/obd_data_cache.h"
#include "app_obd_dsp/obd_tpms_cache.h"
#include "bsp_obd_dsp/elm327_ble_client.h"
#include "bsp_obd_dsp/nvs_storage.h"

// Sweep / boot-animation sync: read from the master (implemented in ui.c to avoid re-including lvgl here)
extern int  ui_sweep_get_step(void);
extern int  ui_intro_get_step(void);

#define TAG "espnow_link"

#define ESPNOW_CHANNEL          1       // master and slaves must share a channel (fixed here when STA is not connected to an AP)
#define ESPNOW_MAGIC            0x4F42  // 'OB' packet-header magic
#define ESPNOW_VER              5       // v5: added afr_x100 (air-fuel ratio)
#define ESPNOW_TPMS_VER         2       // CRC-protected extension; old OBD packets stay compatible
#define ESPNOW_PACKET_TPMS      3
#define ESPNOW_LEGACY_BROADCAST_COMPAT 1
#define MASTER_NAME_LEN         12
static const char MASTER_NAME[] = "SkyGauge";   // name the master broadcasts (shown on slaves); could become configurable later
#define BROADCAST_INTERVAL_MS   100     // master broadcast period (10Hz, plenty for gauges)
#define PRESENCE_INTERVAL_MS    500     // slave "presence" report period
#define MG_MAX_SLAVES           4       // max slaves the master tracks
#define MG_SLAVE_TIMEOUT_US     2000000 // a slave is considered online if it reported within 2s

static bool s_is_master = false;
static bool s_espnow_started = false;  // Track if ESP-NOW was actually started
static bool s_wifi_initialized = false;  // Track if WiFi was initialized
static TaskHandle_t s_master_task_handle = NULL;
static TaskHandle_t s_linktest_task_handle = NULL;
static TaskHandle_t s_presence_task_handle = NULL;

// Slave -> master "presence" packet (small; distinguished from the OBD packet by length)
typedef struct __attribute__((packed)) {
    uint16_t magic;
    uint8_t  version;
    uint8_t  position;   // slave position 1/2/3
} espnow_presence_t;

// Multi-gauge linked control packet (slave <-> master; length differs from both OBD and presence packets, dispatched by length)
#define ESPNOW_CTRL_TEST_START   1   // ask the master to start the linked test (arg unused)
#define ESPNOW_CTRL_THRESH_SET   2   // sync the RPM warning threshold (arg = threshold)
typedef struct __attribute__((packed)) {
    uint16_t magic;
    uint8_t  version;
    uint8_t  cmd;
    uint16_t arg;
} espnow_ctrl_packet_t;

// Master side: linked-test RPM ramp state (the master is the single RPM injection source; slaves follow via broadcast)
static volatile bool s_linktest_active = false;
static int64_t s_linktest_start_us = 0;
static volatile bool s_rx_linktest = false;   // slave side: last received "linked test in progress" flag from the master
static volatile bool s_rx_linked_en = false;  // slave side: master's rpm_warn_linked_en (mirrored from broadcast flags bit2)
#define LINKTEST_RISE_MS 5000   // 0 -> peak, slow rise
#define LINKTEST_HOLD_MS 800    // hold at peak (flash)
#define LINKTEST_FALL_MS 2500   // peak -> 0, fall back

// Master side: online slave records
static struct { uint8_t mac[6]; uint8_t position; int64_t last_us; } s_slaves[MG_MAX_SLAVES];

// recv callback forward declaration (defined later in the file, needed by master init; signature depends on IDF version)
#if ESP_IDF_VERSION >= ESP_IDF_VERSION_VAL(5, 0, 0)
static void recv_cb(const esp_now_recv_info_t *info, const uint8_t *data, int len);
#else
static void recv_cb(const uint8_t *mac, const uint8_t *data, int len);
#endif

static const uint8_t s_broadcast_mac[6] = {0xFF, 0xFF, 0xFF, 0xFF, 0xFF, 0xFF};
static volatile int64_t s_last_rx_us = 0;
static volatile int64_t s_last_tpms_rx_us = 0;
static uint32_t s_tx_seq = 0;
static bool s_have_rx_seq = false;
static uint32_t s_last_rx_seq = 0;
static bool s_have_tpms_seq = false;
static uint32_t s_last_tpms_seq = 0;
static uint32_t s_drop_duplicate = 0;
static uint32_t s_drop_integrity = 0;
static uint32_t s_drop_header = 0;

static void log_drop_sampled(const char *reason, uint32_t *counter)
{
    if (!counter) return;
    (*counter)++;
    if (*counter == 1 || (*counter % 64u) == 0) {
        ESP_LOGW(TAG, "ESP-NOW dropped %s (count=%lu)", reason, (unsigned long)*counter);
    }
}

static bool seq_is_newer(uint32_t seq, uint32_t last)
{
    return (int32_t)(seq - last) > 0;
}

static uint16_t packet_crc16(const uint8_t *data, size_t len)
{
    uint16_t crc = 0xFFFF;
    for (size_t i = 0; i < len; ++i) {
        crc ^= data[i];
        for (uint8_t bit = 0; bit < 8; ++bit) {
            crc = (crc & 1u) ? (uint16_t)((crc >> 1) ^ 0xA001u) : (uint16_t)(crc >> 1);
        }
    }
    return crc;
}

// Broadcast packet: mirrors the available fields of obd_data_cache (packed, identical on master and slaves).
typedef struct __attribute__((packed)) {
    uint16_t magic;
    uint8_t  version;
    uint8_t  flags;             // bit0: master connected to ELM327; bit1: linked test in progress
    uint32_t seq;               // incrementing sequence (for packet-loss diagnosis)
    uint16_t rpm;
    uint8_t  speed;
    uint8_t  sweep_step;        // master's current sweep progress (0=none); slaves follow for a synced sweep
    uint8_t  intro_step;        // boot-animation progress (0=none, 1..4, 255=done); slaves follow
    int16_t  coolant_temp;
    int16_t  intake_temp;
    int16_t  oil_temp;
    int16_t  oil_pressure_x10;
    int16_t  boost_x10;
    int16_t  brake_temp_x10;
    int16_t  load_pct;
    int16_t  tps;
    int32_t  bat_mv;
    int16_t  afr_x100;          // air-fuel ratio AFR, x100 (1470=14.7:1), -1=invalid
    char     name[MASTER_NAME_LEN];  // master name (shown on the slave info page as "SLAVE: <name>")
} espnow_obd_packet_t;

// Keep the established v5 wire layout frozen. TPMS travels in the separate
// extension packet below so old gauges can continue consuming this packet.
_Static_assert(sizeof(espnow_obd_packet_t) == 47,
               "legacy ESP-NOW OBD packet ABI changed");

// TPMS is an optional extension packet rather than a field appended to the
// legacy OBD packet. Existing v5 packet size and old gauges remain compatible.
typedef struct __attribute__((packed)) {
    uint16_t magic;
    uint8_t  version;
    uint8_t  packet_type;
    uint32_t seq;
    uint8_t  valid_mask;
    int16_t  pressure_bar_x100[OBD_TPMS_WHEEL_COUNT];
    uint16_t crc16;
} espnow_tpms_packet_t;

_Static_assert(sizeof(espnow_tpms_packet_t) == 19,
               "TPMS ESP-NOW extension packet layout changed");

static char s_master_name[MASTER_NAME_LEN] = {0};  // slave side: name of the last master heard

// ---- WiFi + ESP-NOW low-level init (shared by master and slave) ----
static void wifi_espnow_init(void) {
    ESP_ERROR_CHECK(esp_netif_init());
    esp_err_t e = esp_event_loop_create_default();
    if (e != ESP_OK && e != ESP_ERR_INVALID_STATE) ESP_ERROR_CHECK(e);

    wifi_init_config_t cfg = WIFI_INIT_CONFIG_DEFAULT();
    // The gauge uses ESP-NOW only during normal operation, so keep its Wi-Fi
    // buffers sized for the low-rate packets instead of the OTA throughput profile.
    cfg.static_rx_buf_num = 4;
    cfg.dynamic_rx_buf_num = 8;
    cfg.rx_ba_win = 6;
    ESP_ERROR_CHECK(esp_wifi_init(&cfg));
    s_wifi_initialized = true;
    ESP_ERROR_CHECK(esp_wifi_set_storage(WIFI_STORAGE_RAM));
    ESP_ERROR_CHECK(esp_wifi_set_mode(WIFI_MODE_STA));
    ESP_ERROR_CHECK(esp_wifi_start());
    ESP_ERROR_CHECK(esp_wifi_set_channel(ESPNOW_CHANNEL, WIFI_SECOND_CHAN_NONE));
    esp_wifi_set_ps(WIFI_PS_NONE);   // disable power save, otherwise ESP-NOW RX drops/lags
    ESP_ERROR_CHECK(esp_now_init());
    s_espnow_started = true;
}

// ========================= Master =========================
static void master_pack(espnow_obd_packet_t *p) {
    obd_data_snapshot_t snap;
    nvs_user_cfg_t cfg = {0};
    nvs_cfg_get_snapshot(&cfg);

    p->magic   = ESPNOW_MAGIC;
    p->version = ESPNOW_VER;
    // bit0 = ELM connected; bit1 = linked test in progress; bit2 = rpm_warn_linked_en (slaves mirror this setting from master)
    p->flags   = (elm327_ble_is_connected() ? 0x01 : 0x00)
               | (s_linktest_active ? 0x02 : 0x00)
               | (cfg.rpm_warn_linked_en ? 0x04 : 0x00);
    p->seq     = ++s_tx_seq;
    obd_data_get_snapshot(&snap);
    p->rpm              = snap.rpm;
    p->speed            = snap.speed;
    p->sweep_step       = (uint8_t)ui_sweep_get_step();   // broadcast sweep progress for slave sync
    p->intro_step       = (uint8_t)ui_intro_get_step();   // broadcast boot-animation progress for slave sync
    p->coolant_temp     = snap.coolant_temp;
    p->intake_temp      = snap.intake_temp;
    p->oil_temp         = snap.oil_temp;
    p->oil_pressure_x10 = snap.oil_pressure_x10;
    p->boost_x10        = snap.boost_x10;
    p->brake_temp_x10   = snap.brake_temp_x10;
    p->load_pct         = snap.load_pct;
    p->tps              = snap.tps;
    p->bat_mv           = snap.bat_mv;
    p->afr_x100         = snap.afr_x100;
    strncpy(p->name, MASTER_NAME, MASTER_NAME_LEN);   // broadcast the master name
}

static void master_pack_tpms(espnow_tpms_packet_t *p)
{
    obd_tpms_snapshot_t snapshot;
    if (!p) return;
    obd_tpms_cache_get_snapshot(&snapshot);
    memset(p, 0, sizeof(*p));
    p->magic = ESPNOW_MAGIC;
    p->version = ESPNOW_TPMS_VER;
    p->packet_type = ESPNOW_PACKET_TPMS;
    p->seq = s_tx_seq;
    for (uint8_t i = 0; i < OBD_TPMS_WHEEL_COUNT; ++i) {
        p->pressure_bar_x100[i] = snapshot.pressure_bar_x100[i];
        if (snapshot.valid[i]) p->valid_mask |= (uint8_t)(1u << i);
    }
    p->crc16 = packet_crc16((const uint8_t *)p, sizeof(*p) - sizeof(p->crc16));
}

// Linked-test ramp control: compute the simulated RPM along the timeline and write it into the RPM override layer.
// The master's get_rpm returns the override -> master_pack broadcasts it to slaves and the master displays it; all gauges stay in sync.
static void master_linktest_task(void *arg) {
    for (;;) {
        if (s_linktest_active) {
            nvs_user_cfg_t cfg = {0};
            nvs_cfg_get_snapshot(&cfg);
            uint16_t thresh = cfg.rpm_warn_threshold;
            uint32_t peak = (uint32_t)thresh + 200;   // slightly above threshold so the all-gauge flash is clearly visible
            int64_t el_ms = (esp_timer_get_time() - s_linktest_start_us) / 1000;
            int64_t total = LINKTEST_RISE_MS + LINKTEST_HOLD_MS + LINKTEST_FALL_MS;
            if (el_ms < 0 || el_ms >= total) {
                s_linktest_active = false;
                obd_data_rpm_override_set(false, 0);   // release the override, restore real RPM
            } else {
                uint32_t rpm;
                if (el_ms < LINKTEST_RISE_MS) {
                    rpm = (uint32_t)((uint64_t)peak * el_ms / LINKTEST_RISE_MS);
                } else if (el_ms < LINKTEST_RISE_MS + LINKTEST_HOLD_MS) {
                    rpm = peak;
                } else {
                    int64_t f = el_ms - LINKTEST_RISE_MS - LINKTEST_HOLD_MS;
                    rpm = peak - (uint32_t)((uint64_t)peak * f / LINKTEST_FALL_MS);
                }
                obd_data_rpm_override_set(true, (uint16_t)rpm);
            }
        }
        vTaskDelay(pdMS_TO_TICKS(20));   // advance at 50Hz for a smooth gradient
    }
}

static void master_task(void *arg) {
    espnow_obd_packet_t pkt;
    espnow_tpms_packet_t tpms_pkt;
    for (;;) {
        master_pack(&pkt);
        esp_err_t r = esp_now_send(s_broadcast_mac, (const uint8_t *)&pkt, sizeof(pkt));
        if (r != ESP_OK) ESP_LOGW(TAG, "esp_now_send err=%d", r);
        master_pack_tpms(&tpms_pkt);
        r = esp_now_send(s_broadcast_mac, (const uint8_t *)&tpms_pkt, sizeof(tpms_pkt));
        if (r != ESP_OK) ESP_LOGW(TAG, "esp_now_send TPMS err=%d", r);
        vTaskDelay(pdMS_TO_TICKS(s_linktest_active ? 20 : BROADCAST_INTERVAL_MS));
    }
}

void espnow_link_start_master(void) {
    wifi_espnow_init();
    s_is_master = true;
    s_have_rx_seq = false;
    s_have_tpms_seq = false;
    s_last_rx_us = 0;
    s_last_tpms_rx_us = 0;
    obd_tpms_cache_reset();

    esp_now_peer_info_t peer = {0};
    memcpy(peer.peer_addr, s_broadcast_mac, 6);
    peer.channel = ESPNOW_CHANNEL;
    peer.ifidx   = WIFI_IF_STA;
    peer.encrypt = false;
    ESP_ERROR_CHECK(esp_now_add_peer(&peer));

    ESP_ERROR_CHECK(esp_now_register_recv_cb(recv_cb));   // receive slave presence/control packets
    xTaskCreate(master_task, "espnow_tx", 3072, NULL, 4, &s_master_task_handle);
    xTaskCreate(master_linktest_task, "espnow_lt", 3072, NULL, 4, &s_linktest_task_handle);
    ESP_LOGI(TAG, "ESP-NOW MASTER up (broadcast %dms, ch%d)", BROADCAST_INTERVAL_MS, ESPNOW_CHANNEL);
}

// ========================= Slave =========================
static void apply_packet(const espnow_obd_packet_t *p) {
    s_rx_linktest  = (p->flags & 0x02) != 0;   // master is running a linked test -> slaves take part in rendering during TEST
    s_rx_linked_en = (p->flags & 0x04) != 0;   // master's rpm_warn_linked_en: mirror so slaves render the gradient without manual NVS config
    obd_data_set_rpm(p->rpm);
    obd_data_set_speed(p->speed);
    obd_data_set_coolant_temp(p->coolant_temp);
    obd_data_set_intake_temp(p->intake_temp);
    obd_data_set_oil_temp(p->oil_temp);
    obd_data_set_oil_pressure_x10(p->oil_pressure_x10);
    obd_data_set_boost_x10(p->boost_x10);
    obd_data_set_brake_temp_x10(p->brake_temp_x10);
    obd_data_set_load_pct(p->load_pct);
    obd_data_set_tps(p->tps);
    obd_data_set_bat_mv(p->bat_mv);
    obd_data_set_afr_x100(p->afr_x100);
    // Notify the UI task via the event queue (avoids races from direct cross-task calls)
    app_event_send(APP_EVT_ESPNOW_SYNC_SLOT, p->sweep_step);
    app_event_send(APP_EVT_ESPNOW_INTRO_STEP, p->intro_step);
    memcpy(s_master_name, p->name, MASTER_NAME_LEN);
    s_master_name[MASTER_NAME_LEN - 1] = '\0';   // remember the master name (shown on the info page)
}

// Master side: received a slave presence -> record/refresh the online slave
static void handle_presence(const uint8_t *mac, const espnow_presence_t *pr) {
    if (!mac) return;
    int free_idx = -1, match = -1, oldest = 0;
    for (int i = 0; i < MG_MAX_SLAVES; i++) {
        if (s_slaves[i].last_us != 0 && memcmp(s_slaves[i].mac, mac, 6) == 0) { match = i; break; }
        if (s_slaves[i].last_us == 0 && free_idx < 0) free_idx = i;
        if (s_slaves[i].last_us < s_slaves[oldest].last_us) oldest = i;
    }
    int idx = (match >= 0) ? match : (free_idx >= 0 ? free_idx : oldest);
    memcpy(s_slaves[idx].mac, mac, 6);
    s_slaves[idx].position = pr->position;
    s_slaves[idx].last_us = esp_timer_get_time();
}

// Slave side: received the master's OBD packet -> write the cache
static void handle_obd(const espnow_obd_packet_t *p) {
    int64_t now_us = esp_timer_get_time();
    bool stale_source = s_have_rx_seq && s_last_rx_us != 0 && (now_us - s_last_rx_us) > 2000000;
    if (!p || (s_have_rx_seq && !stale_source && !seq_is_newer(p->seq, s_last_rx_seq))) {
        log_drop_sampled("duplicate/out-of-order OBD", &s_drop_duplicate);
        return;
    }
    s_have_rx_seq = true;
    s_last_rx_seq = p->seq;
    s_last_rx_us = esp_timer_get_time();
    apply_packet(p);
}

static void handle_tpms(const espnow_tpms_packet_t *p)
{
    if (!p) return;
    uint16_t expected_crc = packet_crc16((const uint8_t *)p, sizeof(*p) - sizeof(p->crc16));
    if (p->crc16 != expected_crc) {
        log_drop_sampled("TPMS integrity failure", &s_drop_integrity);
        return;
    }
    bool stale_source = s_have_tpms_seq && s_last_tpms_rx_us != 0 &&
                        (esp_timer_get_time() - s_last_tpms_rx_us) > 2000000;
    if (s_have_tpms_seq && !stale_source && !seq_is_newer(p->seq, s_last_tpms_seq)) {
        log_drop_sampled("duplicate/out-of-order TPMS", &s_drop_duplicate);
        return;
    }
    s_have_tpms_seq = true;
    s_last_tpms_seq = p->seq;
    s_last_tpms_rx_us = esp_timer_get_time();
    for (uint8_t i = 0; i < OBD_TPMS_WHEEL_COUNT; ++i) {
        if (p->valid_mask & (uint8_t)(1u << i)) {
            obd_tpms_cache_set((obd_tpms_wheel_t)i,
                               (float)p->pressure_bar_x100[i] / 100.0f,
                               esp_timer_get_time());
        } else {
            obd_tpms_cache_invalidate((obd_tpms_wheel_t)i);
        }
    }
}

// Linked control packet:
//   master receives TEST_START -> start the RPM ramp; receives THRESH_SET -> send event (UI task writes NVS + relays)
//   slave receives THRESH_SET  -> send event (UI task writes NVS, no relay); TEST is master-driven, slave ignores it
static void handle_ctrl(const espnow_ctrl_packet_t *c) {
    if (c->cmd == ESPNOW_CTRL_TEST_START) {
        if (s_is_master) {
            s_linktest_start_us = esp_timer_get_time();
            s_linktest_active = true;
            ESP_LOGI(TAG, "Linked test started (ctrl from slave)");
        }
    } else if (c->cmd == ESPNOW_CTRL_THRESH_SET) {
        app_event_send(APP_EVT_ESPNOW_THRESH_SYNC, (uint32_t)c->arg);
    }
}

static void handle_rx(const uint8_t *mac, const uint8_t *data, int len) {
    if (!mac || !data || len <= 0) {
        log_drop_sampled("missing source or payload", &s_drop_header);
        return;
    }
    if (len == (int)sizeof(espnow_obd_packet_t)) {
        if (s_is_master) return;   // the master does not process OBD packets
        const espnow_obd_packet_t *p = (const espnow_obd_packet_t *)data;
        if (p->magic == ESPNOW_MAGIC && p->version == ESPNOW_VER) handle_obd(p);
        else log_drop_sampled("invalid OBD header", &s_drop_header);
    } else if (len == (int)sizeof(espnow_tpms_packet_t)) {
        if (s_is_master) return;
        const espnow_tpms_packet_t *p = (const espnow_tpms_packet_t *)data;
        if (p->magic == ESPNOW_MAGIC && p->version == ESPNOW_TPMS_VER &&
            p->packet_type == ESPNOW_PACKET_TPMS) handle_tpms(p);
        else log_drop_sampled("invalid TPMS header", &s_drop_header);
    } else if (len == (int)sizeof(espnow_ctrl_packet_t)) {
        const espnow_ctrl_packet_t *c = (const espnow_ctrl_packet_t *)data;
        if (c->magic == ESPNOW_MAGIC && c->version == ESPNOW_VER) handle_ctrl(c);
        else log_drop_sampled("invalid control header", &s_drop_header);
    } else if (len == (int)sizeof(espnow_presence_t)) {
        if (!s_is_master) return;  // only the master tallies slaves
        const espnow_presence_t *pr = (const espnow_presence_t *)data;
        if (pr->magic == ESPNOW_MAGIC && pr->version == ESPNOW_VER) handle_presence(mac, pr);
        else log_drop_sampled("invalid presence header", &s_drop_header);
    }
}

// The recv callback signature changed in IDF 5.0; support both versions.
#if ESP_IDF_VERSION >= ESP_IDF_VERSION_VAL(5, 0, 0)
static void recv_cb(const esp_now_recv_info_t *info, const uint8_t *data, int len) {
    // Slave MAC filter: once bound to a master MAC, only accept packets from that MAC.
    if (!s_is_master && info) {
        nvs_user_cfg_t cfg = {0};
        nvs_cfg_get_snapshot(&cfg);
        if (cfg.espnow_master_mac[0] != 0) {  // bound
            bool mac_match = true;
            for (int i = 0; i < 6; i++) {
                if (info->src_addr[i] != cfg.espnow_master_mac[i]) {
                    mac_match = false;
                    break;
                }
            }
            if (!mac_match) return;  // ignore packets from other masters
        } else {
            /* Explicit compatibility mode for legacy installations that have
             * not paired a master MAC yet. New installations should bind. */
            static bool logged_compat = false;
            if (!logged_compat) {
                ESP_LOGW(TAG, "ESP-NOW slave is unbound; accepting broadcast compatibility mode");
                logged_compat = true;
            }
        }
    }
    handle_rx(info ? info->src_addr : NULL, data, len);
}
#else
static void recv_cb(const uint8_t *mac, const uint8_t *data, int len) {
    // Slave MAC filter: once bound to a master MAC, only accept packets from that MAC.
    if (!s_is_master && mac) {
        nvs_user_cfg_t cfg = {0};
        nvs_cfg_get_snapshot(&cfg);
        if (cfg.espnow_master_mac[0] != 0) {  // bound
            bool mac_match = true;
            for (int i = 0; i < 6; i++) {
                if (mac[i] != cfg->espnow_master_mac[i]) {
                    mac_match = false;
                    break;
                }
            }
            if (!mac_match) return;  // ignore packets from other masters
        } else {
            static bool logged_compat = false;
            if (!logged_compat) {
                ESP_LOGW(TAG, "ESP-NOW slave is unbound; accepting broadcast compatibility mode");
                logged_compat = true;
            }
        }
    }
    handle_rx(mac, data, len);
}
#endif

// Slave: periodically broadcast presence (including this gauge's position) for the master's handshake tally
static void slave_presence_task(void *arg) {
    espnow_presence_t pr = { .magic = ESPNOW_MAGIC, .version = ESPNOW_VER };
    for (;;) {
        pr.position = nvs_device_position_get();
        esp_now_send(s_broadcast_mac, (const uint8_t *)&pr, sizeof(pr));
        vTaskDelay(pdMS_TO_TICKS(PRESENCE_INTERVAL_MS));
    }
}

void espnow_link_start_slave(void) {
    wifi_espnow_init();
    s_is_master = false;
    s_have_rx_seq = false;
    s_have_tpms_seq = false;
    s_last_rx_us = 0;
    s_last_tpms_rx_us = 0;
    obd_tpms_cache_reset();
    // A slave also needs the broadcast peer to be able to send presence
    esp_now_peer_info_t peer = {0};
    memcpy(peer.peer_addr, s_broadcast_mac, 6);
    peer.channel = ESPNOW_CHANNEL;
    peer.ifidx   = WIFI_IF_STA;
    peer.encrypt = false;
    ESP_ERROR_CHECK(esp_now_add_peer(&peer));
    ESP_ERROR_CHECK(esp_now_register_recv_cb(recv_cb));
    xTaskCreate(slave_presence_task, "espnow_pres", 2560, NULL, 4, &s_presence_task_handle);
    ESP_LOGI(TAG, "ESP-NOW SLAVE up (listening ch%d, presence %dms)", ESPNOW_CHANNEL, PRESENCE_INTERVAL_MS);
}

bool espnow_link_slave_has_data(void) {
    if (s_last_rx_us == 0) return false;
    bool online = (esp_timer_get_time() - s_last_rx_us) < 2000000;
    if (!online) obd_tpms_cache_reset();
    return online; // data within 2s counts as online
}

const char *espnow_link_get_master_name(void) {
    return s_master_name;   // empty string = no master data received yet
}

// Slave: MAC of the currently bound master (all-zero = unbound)
const uint8_t *espnow_link_get_bound_master_mac(void) {
    static uint8_t mac_snapshot[6];
    nvs_user_cfg_t cfg = {0};
    if (nvs_cfg_get_snapshot(&cfg) == ESP_OK) memcpy(mac_snapshot, cfg.espnow_master_mac, sizeof(mac_snapshot));
    return mac_snapshot;
}

// Slave: bind to a specific master MAC (the ESP-NOW MAC read during BLE pairing)
void espnow_link_bind_master(const uint8_t mac[6]) {
    if (!mac) return;
    nvs_user_cfg_t cfg = {0};
    if (nvs_cfg_get_snapshot(&cfg) != ESP_OK) return;
    memcpy(cfg.espnow_master_mac, mac, 6);
    nvs_cfg_set(&cfg);
    ESP_LOGI(TAG, "Bound to master MAC: %02x:%02x:%02x:%02x:%02x:%02x",
             cfg.espnow_master_mac[0], cfg.espnow_master_mac[1], cfg.espnow_master_mac[2],
             cfg.espnow_master_mac[3], cfg.espnow_master_mac[4], cfg.espnow_master_mac[5]);
}

// Slave: unbind the master (return to accept-any mode)
void espnow_link_unbind_master(void) {
    nvs_user_cfg_t cfg = {0};
    if (nvs_cfg_get_snapshot(&cfg) != ESP_OK) return;
    memset(cfg.espnow_master_mac, 0, 6);
    nvs_cfg_set(&cfg);
    ESP_LOGI(TAG, "Unbound master MAC (receive from any master)");
}

// Master: number of slaves currently online (reported within the last MG_SLAVE_TIMEOUT_US)
uint8_t espnow_master_online_slaves(void) {
    int64_t now = esp_timer_get_time();
    uint8_t n = 0;
    for (int i = 0; i < MG_MAX_SLAVES; i++) {
        if (s_slaves[i].last_us != 0 && (now - s_slaves[i].last_us) < MG_SLAVE_TIMEOUT_US) n++;
    }
    return n;
}

// ========================= Multi-gauge linked sync =========================
// Trigger the linked test: the master starts the RPM ramp directly; a slave sends a request to the
// master, which drives it centrally (all gauges stay in sync).
void espnow_link_trigger_linked_test(void) {
    if (s_is_master) {
        s_linktest_start_us = esp_timer_get_time();
        s_linktest_active = true;
        ESP_LOGI(TAG, "Linked test started (local)");
    } else {
        espnow_ctrl_packet_t c = { .magic = ESPNOW_MAGIC, .version = ESPNOW_VER,
                                   .cmd = ESPNOW_CTRL_TEST_START, .arg = 0 };
        esp_now_send(s_broadcast_mac, (const uint8_t *)&c, sizeof(c));
    }
}

// The local user changed the threshold -> broadcast it to the other gauges. When the master
// receives such a packet from a slave it relays it, covering all slaves.
void espnow_link_broadcast_threshold(uint16_t thresh) {
    espnow_ctrl_packet_t c = { .magic = ESPNOW_MAGIC, .version = ESPNOW_VER,
                               .cmd = ESPNOW_CTRL_THRESH_SET, .arg = thresh };
    esp_now_send(s_broadcast_mac, (const uint8_t *)&c, sizeof(c));
}

// Whether a linked test is in progress: master = local ramp state, slave = the last flag received
// from the master's broadcast. During TEST a gauge takes part in the gradient rendering even if it
// has LINKED FLASH turned off, guaranteeing "TEST on any gauge syncs all gauges".
bool espnow_link_linktest_active(void) {
    return s_is_master ? s_linktest_active : s_rx_linktest;
}

// Whether rpm_warn_linked_en is active on the master: master = local NVS, slave = mirrored from broadcast flags bit2.
// Slaves use this so the gradient fires without needing manual NVS config on each slave unit.
bool espnow_link_linked_en(void) {
    if (!s_is_master) return s_rx_linked_en;
    nvs_user_cfg_t cfg = {0};
    nvs_cfg_get_snapshot(&cfg);
    return cfg.rpm_warn_linked_en != 0;
}

// Apply a threshold synced from another gauge (called by the UI task): write local NVS; the master
// additionally relays it to the other slaves. ESP-NOW does not loop back one's own sends, so the
// relay cannot form a loop.
void espnow_link_apply_synced_threshold(uint16_t thresh) {
    nvs_user_cfg_t cfg = {0};
    if (nvs_cfg_get_snapshot(&cfg) != ESP_OK) return;
    if (cfg.rpm_warn_threshold != thresh) {
        cfg.rpm_warn_threshold = thresh;
        nvs_cfg_set(&cfg);
    }
    if (s_is_master) {
        espnow_link_broadcast_threshold(thresh);
    }
}

static void delete_link_task(TaskHandle_t *handle)
{
    if (handle && *handle) {
        vTaskDelete(*handle);
        *handle = NULL;
    }
}

static void stop_link_tasks(void)
{
    delete_link_task(&s_master_task_handle);
    delete_link_task(&s_linktest_task_handle);
    delete_link_task(&s_presence_task_handle);
    s_linktest_active = false;
    s_rx_linktest = false;
    obd_data_rpm_override_set(false, 0);
}

// Quiesce ESP-NOW for OTA without stopping/deinitializing the WiFi driver.
// OTA can then reuse the already-running WiFi stack for its SoftAP, while the
// 10 Hz master broadcast (or slave presence traffic) no longer competes with
// the TCP upload on the ESP32-S3's single 2.4 GHz radio.
void espnow_link_pause_for_ota(void)
{
    stop_link_tasks();

    if (!s_espnow_started) {
        ESP_LOGI(TAG, "ESP-NOW already inactive for OTA");
        return;
    }

    ESP_LOGI(TAG, "Pausing ESP-NOW for OTA (keeping WiFi initialized)");
    esp_now_unregister_recv_cb();
    esp_now_unregister_send_cb();

    esp_err_t err = esp_now_deinit();
    if (err != ESP_OK) {
        ESP_LOGW(TAG, "esp_now_deinit during OTA pause failed: %s", esp_err_to_name(err));
        return;
    }
    s_espnow_started = false;
    ESP_LOGI(TAG, "ESP-NOW paused; WiFi remains available for OTA SoftAP");
}

// Stop ESP-NOW and release WiFi resources.
// After calling this, espnow_link_start_master/slave can be called again to restart.
void espnow_link_stop(void) {
    if (!s_espnow_started && !s_wifi_initialized) {
        ESP_LOGI(TAG, "ESP-NOW not started, nothing to stop");
        return;
    }

    ESP_LOGI(TAG, "Stopping ESP-NOW...");
    stop_link_tasks();

    // Unregister callbacks before deinitializing ESP-NOW.
    if (s_espnow_started) {
        esp_now_unregister_recv_cb();
        esp_now_unregister_send_cb();
        esp_err_t err = esp_now_deinit();
        if (err != ESP_OK) {
            ESP_LOGW(TAG, "esp_now_deinit failed: %s", esp_err_to_name(err));
        }
        s_espnow_started = false;
    }

    // Stop and deinit WiFi
    if (s_wifi_initialized) {
        esp_err_t err = esp_wifi_stop();
        if (err != ESP_OK && err != ESP_ERR_WIFI_NOT_STARTED) {
            ESP_LOGW(TAG, "esp_wifi_stop failed: %s", esp_err_to_name(err));
        }

        err = esp_wifi_deinit();
        if (err != ESP_OK && err != ESP_ERR_WIFI_NOT_INIT) {
            ESP_LOGW(TAG, "esp_wifi_deinit failed: %s", esp_err_to_name(err));
        }
        s_wifi_initialized = false;
    }

    s_is_master = false;
    ESP_LOGI(TAG, "ESP-NOW stopped");
}
