omniscientjoker/obd_brz_gauge/main/bsp_obd_dsp/lcd_driver/ST77916.c

#include "bsp_obd_dsp/lcd_driver/ST77916.h"


#define LCD_OPCODE_WRITE_CMD        (0x02ULL)
#define LCD_OPCODE_READ_CMD         (0x0BULL)
#define LCD_OPCODE_WRITE_COLOR      (0x32ULL)

static const char *TAG_LCD = "ST77916";

esp_lcd_panel_handle_t panel_handle = NULL;

/* LVGL flush-complete callback (optional; set via LCD_SetFlushCallback before LCD_Init) */
static bool (*s_flush_cb)(esp_lcd_panel_io_handle_t, esp_lcd_panel_io_event_data_t *, void *) = NULL;
static void *s_flush_ctx = NULL;

void LCD_SetFlushCallback(bool (*cb)(esp_lcd_panel_io_handle_t, esp_lcd_panel_io_event_data_t *, void *), void *ctx)
{
    s_flush_cb = cb;
    s_flush_ctx = ctx;
}


/* v2 init sequence (default for V1 board; new board B under V3).
   Used by every build except V2_NEW, so guard against -Wunused-const-variable. */
#if CONFIG_OBD_HW_VERSION_V1_WAVESHARE
static const st77916_lcd_init_cmd_t vendor_specific_init_new[] = {
  {0xF0, (uint8_t []){0x28}, 1, 0},
  {0xF2, (uint8_t []){0x28}, 1, 0},
  {0x73, (uint8_t []){0xF0}, 1, 0},
  {0x7C, (uint8_t []){0xD1}, 1, 0},
  {0x83, (uint8_t []){0xE0}, 1, 0},
  {0x84, (uint8_t []){0x61}, 1, 0},
  {0xF2, (uint8_t []){0x82}, 1, 0},
  {0xF0, (uint8_t []){0x00}, 1, 0},
  {0xF0, (uint8_t []){0x01}, 1, 0},
  {0xF1, (uint8_t []){0x01}, 1, 0},
  {0xB0, (uint8_t []){0x56}, 1, 0},
  {0xB1, (uint8_t []){0x4D}, 1, 0},
  {0xB2, (uint8_t []){0x24}, 1, 0},
  {0xB4, (uint8_t []){0x87}, 1, 0},
  {0xB5, (uint8_t []){0x44}, 1, 0},
  {0xB6, (uint8_t []){0x8B}, 1, 0},
  {0xB7, (uint8_t []){0x40}, 1, 0},
  {0xB8, (uint8_t []){0x86}, 1, 0},
  {0xBA, (uint8_t []){0x00}, 1, 0},
  {0xBB, (uint8_t []){0x08}, 1, 0},
  {0xBC, (uint8_t []){0x08}, 1, 0},
  {0xBD, (uint8_t []){0x00}, 1, 0},
  {0xC0, (uint8_t []){0x80}, 1, 0},
  {0xC1, (uint8_t []){0x10}, 1, 0},
  {0xC2, (uint8_t []){0x37}, 1, 0},
  {0xC3, (uint8_t []){0x80}, 1, 0},
  {0xC4, (uint8_t []){0x10}, 1, 0},
  {0xC5, (uint8_t []){0x37}, 1, 0},
  {0xC6, (uint8_t []){0xA9}, 1, 0},
  {0xC7, (uint8_t []){0x41}, 1, 0},
  {0xC8, (uint8_t []){0x01}, 1, 0},
  {0xC9, (uint8_t []){0xA9}, 1, 0},
  {0xCA, (uint8_t []){0x41}, 1, 0},
  {0xCB, (uint8_t []){0x01}, 1, 0},
  {0xD0, (uint8_t []){0x91}, 1, 0},
  {0xD1, (uint8_t []){0x68}, 1, 0},
  {0xD2, (uint8_t []){0x68}, 1, 0},
  {0xF5, (uint8_t []){0x00, 0xA5}, 2, 0},
  {0xDD, (uint8_t []){0x4F}, 1, 0},
  {0xDE, (uint8_t []){0x4F}, 1, 0},
  {0xF1, (uint8_t []){0x10}, 1, 0},
  {0xF0, (uint8_t []){0x00}, 1, 0},
  {0xF0, (uint8_t []){0x02}, 1, 0},
  {0xE0, (uint8_t []){0xF0, 0x0A, 0x10, 0x09, 0x09, 0x36, 0x35, 0x33, 0x4A, 0x29, 0x15, 0x15, 0x2E, 0x34}, 14, 0},
  {0xE1, (uint8_t []){0xF0, 0x0A, 0x0F, 0x08, 0x08, 0x05, 0x34, 0x33, 0x4A, 0x39, 0x15, 0x15, 0x2D, 0x33}, 14, 0},
  {0xF0, (uint8_t []){0x10}, 1, 0},
  {0xF3, (uint8_t []){0x10}, 1, 0},
  {0xE0, (uint8_t []){0x07}, 1, 0},
  {0xE1, (uint8_t []){0x00}, 1, 0},
  {0xE2, (uint8_t []){0x00}, 1, 0},
  {0xE3, (uint8_t []){0x00}, 1, 0},
  {0xE4, (uint8_t []){0xE0}, 1, 0},
  {0xE5, (uint8_t []){0x06}, 1, 0},
  {0xE6, (uint8_t []){0x21}, 1, 0},
  {0xE7, (uint8_t []){0x01}, 1, 0},
  {0xE8, (uint8_t []){0x05}, 1, 0},
  {0xE9, (uint8_t []){0x02}, 1, 0},
  {0xEA, (uint8_t []){0xDA}, 1, 0},
  {0xEB, (uint8_t []){0x00}, 1, 0},
  {0xEC, (uint8_t []){0x00}, 1, 0},
  {0xED, (uint8_t []){0x0F}, 1, 0},
  {0xEE, (uint8_t []){0x00}, 1, 0},
  {0xEF, (uint8_t []){0x00}, 1, 0},
  {0xF8, (uint8_t []){0x00}, 1, 0},
  {0xF9, (uint8_t []){0x00}, 1, 0},
  {0xFA, (uint8_t []){0x00}, 1, 0},
  {0xFB, (uint8_t []){0x00}, 1, 0},
  {0xFC, (uint8_t []){0x00}, 1, 0},
  {0xFD, (uint8_t []){0x00}, 1, 0},
  {0xFE, (uint8_t []){0x00}, 1, 0},
  {0xFF, (uint8_t []){0x00}, 1, 0},
  {0x60, (uint8_t []){0x40}, 1, 0},
  {0x61, (uint8_t []){0x04}, 1, 0},
  {0x62, (uint8_t []){0x00}, 1, 0},
  {0x63, (uint8_t []){0x42}, 1, 0},
  {0x64, (uint8_t []){0xD9}, 1, 0},
  {0x65, (uint8_t []){0x00}, 1, 0},
  {0x66, (uint8_t []){0x00}, 1, 0},
  {0x67, (uint8_t []){0x00}, 1, 0},
  {0x68, (uint8_t []){0x00}, 1, 0},
  {0x69, (uint8_t []){0x00}, 1, 0},
  {0x6A, (uint8_t []){0x00}, 1, 0},
  {0x6B, (uint8_t []){0x00}, 1, 0},
  {0x70, (uint8_t []){0x40}, 1, 0},
  {0x71, (uint8_t []){0x03}, 1, 0},
  {0x72, (uint8_t []){0x00}, 1, 0},
  {0x73, (uint8_t []){0x42}, 1, 0},
  {0x74, (uint8_t []){0xD8}, 1, 0},
  {0x75, (uint8_t []){0x00}, 1, 0},
  {0x76, (uint8_t []){0x00}, 1, 0},
  {0x77, (uint8_t []){0x00}, 1, 0},
  {0x78, (uint8_t []){0x00}, 1, 0},
  {0x79, (uint8_t []){0x00}, 1, 0},
  {0x7A, (uint8_t []){0x00}, 1, 0},
  {0x7B, (uint8_t []){0x00}, 1, 0},
  {0x80, (uint8_t []){0x48}, 1, 0},
  {0x81, (uint8_t []){0x00}, 1, 0},
  {0x82, (uint8_t []){0x06}, 1, 0},
  {0x83, (uint8_t []){0x02}, 1, 0},
  {0x84, (uint8_t []){0xD6}, 1, 0},
  {0x85, (uint8_t []){0x04}, 1, 0},
  {0x86, (uint8_t []){0x00}, 1, 0},
  {0x87, (uint8_t []){0x00}, 1, 0},
  {0x88, (uint8_t []){0x48}, 1, 0},
  {0x89, (uint8_t []){0x00}, 1, 0},
  {0x8A, (uint8_t []){0x08}, 1, 0},
  {0x8B, (uint8_t []){0x02}, 1, 0},
  {0x8C, (uint8_t []){0xD8}, 1, 0},
  {0x8D, (uint8_t []){0x04}, 1, 0},
  {0x8E, (uint8_t []){0x00}, 1, 0},
  {0x8F, (uint8_t []){0x00}, 1, 0},
  {0x90, (uint8_t []){0x48}, 1, 0},
  {0x91, (uint8_t []){0x00}, 1, 0},
  {0x92, (uint8_t []){0x0A}, 1, 0},
  {0x93, (uint8_t []){0x02}, 1, 0},
  {0x94, (uint8_t []){0xDA}, 1, 0},
  {0x95, (uint8_t []){0x04}, 1, 0},
  {0x96, (uint8_t []){0x00}, 1, 0},
  {0x97, (uint8_t []){0x00}, 1, 0},
  {0x98, (uint8_t []){0x48}, 1, 0},
  {0x99, (uint8_t []){0x00}, 1, 0},
  {0x9A, (uint8_t []){0x0C}, 1, 0},
  {0x9B, (uint8_t []){0x02}, 1, 0},
  {0x9C, (uint8_t []){0xDC}, 1, 0},
  {0x9D, (uint8_t []){0x04}, 1, 0},
  {0x9E, (uint8_t []){0x00}, 1, 0},
  {0x9F, (uint8_t []){0x00}, 1, 0},
  {0xA0, (uint8_t []){0x48}, 1, 0},
  {0xA1, (uint8_t []){0x00}, 1, 0},
  {0xA2, (uint8_t []){0x05}, 1, 0},
  {0xA3, (uint8_t []){0x02}, 1, 0},
  {0xA4, (uint8_t []){0xD5}, 1, 0},
  {0xA5, (uint8_t []){0x04}, 1, 0},
  {0xA6, (uint8_t []){0x00}, 1, 0},
  {0xA7, (uint8_t []){0x00}, 1, 0},
  {0xA8, (uint8_t []){0x48}, 1, 0},
  {0xA9, (uint8_t []){0x00}, 1, 0},
  {0xAA, (uint8_t []){0x07}, 1, 0},
  {0xAB, (uint8_t []){0x02}, 1, 0},
  {0xAC, (uint8_t []){0xD7}, 1, 0},
  {0xAD, (uint8_t []){0x04}, 1, 0},
  {0xAE, (uint8_t []){0x00}, 1, 0},
  {0xAF, (uint8_t []){0x00}, 1, 0},
  {0xB0, (uint8_t []){0x48}, 1, 0},
  {0xB1, (uint8_t []){0x00}, 1, 0},
  {0xB2, (uint8_t []){0x09}, 1, 0},
  {0xB3, (uint8_t []){0x02}, 1, 0},
  {0xB4, (uint8_t []){0xD9}, 1, 0},
  {0xB5, (uint8_t []){0x04}, 1, 0},
  {0xB6, (uint8_t []){0x00}, 1, 0},
  {0xB7, (uint8_t []){0x00}, 1, 0},
  
  {0xB8, (uint8_t []){0x48}, 1, 0},
  {0xB9, (uint8_t []){0x00}, 1, 0},
  {0xBA, (uint8_t []){0x0B}, 1, 0},
  {0xBB, (uint8_t []){0x02}, 1, 0},
  {0xBC, (uint8_t []){0xDB}, 1, 0},
  {0xBD, (uint8_t []){0x04}, 1, 0},
  {0xBE, (uint8_t []){0x00}, 1, 0},
  {0xBF, (uint8_t []){0x00}, 1, 0},
  {0xC0, (uint8_t []){0x10}, 1, 0},
  {0xC1, (uint8_t []){0x47}, 1, 0},
  {0xC2, (uint8_t []){0x56}, 1, 0},
  {0xC3, (uint8_t []){0x65}, 1, 0},
  {0xC4, (uint8_t []){0x74}, 1, 0},
  {0xC5, (uint8_t []){0x88}, 1, 0},
  {0xC6, (uint8_t []){0x99}, 1, 0},
  {0xC7, (uint8_t []){0x01}, 1, 0},
  {0xC8, (uint8_t []){0xBB}, 1, 0},
  {0xC9, (uint8_t []){0xAA}, 1, 0},
  {0xD0, (uint8_t []){0x10}, 1, 0},
  {0xD1, (uint8_t []){0x47}, 1, 0},
  {0xD2, (uint8_t []){0x56}, 1, 0},
  {0xD3, (uint8_t []){0x65}, 1, 0},
  {0xD4, (uint8_t []){0x74}, 1, 0},
  {0xD5, (uint8_t []){0x88}, 1, 0},
  {0xD6, (uint8_t []){0x99}, 1, 0},
  {0xD7, (uint8_t []){0x01}, 1, 0},
  {0xD8, (uint8_t []){0xBB}, 1, 0},
  {0xD9, (uint8_t []){0xAA}, 1, 0},
  {0xF3, (uint8_t []){0x01}, 1, 0},
  {0xF0, (uint8_t []){0x00}, 1, 0},
  {0x21, (uint8_t []){0x00}, 1, 0},
  {0x11, (uint8_t []){0x00}, 1, 120},
  {0x29, (uint8_t []){0x00}, 1, 0},  
};
#endif

#if CONFIG_OBD_HW_VERSION_V2_NEW
/* v1 init sequence (new board A, selected when CONFIG_OBD_HW_VERSION_V2_NEW=1).
   Source: tools/te.cpp lcd_init_cmd_v1 (identical to tools/scr_st77916.h lcd_init_cmd_v1). */
static const st77916_lcd_init_cmd_t vendor_specific_init_new[] = {
  {0xF0, (uint8_t []){0x08}, 1, 0},
  {0xF2, (uint8_t []){0x08}, 1, 0},
  {0x9B, (uint8_t []){0x51}, 1, 0},
  {0x86, (uint8_t []){0x53}, 1, 0},
  {0xF2, (uint8_t []){0x80}, 1, 0},
  {0xF0, (uint8_t []){0x00}, 1, 0},
  {0xF0, (uint8_t []){0x01}, 1, 0},
  {0xF1, (uint8_t []){0x01}, 1, 0},
  {0xB0, (uint8_t []){0x54}, 1, 0},
  {0xB1, (uint8_t []){0x3F}, 1, 0},
  {0xB2, (uint8_t []){0x2A}, 1, 0},
  {0xB4, (uint8_t []){0x46}, 1, 0},
  {0xB5, (uint8_t []){0x34}, 1, 0},
  {0xB6, (uint8_t []){0xD5}, 1, 0},
  {0xB7, (uint8_t []){0x30}, 1, 0},
  {0xBA, (uint8_t []){0x00}, 1, 0},
  {0xBB, (uint8_t []){0x08}, 1, 0},
  {0xBC, (uint8_t []){0x08}, 1, 0},
  {0xBD, (uint8_t []){0x00}, 1, 0},
  {0xC0, (uint8_t []){0x80}, 1, 0},
  {0xC1, (uint8_t []){0x10}, 1, 0},
  {0xC2, (uint8_t []){0x37}, 1, 0},
  {0xC3, (uint8_t []){0x80}, 1, 0},
  {0xC4, (uint8_t []){0x10}, 1, 0},
  {0xC5, (uint8_t []){0x37}, 1, 0},
  {0xC6, (uint8_t []){0xA9}, 1, 0},
  {0xC7, (uint8_t []){0x41}, 1, 0},
  {0xC8, (uint8_t []){0x51}, 1, 0},
  {0xC9, (uint8_t []){0xA9}, 1, 0},
  {0xCA, (uint8_t []){0x41}, 1, 0},
  {0xCB, (uint8_t []){0x51}, 1, 0},
  {0xD0, (uint8_t []){0x91}, 1, 0},
  {0xD1, (uint8_t []){0x68}, 1, 0},
  {0xD2, (uint8_t []){0x69}, 1, 0},
  {0xF5, (uint8_t []){0x00, 0xA5}, 2, 0},
  {0xDD, (uint8_t []){0x3F}, 1, 0},
  {0xDE, (uint8_t []){0x3F}, 1, 0},
  {0xF1, (uint8_t []){0x10}, 1, 0},
  {0xF0, (uint8_t []){0x00}, 1, 0},
  {0xF0, (uint8_t []){0x02}, 1, 0},
  {0xE0, (uint8_t []){0x70, 0x09, 0x12, 0x0C, 0x0B, 0x27, 0x38, 0x54, 0x4E, 0x19, 0x15, 0x15, 0x2C, 0x2F}, 14, 0},
  {0xE1, (uint8_t []){0x70, 0x08, 0x11, 0x0C, 0x0B, 0x27, 0x38, 0x43, 0x4C, 0x18, 0x14, 0x14, 0x2B, 0x2D}, 14, 0},
  {0xF0, (uint8_t []){0x10}, 1, 0},
  {0xF3, (uint8_t []){0x10}, 1, 0},
  {0xE0, (uint8_t []){0x08}, 1, 0},
  {0xE1, (uint8_t []){0x00}, 1, 0},
  {0xE2, (uint8_t []){0x00}, 1, 0},
  {0xE3, (uint8_t []){0x00}, 1, 0},
  {0xE4, (uint8_t []){0xE0}, 1, 0},
  {0xE5, (uint8_t []){0x06}, 1, 0},
  {0xE6, (uint8_t []){0x21}, 1, 0},
  {0xE7, (uint8_t []){0x00}, 1, 0},
  {0xE8, (uint8_t []){0x05}, 1, 0},
  {0xE9, (uint8_t []){0x82}, 1, 0},
  {0xEA, (uint8_t []){0xDF}, 1, 0},
  {0xEB, (uint8_t []){0x89}, 1, 0},
  {0xEC, (uint8_t []){0x20}, 1, 0},
  {0xED, (uint8_t []){0x14}, 1, 0},
  {0xEE, (uint8_t []){0xFF}, 1, 0},
  {0xEF, (uint8_t []){0x00}, 1, 0},
  {0xF8, (uint8_t []){0xFF}, 1, 0},
  {0xF9, (uint8_t []){0x00}, 1, 0},
  {0xFA, (uint8_t []){0x00}, 1, 0},
  {0xFB, (uint8_t []){0x30}, 1, 0},
  {0xFC, (uint8_t []){0x00}, 1, 0},
  {0xFD, (uint8_t []){0x00}, 1, 0},
  {0xFE, (uint8_t []){0x00}, 1, 0},
  {0xFF, (uint8_t []){0x00}, 1, 0},
  {0x60, (uint8_t []){0x42}, 1, 0},
  {0x61, (uint8_t []){0xE0}, 1, 0},
  {0x62, (uint8_t []){0x40}, 1, 0},
  {0x63, (uint8_t []){0x40}, 1, 0},
  {0x64, (uint8_t []){0x02}, 1, 0},
  {0x65, (uint8_t []){0x00}, 1, 0},
  {0x66, (uint8_t []){0x40}, 1, 0},
  {0x67, (uint8_t []){0x03}, 1, 0},
  {0x68, (uint8_t []){0x00}, 1, 0},
  {0x69, (uint8_t []){0x00}, 1, 0},
  {0x6A, (uint8_t []){0x00}, 1, 0},
  {0x6B, (uint8_t []){0x00}, 1, 0},
  {0x70, (uint8_t []){0x42}, 1, 0},
  {0x71, (uint8_t []){0xE0}, 1, 0},
  {0x72, (uint8_t []){0x40}, 1, 0},
  {0x73, (uint8_t []){0x40}, 1, 0},
  {0x74, (uint8_t []){0x02}, 1, 0},
  {0x75, (uint8_t []){0x00}, 1, 0},
  {0x76, (uint8_t []){0x40}, 1, 0},
  {0x77, (uint8_t []){0x03}, 1, 0},
  {0x78, (uint8_t []){0x00}, 1, 0},
  {0x79, (uint8_t []){0x00}, 1, 0},
  {0x7A, (uint8_t []){0x00}, 1, 0},
  {0x7B, (uint8_t []){0x00}, 1, 0},
  {0x80, (uint8_t []){0x48}, 1, 0},
  {0x81, (uint8_t []){0x00}, 1, 0},
  {0x82, (uint8_t []){0x05}, 1, 0},
  {0x83, (uint8_t []){0x02}, 1, 0},
  {0x84, (uint8_t []){0xDD}, 1, 0},
  {0x85, (uint8_t []){0x00}, 1, 0},
  {0x86, (uint8_t []){0x00}, 1, 0},
  {0x87, (uint8_t []){0x00}, 1, 0},
  {0x88, (uint8_t []){0x48}, 1, 0},
  {0x89, (uint8_t []){0x00}, 1, 0},
  {0x8A, (uint8_t []){0x07}, 1, 0},
  {0x8B, (uint8_t []){0x02}, 1, 0},
  {0x8C, (uint8_t []){0xDF}, 1, 0},
  {0x8D, (uint8_t []){0x00}, 1, 0},
  {0x8E, (uint8_t []){0x00}, 1, 0},
  {0x8F, (uint8_t []){0x00}, 1, 0},
  {0x90, (uint8_t []){0x48}, 1, 0},
  {0x91, (uint8_t []){0x00}, 1, 0},
  {0x92, (uint8_t []){0x09}, 1, 0},
  {0x93, (uint8_t []){0x02}, 1, 0},
  {0x94, (uint8_t []){0xE1}, 1, 0},
  {0x95, (uint8_t []){0x00}, 1, 0},
  {0x96, (uint8_t []){0x00}, 1, 0},
  {0x97, (uint8_t []){0x00}, 1, 0},
  {0x98, (uint8_t []){0x48}, 1, 0},
  {0x99, (uint8_t []){0x00}, 1, 0},
  {0x9A, (uint8_t []){0x0B}, 1, 0},
  {0x9B, (uint8_t []){0x02}, 1, 0},
  {0x9C, (uint8_t []){0xE3}, 1, 0},
  {0x9D, (uint8_t []){0x00}, 1, 0},
  {0x9E, (uint8_t []){0x00}, 1, 0},
  {0x9F, (uint8_t []){0x00}, 1, 0},
  {0xA0, (uint8_t []){0x48}, 1, 0},
  {0xA1, (uint8_t []){0x00}, 1, 0},
  {0xA2, (uint8_t []){0x04}, 1, 0},
  {0xA3, (uint8_t []){0x02}, 1, 0},
  {0xA4, (uint8_t []){0xDC}, 1, 0},
  {0xA5, (uint8_t []){0x00}, 1, 0},
  {0xA6, (uint8_t []){0x00}, 1, 0},
  {0xA7, (uint8_t []){0x00}, 1, 0},
  {0xA8, (uint8_t []){0x48}, 1, 0},
  {0xA9, (uint8_t []){0x00}, 1, 0},
  {0xAA, (uint8_t []){0x06}, 1, 0},
  {0xAB, (uint8_t []){0x02}, 1, 0},
  {0xAC, (uint8_t []){0xDE}, 1, 0},
  {0xAD, (uint8_t []){0x00}, 1, 0},
  {0xAE, (uint8_t []){0x00}, 1, 0},
  {0xAF, (uint8_t []){0x00}, 1, 0},
  {0xB0, (uint8_t []){0x48}, 1, 0},
  {0xB1, (uint8_t []){0x00}, 1, 0},
  {0xB2, (uint8_t []){0x08}, 1, 0},
  {0xB3, (uint8_t []){0x02}, 1, 0},
  {0xB4, (uint8_t []){0xE0}, 1, 0},
  {0xB5, (uint8_t []){0x00}, 1, 0},
  {0xB6, (uint8_t []){0x00}, 1, 0},
  {0xB7, (uint8_t []){0x00}, 1, 0},
  {0xB8, (uint8_t []){0x48}, 1, 0},
  {0xB9, (uint8_t []){0x00}, 1, 0},
  {0xBA, (uint8_t []){0x0A}, 1, 0},
  {0xBB, (uint8_t []){0x02}, 1, 0},
  {0xBC, (uint8_t []){0xE2}, 1, 0},
  {0xBD, (uint8_t []){0x00}, 1, 0},
  {0xBE, (uint8_t []){0x00}, 1, 0},
  {0xBF, (uint8_t []){0x00}, 1, 0},
  {0xC0, (uint8_t []){0x12}, 1, 0},
  {0xC1, (uint8_t []){0xAA}, 1, 0},
  {0xC2, (uint8_t []){0x65}, 1, 0},
  {0xC3, (uint8_t []){0x74}, 1, 0},
  {0xC4, (uint8_t []){0x47}, 1, 0},
  {0xC5, (uint8_t []){0x56}, 1, 0},
  {0xC6, (uint8_t []){0x00}, 1, 0},
  {0xC7, (uint8_t []){0x88}, 1, 0},
  {0xC8, (uint8_t []){0x99}, 1, 0},
  {0xC9, (uint8_t []){0x33}, 1, 0},
  {0xD0, (uint8_t []){0x21}, 1, 0},
  {0xD1, (uint8_t []){0xAA}, 1, 0},
  {0xD2, (uint8_t []){0x65}, 1, 0},
  {0xD3, (uint8_t []){0x74}, 1, 0},
  {0xD4, (uint8_t []){0x47}, 1, 0},
  {0xD5, (uint8_t []){0x56}, 1, 0},
  {0xD6, (uint8_t []){0x00}, 1, 0},
  {0xD7, (uint8_t []){0x88}, 1, 0},
  {0xD8, (uint8_t []){0x99}, 1, 0},
  {0xD9, (uint8_t []){0x33}, 1, 0},
  {0xF3, (uint8_t []){0x01}, 1, 0},
  {0xF0, (uint8_t []){0x00}, 1, 0},
  {0xF0, (uint8_t []){0x01}, 1, 0},
  {0xF1, (uint8_t []){0x01}, 1, 0},
  {0xA0, (uint8_t []){0x0B}, 1, 0},
  {0xA3, (uint8_t []){0x2A}, 1, 0},
  {0xA5, (uint8_t []){0xC3}, 1, 1},
  {0xA3, (uint8_t []){0x2B}, 1, 0},
  {0xA5, (uint8_t []){0xC3}, 1, 1},
  {0xA3, (uint8_t []){0x2C}, 1, 0},
  {0xA5, (uint8_t []){0xC3}, 1, 1},
  {0xA3, (uint8_t []){0x2D}, 1, 0},
  {0xA5, (uint8_t []){0xC3}, 1, 1},
  {0xA3, (uint8_t []){0x2E}, 1, 0},
  {0xA5, (uint8_t []){0xC3}, 1, 1},
  {0xA3, (uint8_t []){0x2F}, 1, 0},
  {0xA5, (uint8_t []){0xC3}, 1, 1},
  {0xA3, (uint8_t []){0x30}, 1, 0},
  {0xA5, (uint8_t []){0xC3}, 1, 1},
  {0xA3, (uint8_t []){0x31}, 1, 0},
  {0xA5, (uint8_t []){0xC3}, 1, 1},
  {0xA3, (uint8_t []){0x32}, 1, 0},
  {0xA5, (uint8_t []){0xC3}, 1, 1},
  {0xA3, (uint8_t []){0x33}, 1, 0},
  {0xA5, (uint8_t []){0xC3}, 1, 1},
  {0xA0, (uint8_t []){0x09}, 1, 0},
  {0xF1, (uint8_t []){0x10}, 1, 0},
  {0xF0, (uint8_t []){0x00}, 1, 0},
  {0x2A, (uint8_t []){0x00, 0x00, 0x01, 0x67}, 4, 0},
  {0x2B, (uint8_t []){0x01, 0x68, 0x01, 0x68}, 4, 0},
  {0x4D, (uint8_t []){0x00}, 1, 0},
  {0x4E, (uint8_t []){0x00}, 1, 0},
  {0x4F, (uint8_t []){0x00}, 1, 0},
  {0x4C, (uint8_t []){0x01}, 1, 10},
  {0x4C, (uint8_t []){0x00}, 1, 0},
  {0x2A, (uint8_t []){0x00, 0x00, 0x01, 0x67}, 4, 0},
  {0x2B, (uint8_t []){0x00, 0x00, 0x01, 0x67}, 4, 0},
  {0x21, (uint8_t []){0x00}, 1, 0},
  //{0x3A, (uint8_t []){0x55}, 1, 0}, // color=16
  {0x11, (uint8_t []){0x00}, 1, 120},
  {0x29, (uint8_t []){0x00}, 1, 0},
};
#endif

#if CONFIG_OBD_HW_VERSION_V3_NEW
static const st77916_lcd_init_cmd_t vendor_specific_init_new[] = {
  {0xF0, (uint8_t []){0x28}, 1, 0},
  {0xF2, (uint8_t []){0x28}, 1, 0},
  {0x73, (uint8_t []){0xF0}, 1, 0},
  {0x7C, (uint8_t []){0xD1}, 1, 0},
  {0x83, (uint8_t []){0xE0}, 1, 0},
  {0x84, (uint8_t []){0x61}, 1, 0},
  {0xF2, (uint8_t []){0x82}, 1, 0},
  {0xF0, (uint8_t []){0x00}, 1, 0},
  {0xF0, (uint8_t []){0x01}, 1, 0},
  {0xF1, (uint8_t []){0x01}, 1, 0},
  {0xB0, (uint8_t []){0x56}, 1, 0},
  {0xB1, (uint8_t []){0x4D}, 1, 0},
  {0xB2, (uint8_t []){0x24}, 1, 0},
  {0xB4, (uint8_t []){0x87}, 1, 0},
  {0xB5, (uint8_t []){0x44}, 1, 0},
  {0xB6, (uint8_t []){0x8B}, 1, 0},
  {0xB7, (uint8_t []){0x40}, 1, 0},
  {0xB8, (uint8_t []){0x86}, 1, 0},
  {0xBA, (uint8_t []){0x00}, 1, 0},
  {0xBB, (uint8_t []){0x08}, 1, 0},
  {0xBC, (uint8_t []){0x08}, 1, 0},
  {0xBD, (uint8_t []){0x00}, 1, 0},
  {0xC0, (uint8_t []){0x80}, 1, 0},
  {0xC1, (uint8_t []){0x10}, 1, 0},
  {0xC2, (uint8_t []){0x37}, 1, 0},
  {0xC3, (uint8_t []){0x80}, 1, 0},
  {0xC4, (uint8_t []){0x10}, 1, 0},
  {0xC5, (uint8_t []){0x37}, 1, 0},
  {0xC6, (uint8_t []){0xA9}, 1, 0},
  {0xC7, (uint8_t []){0x41}, 1, 0},
  {0xC8, (uint8_t []){0x01}, 1, 0},
  {0xC9, (uint8_t []){0xA9}, 1, 0},
  {0xCA, (uint8_t []){0x41}, 1, 0},
  {0xCB, (uint8_t []){0x01}, 1, 0},
  {0xD0, (uint8_t []){0x91}, 1, 0},
  {0xD1, (uint8_t []){0x68}, 1, 0},
  {0xD2, (uint8_t []){0x68}, 1, 0},
  {0xF5, (uint8_t []){0x00, 0xA5}, 2, 0},
  {0xDD, (uint8_t []){0x4F}, 1, 0},
  {0xDE, (uint8_t []){0x4F}, 1, 0},
  {0xF1, (uint8_t []){0x10}, 1, 0},
  {0xF0, (uint8_t []){0x00}, 1, 0},
  {0xF0, (uint8_t []){0x02}, 1, 0},
  {0xE0, (uint8_t []){0xF0, 0x0A, 0x10, 0x09, 0x09, 0x36, 0x35, 0x33, 0x4A, 0x29, 0x15, 0x15, 0x2E, 0x34}, 14, 0},
  {0xE1, (uint8_t []){0xF0, 0x0A, 0x0F, 0x08, 0x08, 0x05, 0x34, 0x33, 0x4A, 0x39, 0x15, 0x15, 0x2D, 0x33}, 14, 0},
  {0xF0, (uint8_t []){0x10}, 1, 0},
  {0xF3, (uint8_t []){0x10}, 1, 0},
  {0xE0, (uint8_t []){0x07}, 1, 0},
  {0xE1, (uint8_t []){0x00}, 1, 0},
  {0xE2, (uint8_t []){0x00}, 1, 0},
  {0xE3, (uint8_t []){0x00}, 1, 0},
  {0xE4, (uint8_t []){0xE0}, 1, 0},
  {0xE5, (uint8_t []){0x06}, 1, 0},
  {0xE6, (uint8_t []){0x21}, 1, 0},
  {0xE7, (uint8_t []){0x01}, 1, 0},
  {0xE8, (uint8_t []){0x05}, 1, 0},
  {0xE9, (uint8_t []){0x02}, 1, 0},
  {0xEA, (uint8_t []){0xDA}, 1, 0},
  {0xEB, (uint8_t []){0x00}, 1, 0},
  {0xEC, (uint8_t []){0x00}, 1, 0},
  {0xED, (uint8_t []){0x0F}, 1, 0},
  {0xEE, (uint8_t []){0x00}, 1, 0},
  {0xEF, (uint8_t []){0x00}, 1, 0},
  {0xF8, (uint8_t []){0x00}, 1, 0},
  {0xF9, (uint8_t []){0x00}, 1, 0},
  {0xFA, (uint8_t []){0x00}, 1, 0},
  {0xFB, (uint8_t []){0x00}, 1, 0},
  {0xFC, (uint8_t []){0x00}, 1, 0},
  {0xFD, (uint8_t []){0x00}, 1, 0},
  {0xFE, (uint8_t []){0x00}, 1, 0},
  {0xFF, (uint8_t []){0x00}, 1, 0},
  {0x60, (uint8_t []){0x40}, 1, 0},
  {0x61, (uint8_t []){0x04}, 1, 0},
  {0x62, (uint8_t []){0x00}, 1, 0},
  {0x63, (uint8_t []){0x42}, 1, 0},
  {0x64, (uint8_t []){0xD9}, 1, 0},
  {0x65, (uint8_t []){0x00}, 1, 0},
  {0x66, (uint8_t []){0x00}, 1, 0},
  {0x67, (uint8_t []){0x00}, 1, 0},
  {0x68, (uint8_t []){0x00}, 1, 0},
  {0x69, (uint8_t []){0x00}, 1, 0},
  {0x6A, (uint8_t []){0x00}, 1, 0},
  {0x6B, (uint8_t []){0x00}, 1, 0},
  {0x70, (uint8_t []){0x40}, 1, 0},
  {0x71, (uint8_t []){0x03}, 1, 0},
  {0x72, (uint8_t []){0x00}, 1, 0},
  {0x73, (uint8_t []){0x42}, 1, 0},
  {0x74, (uint8_t []){0xD8}, 1, 0},
  {0x75, (uint8_t []){0x00}, 1, 0},
  {0x76, (uint8_t []){0x00}, 1, 0},
  {0x77, (uint8_t []){0x00}, 1, 0},
  {0x78, (uint8_t []){0x00}, 1, 0},
  {0x79, (uint8_t []){0x00}, 1, 0},
  {0x7A, (uint8_t []){0x00}, 1, 0},
  {0x7B, (uint8_t []){0x00}, 1, 0},
  {0x80, (uint8_t []){0x48}, 1, 0},
  {0x81, (uint8_t []){0x00}, 1, 0},
  {0x82, (uint8_t []){0x06}, 1, 0},
  {0x83, (uint8_t []){0x02}, 1, 0},
  {0x84, (uint8_t []){0xD6}, 1, 0},
  {0x85, (uint8_t []){0x04}, 1, 0},
  {0x86, (uint8_t []){0x00}, 1, 0},
  {0x87, (uint8_t []){0x00}, 1, 0},
  {0x88, (uint8_t []){0x48}, 1, 0},
  {0x89, (uint8_t []){0x00}, 1, 0},
  {0x8A, (uint8_t []){0x08}, 1, 0},
  {0x8B, (uint8_t []){0x02}, 1, 0},
  {0x8C, (uint8_t []){0xD8}, 1, 0},
  {0x8D, (uint8_t []){0x04}, 1, 0},
  {0x8E, (uint8_t []){0x00}, 1, 0},
  {0x8F, (uint8_t []){0x00}, 1, 0},
  {0x90, (uint8_t []){0x48}, 1, 0},
  {0x91, (uint8_t []){0x00}, 1, 0},
  {0x92, (uint8_t []){0x0A}, 1, 0},
  {0x93, (uint8_t []){0x02}, 1, 0},
  {0x94, (uint8_t []){0xDA}, 1, 0},
  {0x95, (uint8_t []){0x04}, 1, 0},
  {0x96, (uint8_t []){0x00}, 1, 0},
  {0x97, (uint8_t []){0x00}, 1, 0},
  {0x98, (uint8_t []){0x48}, 1, 0},
  {0x99, (uint8_t []){0x00}, 1, 0},
  {0x9A, (uint8_t []){0x0C}, 1, 0},
  {0x9B, (uint8_t []){0x02}, 1, 0},
  {0x9C, (uint8_t []){0xDC}, 1, 0},
  {0x9D, (uint8_t []){0x04}, 1, 0},
  {0x9E, (uint8_t []){0x00}, 1, 0},
  {0x9F, (uint8_t []){0x00}, 1, 0},
  {0xA0, (uint8_t []){0x48}, 1, 0},
  {0xA1, (uint8_t []){0x00}, 1, 0},
  {0xA2, (uint8_t []){0x05}, 1, 0},
  {0xA3, (uint8_t []){0x02}, 1, 0},
  {0xA4, (uint8_t []){0xD5}, 1, 0},
  {0xA5, (uint8_t []){0x04}, 1, 0},
  {0xA6, (uint8_t []){0x00}, 1, 0},
  {0xA7, (uint8_t []){0x00}, 1, 0},
  {0xA8, (uint8_t []){0x48}, 1, 0},
  {0xA9, (uint8_t []){0x00}, 1, 0},
  {0xAA, (uint8_t []){0x07}, 1, 0},
  {0xAB, (uint8_t []){0x02}, 1, 0},
  {0xAC, (uint8_t []){0xD7}, 1, 0},
  {0xAD, (uint8_t []){0x04}, 1, 0},
  {0xAE, (uint8_t []){0x00}, 1, 0},
  {0xAF, (uint8_t []){0x00}, 1, 0},
  {0xB0, (uint8_t []){0x48}, 1, 0},
  {0xB1, (uint8_t []){0x00}, 1, 0},
  {0xB2, (uint8_t []){0x09}, 1, 0},
  {0xB3, (uint8_t []){0x02}, 1, 0},
  {0xB4, (uint8_t []){0xD9}, 1, 0},
  {0xB5, (uint8_t []){0x04}, 1, 0},
  {0xB6, (uint8_t []){0x00}, 1, 0},
  {0xB7, (uint8_t []){0x00}, 1, 0},
  
  {0xB8, (uint8_t []){0x48}, 1, 0},
  {0xB9, (uint8_t []){0x00}, 1, 0},
  {0xBA, (uint8_t []){0x0B}, 1, 0},
  {0xBB, (uint8_t []){0x02}, 1, 0},
  {0xBC, (uint8_t []){0xDB}, 1, 0},
  {0xBD, (uint8_t []){0x04}, 1, 0},
  {0xBE, (uint8_t []){0x00}, 1, 0},
  {0xBF, (uint8_t []){0x00}, 1, 0},
  {0xC0, (uint8_t []){0x10}, 1, 0},
  {0xC1, (uint8_t []){0x47}, 1, 0},
  {0xC2, (uint8_t []){0x56}, 1, 0},
  {0xC3, (uint8_t []){0x65}, 1, 0},
  {0xC4, (uint8_t []){0x74}, 1, 0},
  {0xC5, (uint8_t []){0x88}, 1, 0},
  {0xC6, (uint8_t []){0x99}, 1, 0},
  {0xC7, (uint8_t []){0x01}, 1, 0},
  {0xC8, (uint8_t []){0xBB}, 1, 0},
  {0xC9, (uint8_t []){0xAA}, 1, 0},
  {0xD0, (uint8_t []){0x10}, 1, 0},
  {0xD1, (uint8_t []){0x47}, 1, 0},
  {0xD2, (uint8_t []){0x56}, 1, 0},
  {0xD3, (uint8_t []){0x65}, 1, 0},
  {0xD4, (uint8_t []){0x74}, 1, 0},
  {0xD5, (uint8_t []){0x88}, 1, 0},
  {0xD6, (uint8_t []){0x99}, 1, 0},
  {0xD7, (uint8_t []){0x01}, 1, 0},
  {0xD8, (uint8_t []){0xBB}, 1, 0},
  {0xD9, (uint8_t []){0xAA}, 1, 0},
  {0xF3, (uint8_t []){0x01}, 1, 0},
  {0xF0, (uint8_t []){0x00}, 1, 0},
  {0x21, (uint8_t []){0x00}, 1, 0},
  {0x11, (uint8_t []){0x00}, 1, 120},
  {0x29, (uint8_t []){0x00}, 1, 0},  
};
#endif
void ST77916_Reset(){
#if CONFIG_OBD_HW_VERSION_V1_WAVESHARE
#if CONFIG_GAUGE_BOARD_LCD185
  /* ESP32-S3-LCD-1.85 routes LCD_RST to TCA9554 EXIO2. The expander is
     initialized by the slave entry point before the panel is installed. */
  Set_EXIO(TCA9554_EXIO2, false);
  vTaskDelay(pdMS_TO_TICKS(10));
  Set_EXIO(TCA9554_EXIO2, true);
  vTaskDelay(pdMS_TO_TICKS(50));
#else
  /* 1.85B routes LCD_RST directly to GPIO3; it has no TCA9554 reset path. */
  gpio_config_t rst_config = {
    .mode = GPIO_MODE_OUTPUT,
    .pin_bit_mask = 1ULL << EXAMPLE_LCD_PIN_NUM_RST,
  };
  gpio_config(&rst_config);
  gpio_set_level(EXAMPLE_LCD_PIN_NUM_RST, 0);
  vTaskDelay(pdMS_TO_TICKS(10));
  gpio_set_level(EXAMPLE_LCD_PIN_NUM_RST, 1);
  vTaskDelay(pdMS_TO_TICKS(50));
#endif
#else
  /* New boards: LCD reset is a direct GPIO (EXAMPLE_LCD_PIN_NUM_RST=47),
     already handled by esp_lcd_panel_reset() inside QSPI_Init(). */
#endif
}
esp_err_t LCD_Init(void) {
  ST77916_Init();
  Backlight_Init();
  return Touch_Init();
}

int QSPI_Init(void){
  static const spi_bus_config_t host_config = {            
    .data0_io_num = ESP_PANEL_LCD_SPI_IO_DATA0,                    
    .data1_io_num = ESP_PANEL_LCD_SPI_IO_DATA1,                   
    .sclk_io_num = ESP_PANEL_LCD_SPI_IO_SCK,                   
    .data2_io_num = ESP_PANEL_LCD_SPI_IO_DATA2,                    
    .data3_io_num = ESP_PANEL_LCD_SPI_IO_DATA3,                    
    .data4_io_num = -1,                       
    .data5_io_num = -1,                      
    .data6_io_num = -1,                       
    .data7_io_num = -1,                      
    .max_transfer_sz = ESP_PANEL_HOST_SPI_MAX_TRANSFER_SIZE, 
    .flags = SPICOMMON_BUSFLAG_MASTER,       
    .intr_flags = 0,                            
  };
  if(spi_bus_initialize(ESP_PANEL_HOST_SPI_ID_DEFAULT, &host_config, SPI_DMA_CH_AUTO) != ESP_OK){
    ESP_LOGE(TAG_LCD, "The SPI initialization failed.");
    return 0;
  }
  ESP_LOGD(TAG_LCD, "The SPI initialization succeeded.");
  
  esp_lcd_panel_io_spi_config_t io_config ={
    .cs_gpio_num = ESP_PANEL_LCD_SPI_IO_CS,               
    .dc_gpio_num = -1,                  
    .spi_mode = ESP_PANEL_LCD_SPI_MODE,                     
    .pclk_hz = 3 * 1000 * 1000,
    .trans_queue_depth = ESP_PANEL_LCD_SPI_TRANS_QUEUE_SZ,            
    .on_color_trans_done = s_flush_cb,                            
    .user_ctx = s_flush_ctx,                       
    .lcd_cmd_bits = ESP_PANEL_LCD_SPI_CMD_BITS,                 
    .lcd_param_bits = ESP_PANEL_LCD_SPI_PARAM_BITS,                
    .flags = {                          
      .dc_low_on_data = 0,            
      .octal_mode = 0,                
      .quad_mode = 1,                 
      .sio_mode = 0,                  
      .lsb_first = 0,                 
      .cs_high_active = 0,            
    },                                  
  };
  esp_lcd_panel_io_handle_t io_handle = NULL;
  if(esp_lcd_new_panel_io_spi((esp_lcd_spi_bus_handle_t)ESP_PANEL_HOST_SPI_ID_DEFAULT, &io_config, &io_handle) != ESP_OK){
    ESP_LOGE(TAG_LCD, "Failed to set LCD communication parameters -- SPI");
    return 0;
  }
  ESP_LOGD(TAG_LCD, "LCD communication parameters are set successfully -- SPI");

  ESP_LOGD(TAG_LCD, "Install LCD driver of st77916");
  st77916_vendor_config_t vendor_config={
    .flags = {
      .use_qspi_interface = 1,
    },
  };
  esp_err_t ret;
  int lcd_cmd = 0x04;
  uint8_t register_data[4] = {0};   // keep all-zero on read failure, so uninitialized stack data isn't compared against the vendor signature
  size_t param_size = sizeof(register_data);
  lcd_cmd &= 0xff;
  lcd_cmd <<= 8;
  lcd_cmd |= LCD_OPCODE_READ_CMD << 24;  // Use the read opcode instead of write
  ret = esp_lcd_panel_io_rx_param(io_handle, lcd_cmd, register_data, param_size); 
  if (ret == ESP_OK) {
    ESP_LOGI(TAG_LCD, "Register 0x04 data: %02x %02x %02x %02x", register_data[0], register_data[1], register_data[2], register_data[3]);
  } else {
    ESP_LOGW(TAG_LCD, "Failed to read register 0x04, error code: %d", ret);
  } 
  // panel_io_spi_del(io_handle);
  io_config.pclk_hz = ESP_PANEL_LCD_SPI_CLK_HZ;
  if(esp_lcd_new_panel_io_spi((esp_lcd_spi_bus_handle_t)ESP_PANEL_HOST_SPI_ID_DEFAULT, &io_config, &io_handle) != ESP_OK){
    ESP_LOGE(TAG_LCD, "Failed to set LCD communication parameters -- SPI");
    return 0;
  }
  ESP_LOGD(TAG_LCD, "LCD communication parameters are set successfully -- SPI");
  
  // Each hardware version has its own dedicated init table (see the three
  // version-guarded vendor_specific_init_new[] definitions above). Apply it
  // UNCONDITIONALLY — do not rely on the register read below, which may fail
  // or return an unknown panel ID (falling back to the driver's default table
  // previously made V3's panel not display at all).
#if CONFIG_OBD_HW_VERSION_V2_NEW
  vendor_config.init_cmds = vendor_specific_init_new;   // new board A: v1 sequence (0xF0=0x08)
  vendor_config.init_cmds_size = sizeof(vendor_specific_init_new) / sizeof(st77916_lcd_init_cmd_t);
  ESP_LOGI(TAG_LCD, "Hardware V2: applying v1 init sequence (0xF0=0x08).");
#elif CONFIG_OBD_HW_VERSION_V3_NEW
  vendor_config.init_cmds = vendor_specific_init_new;   // new board B: v2 sequence (0xF0=0x28)
  vendor_config.init_cmds_size = sizeof(vendor_specific_init_new) / sizeof(st77916_lcd_init_cmd_t);
  ESP_LOGI(TAG_LCD, "Hardware V3: applying v2 init sequence (0xF0=0x28).");
#else
  vendor_config.init_cmds = vendor_specific_init_new;   // V1 Waveshare: v2 sequence (0xF0=0x28)
  vendor_config.init_cmds_size = sizeof(vendor_specific_init_new) / sizeof(st77916_lcd_init_cmd_t);
  ESP_LOGI(TAG_LCD, "Hardware V1: applying v2 init sequence (0xF0=0x28).");
#endif

  esp_lcd_panel_dev_config_t panel_config={
    .reset_gpio_num = EXAMPLE_LCD_PIN_NUM_RST,                                
    .rgb_ele_order = LCD_RGB_ELEMENT_ORDER_RGB,                   
    // .data_endian = LCD_RGB_DATA_ENDIAN_LITTLE,                       
    .bits_per_pixel = EXAMPLE_LCD_COLOR_BITS,                                 
    .flags = {                                                    
      .reset_active_high = 0,                                   
    },                                                            
    .vendor_config = (void *) &vendor_config,                                  
  };
  esp_lcd_new_panel_st77916(io_handle, &panel_config, &panel_handle);

  esp_lcd_panel_reset(panel_handle);
  esp_lcd_panel_init(panel_handle);
  // esp_lcd_panel_invert_color(panel_handle,false);

  esp_lcd_panel_disp_on_off(panel_handle, true);
  // LCD init complete
  return 1;
}

void ST77916_Init() {
  ST77916_Reset();
  if(!QSPI_Init()){
    ESP_LOGE(TAG_LCD, "ST77916 failed to be initialized");
  }
}

//////////////////////////////////////////////////////////////////////////////////////////////////////////////////////////////////////////////////////////////////////////////////////////////////////////////////////////////////////////////
// Backlight program

uint8_t LCD_Backlight = 70;
static ledc_channel_config_t ledc_channel;
void Backlight_Init(void)
{
    ESP_LOGD(TAG_LCD, "Turn off LCD backlight");
    gpio_config_t bk_gpio_config = {
        .mode = GPIO_MODE_OUTPUT,
        .pin_bit_mask = 1ULL << EXAMPLE_LCD_PIN_NUM_BK_LIGHT
    };
    ESP_ERROR_CHECK(gpio_config(&bk_gpio_config));

    ledc_timer_config_t ledc_timer = {
        .duty_resolution = LEDC_TIMER_13_BIT,
        .freq_hz = 5000,
        .speed_mode = LEDC_LS_MODE,
        .timer_num = LEDC_HS_TIMER,
        .clk_cfg = LEDC_AUTO_CLK
    };
    ledc_timer_config(&ledc_timer);

    ledc_channel.channel    = LEDC_HS_CH0_CHANNEL;
    ledc_channel.duty       = 0;
    ledc_channel.gpio_num   = EXAMPLE_LCD_PIN_NUM_BK_LIGHT;
    ledc_channel.speed_mode = LEDC_LS_MODE;
    ledc_channel.timer_sel  = LEDC_HS_TIMER;
    ledc_channel_config(&ledc_channel);
    ledc_fade_func_install(0);
    
    Set_Backlight(LCD_Backlight);      //0~100    
}
void Set_Backlight(uint8_t Light)
{   
    if(Light > Backlight_MAX) Light = Backlight_MAX;
    uint16_t Duty = LEDC_MAX_Duty-(81*(Backlight_MAX-Light));
    if(Light == 0) 
        Duty = 0;
    ledc_set_duty(ledc_channel.speed_mode, ledc_channel.channel, Duty);
    ledc_update_duty(ledc_channel.speed_mode, ledc_channel.channel);
}
// end Backlight program
