omniscientjoker/obd_brz_gauge/main/bsp_obd_dsp/lcd_driver/ST77916.h

#pragma once
#include "esp_err.h"
#include "esp_log.h"
#include <stdio.h>
#include <stdlib.h>
#include <string.h>
#include "freertos/FreeRTOS.h"
#include "freertos/task.h"
#include "driver/gpio.h"
#include "driver/spi_master.h"
#include "esp_timer.h"
#include "esp_lcd_panel_io.h"
#include "esp_lcd_panel_io_interface.h"
#include "esp_intr_alloc.h"
#include "esp_lcd_panel_ops.h"
#include "esp_lcd_panel_vendor.h"
#include "lvgl.h"
#include "driver/ledc.h"

#include "bsp_obd_dsp/lcd_driver/esp_lcd_st77916/esp_lcd_st77916.h"
#include "bsp_obd_dsp/touch_driver/CST816.h"
#include "bsp_obd_dsp/exio/TCA9554PWR.h"


#define EXAMPLE_LCD_WIDTH                   (360)
#define EXAMPLE_LCD_HEIGHT                  (360)
#define EXAMPLE_LCD_COLOR_BITS              (16)

#define ESP_PANEL_HOST_SPI_ID_DEFAULT       (SPI2_HOST)
#define ESP_PANEL_LCD_SPI_MODE              (0)                   // 0/1/2/3, typically set to 0
#if CONFIG_OBD_HW_VERSION_V2_NEW || CONFIG_OBD_HW_VERSION_V3_NEW
#define ESP_PANEL_LCD_SPI_CLK_HZ            (50 * 1000 * 1000)    // New panels: match reference driver (scr_st77916.h TFT_SPI_FREQ_HZ = 50MHz)
#else
#define ESP_PANEL_LCD_SPI_CLK_HZ            (80 * 1000 * 1000)    // Waveshare panel validated at 80MHz
#endif
#define ESP_PANEL_LCD_SPI_TRANS_QUEUE_SZ    (10)                  // Typically set to 10
#define ESP_PANEL_LCD_SPI_CMD_BITS          (32)                  // Typically set to 32
#define ESP_PANEL_LCD_SPI_PARAM_BITS        (8)                   // Typically set to 8

#define ESP_PANEL_LCD_SPI_IO_TE             (18)

#if CONFIG_OBD_HW_VERSION_V2_NEW || CONFIG_OBD_HW_VERSION_V3_NEW
/* New boards (V2/V3): same pins, only the ST77916 init sequence differs (v1/v2).
   LCD reset is a direct GPIO; no TCA9554 IO expander / ADS1115. */
#define ESP_PANEL_LCD_SPI_IO_SCK            (9)
#define ESP_PANEL_LCD_SPI_IO_DATA0          (11)
#define ESP_PANEL_LCD_SPI_IO_DATA1          (12)
#define ESP_PANEL_LCD_SPI_IO_DATA2          (13)
#define ESP_PANEL_LCD_SPI_IO_DATA3          (14)
#define ESP_PANEL_LCD_SPI_IO_CS             (10)
#define EXAMPLE_LCD_PIN_NUM_RST             (47)    // direct GPIO
#define EXAMPLE_LCD_PIN_NUM_BK_LIGHT        (15)
#else
/* Waveshare ESP32-S3-Touch-LCD-1.85B */
#define ESP_PANEL_LCD_SPI_IO_SCK            (40)
#define ESP_PANEL_LCD_SPI_IO_DATA0          (46)
#define ESP_PANEL_LCD_SPI_IO_DATA1          (45)
#define ESP_PANEL_LCD_SPI_IO_DATA2          (42)
#define ESP_PANEL_LCD_SPI_IO_DATA3          (41)
#define ESP_PANEL_LCD_SPI_IO_CS             (21)
#if CONFIG_GAUGE_BOARD_LCD185
#define EXAMPLE_LCD_PIN_NUM_RST             (-1)    // LCD_RST is TCA9554 EXIO2
#else
#define EXAMPLE_LCD_PIN_NUM_RST             (3)     // LCD_RST (direct GPIO)
#endif
#define EXAMPLE_LCD_PIN_NUM_BK_LIGHT        (5)
#endif

#ifndef EXAMPLE_LCD_BK_LIGHT_ON_LEVEL
#define EXAMPLE_LCD_BK_LIGHT_ON_LEVEL       (1)
#define EXAMPLE_LCD_BK_LIGHT_OFF_LEVEL !EXAMPLE_LCD_BK_LIGHT_ON_LEVEL
#endif

// Fits one 40-line render band (28.8KB), transferred in a single transaction per refresh to cut
// transaction overhead and raise frame rate. (Smaller than the full-frame/43KB that caused
// glitching before; if it still glitches, this panel's single-transfer limit is lower — fall back to 2048.)
#define ESP_PANEL_HOST_SPI_MAX_TRANSFER_SIZE   (EXAMPLE_LCD_WIDTH * 40 * 2 + 64)

#define LEDC_HS_TIMER          LEDC_TIMER_0
#define LEDC_LS_MODE           LEDC_LOW_SPEED_MODE
#define LEDC_HS_CH0_GPIO       EXAMPLE_LCD_PIN_NUM_BK_LIGHT
#define LEDC_HS_CH0_CHANNEL    LEDC_CHANNEL_0
#define LEDC_ResolutionRatio   LEDC_TIMER_13_BIT
#define LEDC_MAX_Duty          ((1 << LEDC_ResolutionRatio) - 1)
#define Backlight_MAX   100      

extern esp_lcd_panel_handle_t panel_handle;
extern uint8_t LCD_Backlight;

/**
 * @brief Set the LVGL flush-complete callback (call before LCD_Init)
 * @param cb   callback function pointer, invoked when the DMA transfer completes
 * @param ctx  user context (typically &disp_drv)
 */
void LCD_SetFlushCallback(bool (*cb)(esp_lcd_panel_io_handle_t, esp_lcd_panel_io_event_data_t *, void *), void *ctx);

void ST77916_Init();

esp_err_t LCD_Init(void);                // Initializes the panel, backlight, and optional touch controller.

void Backlight_Init(void);                             // Initialize the LCD backlight, which has been called in the LCD_Init function, ignore it                                                         
void Set_Backlight(uint8_t Light);                   // Call this function to adjust the brightness of the backlight. The value of the parameter Light ranges from 0 to 100
