omniscientjoker/obd_brz_gauge/(commit log)

2026-10-06 fix
    支持 1.85b 版本屏幕
    [CST816.c, CST816.h, ST77916.c, ST77916.h, app_main.c, elm327_ble_client.c, espnow_link.c, ford_tpms_candidate.c]
2026-10-09 add sd card load
    添加sd卡加载资源 支持 警告音 音视频 播放
2026-10-10 fix add 油量提示 增加异常告警
    高转速
    速度超限制
    电瓶电压低
    车胎胎压异常
    [app_main.c, boot_block_player.c, elm327_ble_client.c, gen_release.py, gen_vehicle_fuel_config.py, media_alert.c, media_alert.h, nvs_storage.c]
2026-10-11 add 添加油量展示 剩余油量 使用油量
2026-10-11 fix 修复 sd 卡文件 扫描逻辑
    [media_alert.c, nvs_storage.h, sd_media_manager.c, sd_media_manager.h, ui_ScreenPageAlertMedia.c, wav_player.c]
2026-10-11 fix 告警音频 视频 修复
    [app_main.c, convert_alert_video.py, es8311_audio.c, nvs_storage.c, nvs_storage.h, sd_media_manager.c, sd_media_manager.h, ui_ScreenPageAlertMedia.c]
2026-10-30 add 添加 三连表 底座模型 供电电路板
2026-10-30 add 整理打包脚本 目录
